MiiGoto/reaction-wheel-pendulum/mechanical/README.md

# Mechanical scope

候補寸法: 振子長約220 mm、wheel径約130 mm、wheel質量約90 g。寸法基準・材料・厚さ・支点位置・motor mounting・軸受・取付・clearanceはTBD。

次にCADと実測で重心、慣性、摩擦、wheel balanceを記録します。最大rpm、遠心力、保存energy、固定治具、guard、stopperを決めてから回転試験へ進みます。現段階では加工用図面やSTLを作成していません。
