MiiGoto/reaction-wheel-pendulum/docs/design_notes.md

# Design notes and decisions

## 2026-10-02: initial scope

**確定**: 一つのrepositoryでhardware/firmware/simulation/mechanical/docs/testを管理。今回の停止地点は初期構築。

**候補**: STM32G431、外部ESC/B-G431B-ESC1、3.3 V logic、補助5 V、AS5600。exact part/package、motor、sensor、bus方式は未選定。

**判断理由**: モータ・機構・正負トルク・センサ遅延が未確定のため、power stageや最終MCU pin配置の作り込みを先行しない。

## KiCad initialization

新規の `.kicad_pro` と `.kicad_sch` を作成。回路図の矩形・文字・破線は概念ブロックで、接続netや部品ではない。既存のKiCadファイルは編集していない。新規ファイルもnative CLIで読み込み、SVG出力とERCを検証する。

ブロック: Power input、input protection、5 V/3.3 V regulation、STM32G431、SWD、UART debug、CAN/FDCAN、IMU、encoder interface、motor/ESC interface、LEDs、buttons、test points。

PCBファイルは未作成。board outline・stackup・placement・routing・製造物は未実施。

## ERC warnings

意図的なwarning除外は設定しない。実行結果は `validation.md` に記録する。部品/netがない段階の0件は概念ファイルの初期チェックに過ぎず、電源/通信/実装の安全性検証ではない。次にsymbolsを追加した時点で改めて全severityのERCを実行する。

## Open design issues

通常のhobby ESCの速度commandだけで倒立制御の必要な正負トルク・低速応答を満たせるかは未確認。ホイールの速度飽和、回生、command timeout、sensorlessの低速挙動を評価する。AS5600をホイール高速測定に使えるとも仮定しない。

## 2026-10-02: Task 2 MCU / power / SWD

### Confirmed selection and package verification

- U1: **STM32G431RBT6**、LQFP64、10x10 mm body、0.5 mm pitch、64 lead、exposed padなし。Flash 128 KB、SRAM 22 KB + CCM SRAM 10 KB。ordering codeはDS12589 Table 101で照合。
- LQFP48 STM32G431CBT6も候補だが追加GPIO・clock・将来I/Oの余裕を優先しLQFP64を採用。BGA/QFNよりleadを目視でき、手実装・修理が容易。LQFP80/100は今回不要。
- KiCad 10.0.6 `MCU_ST_STM32G4:STM32G431RBTx` を使用。aliasの親symbolを解決して全64 physical pinをDS12589 Figure 10/Table 12のLQFP64列と照合。**64/64一致**。PG10はpin 7のNRST機能として使用し、BOOT0はPB8 pin 61。全番号はpinout表に記録。
- `Package_QFP:LQFP-64_10x10mm_P0.5mm`: 64 pad、pitch 0.5、pin 1はtop view左辺上端（角印）、番号は反時計回り、EPなし。DS12589 §6.5の10 mm body/12 mm lead spanと照合。padはleadの外側へ伸びるsolder landでありbody寸法と同一ではない。PCB設計時に採用実部品のdrawingと再照合する。
- 予約済み機能は同時使用可能なGPIOへ配置。PA13/14とPB3をdebug用に維持。PA11/12はFDCANの予約で、USBも同じpairを使うため同時使用には再割当が必要。CubeMX/DMA/clock詳細は後続タスク。

### MCU supplies and analog strategy

VDD 16/32/48/64、VBAT 1、VDDA 29、VREF+ 28を+3V3へ直結。VSS 15/31/47/63、VSSA 27をGNDへ接続。専用VREF-は外部padなし（内部でVSSAへbond）。VCAP/VDDIO2はこのpackageにないため追加しない。

DS12589 Figure 16のdevice-specific値を採用: VDD各100 nF + bulk 4.7 uF、VDDA 10 nF + 1 uF、VREF+ 100 nF + 1 uF。AN5093の一般例（bulk 10 uF / VDDA 100 nF）との値の違いはdevice datasheetを優先する。VBATはbattery未使用として100 nFを追加（AN5093 §2.1.3）。全capacitorは無極性ceramic。

初号機はVDDA/VREF+を同じ3.3 Vに直結しferrite/RC/LCは追加しない。AN5093 Table 10はferriteをoptionalとし直結を許容する。VDD/VDDAの起動差を作らず簡単に実装できる。ADC絶対精度はLDO ripple・基準誤差・ground returnの影響を受けるため未保証。**VREFBUFは無効/high impedanceのまま**（外部railへdriveしない）。精度要求と実測noiseに応じ将来見直す。

### Clock / reset / boot

- 外部HSE/LSEなし。内部HSI16と必要に応じPLLを使用する方針。初期起動・SWDには十分でcrystal/load-cap選定を省ける。制御周期、UART baud、FDCANのbit timingと温度範囲は未検証。将来FDCAN導入前にclock toleranceを評価し必要ならPF0/PF1にHSE追加。PC14/15もLSE予備として予約。USB clock対応を保証しない。
- NRST: MCU内部pull-up + C13 100 nF（AN5093 §2.2.3）、J2 pin 5からST-LINK reset、TP5で測定。external pull-up/reset buttonは初号機に追加しない。NRST_MODE=3（reset I/O default）を維持しPG10 GPIOへの変更を禁止。
- BOOT0: R1 10k pulldown、TP6でアクセス。通常flash起動の設定はnSWBOOT0=0/nBOOT0=1をbring-upで確認する。hardware pulldownはpin-controlled boot時にもlowを保つ。未書込flashのempty-checkによるsystem bootloader移行は故障ではない。実際のoption bytesは未設定。nBOOT1/BOOT_LOCK/RDPを不用意に変更しない。

### Power selection / protection / thermal assumptions

- 外部安定化5 V入力を採用、**J1実測4.8–5.25 V**、benchで供給側current limit <=150 mA。モータpower stageは分離、battery電圧は未確定のまま。
- U2 **AP2112K-3.3TRG1** / SOT25（SOT-23-5）、device rating 600 mAだがboard初期load budgetは**100 mA**。MCP1700級低電流LDOやbuckも比較対象とし、手実装できる5-lead package、簡単なEN接続、1 uF ceramicで安定するAP2112を採用。buckの効率は高いが100 mA初期条件には部品・switching noise・配線負担が増える。調達在庫は未確認。
- 公式AP2112 pinoutとKiCadを照合: 1 VIN、2 GND、3 EN、4 NC、5 VOUT。ENはVINへ直結、NCはno-connect。標準footprint SOT-23-5、5 pad、0.95 mm pitch、EPなし。top view pin 1左上/2左中央/3左下/4右下/5右上。
- D1 **Vishay SS14-E3/61T**、SMA/DO-214AC。anode pad 2=+5V_IN、cathode pad 1=+5V_PROTECTED。datasheet VF max 0.5 V @1 Aを保守的headroom計算に使用: 4.8−0.5=4.3 V、3.3 Vに1.0 V margin。AP2112 max dropout 0.4 V @600 mA以下。保護後VINは6 V recommended maximum以下とする。
- 最悪5.25 V、diode dropをゼロとしてLDO loss=(5.25−3.3)*0.1≈0.195 W。datasheet SOT25 thetaJA 184 °C/Wからrise≈36 °C（reference PCB依存）。室温25 °Cで約61 °Cの見積り。高温・600 mA・実PCB温度を保証する値ではなく、負荷追加時に再予算化する。
- C1/C2 nominal 4.7 uF /10 V/X7R/0805を使用。AP2112指定のeffective >=1 uFをDC bias・tolerance・温度込みで満たす実MPNを調達時に確認する。4.7 uF nominalだけでは条件充足を保証しない。
- 直列Schottkyで逆接対策を行う。current-limited short bench supply前提のためpolyfuse/TVSは追加しない。長い配線、motor rail、surge/ESD/独立電源からのbackfeedは未対策。VTrefから給電しない。電源未投入時にSWD信号をdriveしてphantom powerを起こさない。

### Debug, indicator and test access

J2はcustom 1x6/2.54 mm header。ARM 10-pin/1.27 mmはcompactで標準adapter向きだが、初号機はST-LINK個別wire接続が容易な2.54 mmを採用。標準ARM cableを直接挿すものではない。pinoutはdocs/pinout.md。SWOをPB3から追加。SWDIO/SWCLKは内蔵pullを使用（AN5093 §6.4）、external pullなし。PCBシルクに1/VTref/IO/GND/CLK/RST/SWOを明記する予定。

D2はKingbright **APT2012SECK** orange 0805。pad 1 cathode=GND、pad 2 anode=LED_A。R2 2.2kで、datasheet Vf typical 2.1 V（20 mAでの値）を参考とすると(3.3−2.1)/2200≈0.55 mA。低電流のVfは未保証なのでbrightnessは実測する。保守的Vf=0、rail上限3.3495 V・抵抗1%下限2178 ohmでも約1.54 mA、抵抗loss約5.2 mW以下（0.125 W級で十分）。

TP1 GND、TP2 input、TP3 protected input、TP4 +3V3（VDDA/VREFと同rail）、TP5 NRST、TP6 BOOT0。SWDIO/SWCLKはJ2でprobe可能。TestPoint_Pad_D1.5mmはprobe padで部品不要。

### Validation and unresolved issues

既存overviewは図形UUIDを保存して階層sheetを追加。標準symbolの継承を解決し、native parser/netlist/SVG/ERCで検証してから記録する。最初のERCのpower-output競合と重複stacked-pin wire warningは修正済み。意図的warning、exclusion、ignored checkは**なし**。最終結果はvalidation.md。

未決: actual passives/headers MPN、調達在庫、全load budget、PCB熱/ADC品質、ST-LINK adapter実配線、clock精度、CubeMX/DMA、silicon revisionに対応するerrata、option bytes実設定。Task 3前に人間が電源条件、SWD pinout、MCU/package、予約pinとCAN/USB競合をreviewする。PCB/routing/DRC/firmwareは今回実施しない。

### Errata review supplement

ES0431 Rev9 System limitations were checked for this circuit. SWD is used instead of full JTAG, and HSE-bypass/LSE are absent. For §2.2.6 backup-domain power-reset limitation, the initial bench power-cycle procedure requires both VDD and VBAT to fall below100 mV for >200 ms before reapplying power; otherwise a documented software backup-domain reset is required. The circuit alone cannot guarantee this discharge condition. Future firmware must handle reset/startup and revision-specific errata; these are not covered by ERC.

## Task 3 interfaces — 2026-10-02

Task2 branch was not merged into main. `feature/interfaces-sensors` is based on `a77dee8`; all implemented MCU/power/SWD connections retained. No power stage, PCB or firmware added. User confirmed RPM/encoder/ESC remain unknown and approved the external 3.3V ABI / PWM+active-high ENABLE+active-low open-drain FAULT connector contracts. These are controller specifications, not verified properties of an unidentified external device.

### AF correction and pin conflict review

DS12589 Table13 shows **PB6 has no I2C1_SCL**; Task2's reserved PB6/SCL entry was wrong. Impact: reservation/documentation only, pin was NC. Minimal fix: move reserved SCL to PA15 AF4, keep PB7 SDA AF4; PB6 free. Alternatives PB8/SCL would conflict with BOOT; PA13/SCL would conflict with SWD. No connected pin moved. SPI1 PA5/6/7 AF5 plus PA4 GPIO CS; FDCAN1 PA11/12 AF9; wheel TIM3 PB4/5 AF2; ESC TIM1 PA8 AF6; USART1 PA9/10 AF7; optional USART2 PA2/3 AF7 are separate. PC2 standby/PC3 index newly used. PB4's UCPD1_CC2 dead-battery behavior must be disabled per RM0440 before encoder input use; full JTAG is not enabled. Pin count:35used/12reserved/17free. CubeMX/DMA/interrupt co-allocation remains a firmware gate.

### CAN selection / termination / protection

| Candidate | Logic / supply / package | Decision |
| --- | --- | --- |
| TI TCAN334G | single3.3V, FD5Mbps, SOIC8, ±14V bus fault | simpler but insufficient margin with selected 24V TVS clamp |
| **TI TCAN3413DR** | VCC3.0–3.6V, VIO1.7–3.6V, SOIC8 D, ±58V fault, ±30V receiver common-mode | selected: VCC and VIO both3.3V, robust robot CAN |

Classical CAN and FD supported; TI describes certified EMC up to5Mbps and possible8Mbps in simpler networks. This board's bitrate remains TBD pending topology, cable, HSI16 tolerance and measurement; no8Mbps guarantee. TI ordering table lists TCAN3413DR active; distributor stock/pricing not verified. U3:1TXD,2GND,3VCC,4RXD,5VIO,6CANL,7CANH,8STB. STB high standby, R4=10k up; firmware pulls low only after initialization. R5=10k TXD up keeps recessive at reset. C14/C15=100nF each near corresponding supply pin (§8.4).

R3=120ohm1%, >=0.25W1206 with J4 shunt in series between CANH/CANL. 120ohm matches nominal twisted-pair characteristic impedance; fit only at the two physical bus ends to reduce reflections. Two ends measure about60ohm bus-wide. Intermediate nodes leave shunt absent (default OFF); permanently enabled termination would overload multi-node buses. At3.6V differential, dissipation=3.6²/120=0.108W, below0.25W; transient/thermal qualification remains physical testing.

D3=Nexperia PESD2CANFD24V-T, dual **bidirectional** CAN FD TVS, SOT23. Pins1 K1 CANH,2 K2 CANL,3 CC GND. 24V stand-off, typical6pF; specified maximum42V clamp at1A8/20us gives16V static margin to U3 ±58V absolute limit at that test condition. This does not guarantee higher-energy pulses or PCB overshoot. Place by J3 with short low-inductance GND path. No common-mode choke initially: short internal harness, no measured EMC need; avoid unqualified resonance/extra assembly. Revisit after noise/ESD tests. Neither isolation nor 24V CAN bus power interface provided.

### IMU selection / SPI / axes

| Candidate | Interface / ODR / ranges | Noise / buffering / package / availability |
| --- | --- | --- |
| **LSM6DSLTR** | SPI up to10MHz, I2C400kHz; accel/gyro up to6.664kHz; gyro±125..2000dps; accel±2/4/8/16g | gyro4mdps/sqrtHz, accel80ug/sqrtHz at2g typical;4KB FIFO,2INT; LGA14 3x2.5mm; ST active; selected |
| LSM6DSO | SPI/I2C/I3C, high-rate6-axis and same useful full-scale class | gyro3.8mdps/sqrtHz typical, larger FIFO; LGA14 same assembly class; current official datasheet/product, stock TBD; not needed for first prototype |

DSL selected for documented mature interface and sufficient rate; FIFO/noise/interrupt capability is not a measured control-loop result. IC is reflow LGA, **not** easy through-hole hand soldering; contract assembly or qualified reflow required. ST active-product status is not a purchasing guarantee. Choose four-wire SPI1 for deterministic burst access and bandwidth; a13-byte burst at8MHz takes13us wire time versus roughly0.3ms at400k I2C. Transaction setup, sensor filtering/group delay and ISR age are additional. Start1MHz mode3; final ODR/control rate TBD (1.666kHz is a planning point, not a requirement). IRQ INT1 active-high push-pull; disable unused INT2/DEN and sensor-hub functions. WHO_AM_I0x0F expected0x6A; use software reset, no external reset pin exists.

U4 pin1=SDO/MISO (not a strapped I2C address in SPI),2SDX and3SCX tied GND per ST §7.1 unused auxiliary-bus requirement;4INT1;5VDDIO;6/7GND;8VDD;9INT2/DEN NC;10/11NC unconnected but pads soldered;12CS;13SPC/SCK;14SDI/MOSI. VDD/VDDIO=3.3V within1.71–3.6V /1.62–3.6V ranges. C16/C17=100nF at each supply. R6=10k CS up; R7=100k SCK up (mode3 idle); R8/R9=100k MOSI/MISO down; R10=100k IRQ down at power-on. Input voltages must not exceed VDDIO+0.3V; no5V signals.

Placement constraints only: rigid mounting, low board strain, consider center near mounting datum; away from motor vibration, high-current returns and switching regulators. No placement performed. Define board frame +X toward right of board drawing, +Y upward, +Z out of component face (right handed); retain sensor-native X/Y/Z per DS Fig1. The final rotation matrix to pendulum/mechanical frame is **TBD** until board/mechanical orientation is chosen. PCB silk must show native sensor axes and pin1; physical axis/sign calibration and rotation review mandatory before manufacture/control. Do not silently equate the drawing frame with die axes.

### Encoder selection / speed requirements

| Candidate | Resolution / acquisition | Suitability / limits |
| --- | --- | --- |
| AS5600 |12bit, I2C/PWM/analog; sampling150us; slow-filter settling about2.2..0.286ms | no ABI; latency/wrap tracking need RPM budget; not automatically selected |
| AS5047P-class external ABI module |14bit SPI /12bit ABI, official selector max28000RPM, typical15mA | ABI timer avoids repeated serial polling; suitable candidate, **IC/module not fixed** |

Official AS5047P selector and indexed DS checked; full current DS URL failed to open. Air-gap, magnet/alignment tolerances, module supply strapping and actual logic outputs have not been verified, so no AS5047P IC circuit is placed. Candidate magnetic encoders require diametrically magnetized on-axis magnet and qualified field/alignment; AS5047P indexed field range35–70mT, mechanical gap depends on magnet and cannot be invented. Hall/ESC speed feedback has lower/unknown resolution and protocol/latency, so not the default measurement path. RPM/PPR and mechanical wheel safety remain TBD, confirmed by user.

Selected implemented **interface** is external board-powered3.3V push-pull A/B/Z, J5 with <=20mA port budget. R11–R13=100ohm series, R14–R16=100k down for defined disconnected levels; C18=100nF+C19=1uF local port supply. No5V, RS422 differential or open-drain module accepted without redesign. TIM3 encoder mode TI1/TI2 and PC3 index; signed count/overflow handling are future firmware. No RC on edges; timer digital-filter settings must preserve rate. `edge_rate=4*PPR*RPM/60` where PPR means cycles/channel/rev:4096counts/rev at28000RPM would be1.91MHz edges, not a tested capability. Actual module/cable/rate/filter must be verified before operation. Pendulum angle sensor remains unimplemented on reserved TIM2.

### ESC / UART / startup contract

Generic external ESC only:3.3V PWM, active-high enable, active-low open-drain fault, common logic ground, optional USART2. Motor power is separate. PWM rate/pulse encoding/direction/torque command/timeout are TBD. U5=SN74LVC1G126DBVR non-inverting **logic buffer**, not a gate driver:1OE,2A,3GND,4Y,5VCC3.3V; C20=100nF. R19=10k OE down; R20=100k PWM input down; OE0 gives high impedance, R18=10k on J6.1 holds PWM low. R17=100ohm series. Enable output R21=100ohm+R22=10k down. Reset drives neither command nor enable high; partial-power-down Ioff supported by U5. This defaults the controller outputs low, **does not prove the unknown ESC stops** or supply independent power isolation.

Fault R23=10k up3.3V at port, R24=100ohm intoPB0. External open-drain low means fault; disconnected wire reads inactive high, so this is not a broken-wire-safe safety channel. Require device communication/health checks before arming; no combinational FAULT-to-OE kill path and no firmware implemented. Reverse-torque/coast/brake, power-off behavior, regeneration and an independent manual motor isolation must be reviewed with actual ESC. OptionalUART2 idle TX R31=10k up, RX R30=100k up, R28/29=100ohm; do not enable until protocol/arming behavior known. Headers are exposed logic interfaces, not qualified ESD-isolated field ports.

B-G431B-ESC1 UM2516: board J3.4 accepts PWM3.3/5V, J3.5 GND. Its own CAN J1 and UART are alternative firmware-controlled paths; termination is board/firmware-dependent. No generic enable/fault interface on J3 is assumed. Example490Hz, Ton1060..1860us speed command requires appropriate MCSDK firmware; board not supplied with turnkey application. It does not establish bidirectional torque or low-speed control suitability. Connect PWM/GND only via reviewed adapter initially; never wire BEC +5V to this3.3V port. Actual board revision/adapter UART pinout remain TBD.

USART1 debug J7=TX,RX,GND,3.3V TTL USB-UART adapter only; R25/R26=100ohm, R27=100k RX up. No adapter power pin, no USB circuitry, no RS232 and no implicit5V-tolerance assumption. Different3-pin header from6-pin SWD; future silk must mark connector name, pin1, direction and voltage.

### Symbol / footprint / logical cross-check

Project-original `RWP:TCAN3413` and `RWP:PESD2CANFD24V-T` symbols have explicit official pin maps above and passive TVS terminals; no guessed alias or modified third-party standalone library. Project-local sym-lib-table uses `${KIPRJMOD}` only. Cached standard LSM6DSL (resolved alias),74LVC1G126 match physical14/5-pin tables. Native XML cross-check covers every new connected component pin, all64 MCU pins and preserved Task2 power/debug/capacitor nets; checks TVS mapping,120ohm shunt series path, SPI, ABI and PWM gate independently of ERC.

Footprints: SOIC8 3.9x4.9mm1.27mm pitch: pin1 upper-left,4 lower-left,5 lower-right,8 upper-right top view; no exposed pad. TVS SOT23 pins1/2 on one side,3 opposite (manufacturer top view). Buffer SOT23-5 pins1/2/3 down left,4/5 opposite. IMU LGA14 3x2.5mm border layout: pin1 left upper;1–4 left,5–7 bottom,8–11 right,12–14 top,0.5mm pitch, no extra central pad. Native installed footprint pads counted8/3/5/14, numbers complete. NC10/11 still soldered. Non-polarized ceramics; header pin1 square. Actual solder-land tolerances/paste/assembly axes are manufacturing-review items, not validated by ERC.

### ERC warnings and remaining gates

Intentional **one** pin_to_pin WARNING: U4.2 SDX (standard symbol bidirectional) tied to GND flagged as connected to power-output #FLG02. ST §7.1 explicitly requires unused SDX/SCX to GND or VDDIO; GND is selected. Do not leave SDX floating merely to clear ERC. No NoERC marker, excluded check or changed rule severity used; power PWR_FLAG is retained for the real supply. U4.9/10/11 NCs reflect disabled output/physicallyNC functions; unused MCU pins alone have NC. Final count in validation.md.

Firmware gates: ES0431 Rev9 SPI §2.14 BSY behavior on disable/slave (use master and bounded completion); FDCAN §2.15 edge filtering desynchronization (disable EFBI) and mixed dedicated/FIFO ordering (choose documented workaround), timer/UART restrictions against purchased REV_ID. No workaround implemented. HSI16 tolerance/FD bitrate, sampling latency, input edge-rate, power temperature and motor disable remain unmeasured. No PCB/DRC/manufacturing approval claimed.

## Task 4 review and placement — 2026-10-03

Task2/3 are not merged to main. `feature/pcb-placement` starts at Task3 cc09087 and retains Task2 a77dee8. Electrical pin assignments and component selections are preserved. Placement only; no routing, pours, manufacturing release or powered tests.

### Schematic / pin / safety review

| Block | Cross-check and result |
| --- | --- |
| POWER | J1 regulated5V4.8–5.25V, SS14 reverse-polarity diode, AP2112 EN/VIN/GND/NC/VOUT matched. C1/C2 ceramic effective capacitance must meet datasheet after DC bias. No motor power/BEC connection. 180mA load/25C bench thermal budget remains unmeasured. |
| MCU | STM32G431RBT6 LQFP64: all64 symbol pins compared to DS12589 package table and native netlist. VDD16/32/48/64, VSS15/31/47/63, VBAT1, VDDA29/VSSA27/VREF28, NRST7 and PB8 BOOT0 preserved. HSI16 selected; VREFBUF disabled, VREF+ tied analog supply, analog decoupling retained. |
| AF / unused | FDCAN PA11/12 AF9; SPI1 PA4–7 AF5; TIM3 PB4/5 AF2 encoder; TIM1 PA8 AF6 PWM; USART1 PA9/10 AF7; USART2 PA2/3 AF7; PA13/14 SWD, PB3 SWO. No conflicts or connected-pin moves. PA15/PB7 AF4 future I2C remains reserved. PB4 dead-battery behavior requires PWR_CR3.UCPD1_DBDIS before encoder use. 35used/12reserved/17free, NC on deliberately unconnected schematic pins, firmware must configure unused pins appropriately. |
| DEBUG / UART | J2 custom6pin SWD including target reference/NRST; J7 TX/RX/GND, 3.3V adapter only. Not ARM10pin/RS232; reference must not power target. Pin1/silk legends checked. |
| CAN | TCAN3413 VCC/VIO3.3V, separate100nF caps, STB10k high default standby, TX pull-up. TVS1CANH/2CANL/3GND, bidirectional, >=24V stand-off vs58V bus fault rating; clamp performance/ESD remains real-test item. 120ohm1% >=0.25W via removable shunt, OFF unless at bus end. No common-mode choke pending EMC evidence. |
| IMU | LSM6DSL full14pin map,3.3V VDD/VDDIO,100nF per supply, SPI4wire CS high/SCK high/pulls, INT1 active-high planned. SDX/SCX grounded per ST7.1; INT2/DEN disabled, physical NC pads retained. Native package pin1 verified; die-axis mapping to mechanics remains TBD. |
| ENCODER | J5 external3.3V push-pull ABI module, timer A/B and index, series resistors/pull-downs and local supply decoupling. Actual module/RPM/PPR/magnet/latency unknown; no encoder IC or inferred5V compatibility. |
| ESC | J6 user-approved3.3V PWM/active-highEN/active-low open-drainFAULT contract, optional USART2. U5 pin1OE/pin2A/pin3GND/pin4Y/pin5VCC checked. EN/PWM pull-downs and OE gate suppress output during reset/unpowered MCU. FAULT pull-up means unplug reads inactive; cannot detect broken wire independently. Actual ESC is not yet qualified. |

Finding: previous bring-up text incorrectly required ESC EN/PWM low during **SWD halt**. A halted core can retain asserted GPIO/timer outputs; reset defaults do not guarantee halt/frozen-firmware safety. Corrected the test plan. Independent motor power isolation and qualified ESC timeout/watchdog/arming are mandatory before powered motor tests; no new safety circuit or firmware claimed here.

Schematic changes: added four mechanical hole symbols so PCB/schematic remain equivalent; excluded16 bare test pads from BOM and position files consistently. No new electrical circuit or pin reassignment. ERC:0errors/1warning. Category C (standard bidirectional SDX vs power-output GND flag), intentionally retained per ST; no NoERC/excluded checks. No outstanding category A or D ERC message. External-device and safety judgments remain separate review gates.

### Footprint / BOM review

Installed KiCad10 standard pad numbering, pitch/body and pin1 were compared to manufacturer drawings; embedded board footprints match their libraries. Full actual pad sizes, positions, rotations and counts: [footprint_review.csv](footprint_review.csv).

| Ref | Native footprint / manufacturer package | Verification |
| --- | --- | --- |
| U1 | LQFP-64_10x10mm_P0.5mm |64pads,0.5pitch,10x10body, noEP, counterclockwise numbering/top-view pin1. Pads1.55x0.30mm. |
| U2 / U5 | SOT-23-5 / AP2112 SOT25 and TI DBV |5pads,0.95pitch,~2.9x1.6body, noEP. Pin numbers matched individually; pads1.325x0.60mm. Prototype toe extension differs from the manufacturer's example land geometry; assembly process must qualify lands/paste. |
| U3 | SOIC-8_3.9x4.9mm_P1.27mm / TI D |8pads,1.27pitch,3.9x4.9body, noEP. Pads1.95x0.60mm. |
| U4 | LGA-14_3x2.5mm_P0.5mm_LayoutBorder3x4y |14pads,0.5pitch,3x2.5body, no centralEP. Border pads0.625x0.35mm. Native0.15mm adjacent-pad gap requires explicit local clearance rule, not global relaxed clearance. Reflow/stencil inspection needed. |
| D1 | D_SMA / Vishay DO-214AC |2pads, cathode1/anode2; stripe/polarity checked; pads2.5x1.8mm. |
| D2 | LED_0805_2012Metric / Kingbright APT2012SECK |2x1.25body, cathode1/anode2, polarity marker; pads0.975x1.4mm. Existing low-current R2 calculation retained. |
| D3 | SOT-23 / Nexperia SOT23 |3pads,1/2same side,3opposite,1.9mm outer-lead pitch; noEP, pads1.475x0.60mm. Bidirectional TVS has no series-diode polarity. |
| J1–J7 | 2.54mm vertical single-row THT headers | Samtec TSW family geometry:0.64square posts,2.54pitch. KiCad1.0drill/1.7pad. Specific plating/length/mating housing not selected; no keying. |
| R / C |0805metric2012, R3termination1206 | Hand solder/rework priority; no0402. Exact passive MPNs, DC-bias capacitance and power/voltage ratings before procurement. |
| TP1–16 / H1–4 |1.5mm bare-pad probes /3.2mm M3 NPTH | No bought testpin assumed. Holes have no electrical net;4mm radius head/spacer reserve. Excluded from electrical BOM. |

86 footprints:5IC+20capacitors+31resistors+3diodes+7headers+16probe pads+4holes.66 purchasable electrical component positions, no accidental DNI; screws/spacers separate TBD. No redundant protection or obviously inconsistent values/package found. Official documents remain available; actual stock/lifecycle/orderable passive/header MPNs are not established by this review. LQFP/SOIC/0805 support rework; LGA IMU requires competent reflow, not a promised hand-iron assembly.

### PCB decisions / remaining gates

See [pcb_placement.md](pcb_placement.md): preliminary90x70mm,4layers,4M3holes, all top, no copper tracks/vias/zones. Native DRC after placement repairs:0physical violations,0schematic parity issues,173unrouted items. Initial overlaps/pad/silk collisions were corrected by placement/legend changes. Fine-pitch U4 internal0.15mm clearance is geometry-driven and still requires manufacturer acceptance.

Routing must establish short local capacitor-return loops, uninterrupted GND, CAN return/TVS discharge path, and actual power thermal margin. IMU native axes/rigid mount relative to pendulum, connector housings/cable strain/clearance, actual ESC/encoder behavior, HSI CAN-FD timing, supplier stackup/clearance and sensor assembly/paste are human gates before Task5. Missing3D models do not validate mating height;2D pads/courtyards were reviewed. No Task5 begun.

## Task 5 routing strategy — user-approved continuation

User approved90x70mm outline, fourholes and connector placement; authorized restoring Task4 net classes/checks and delegated IMU orientation. Keep U4 rotation0 initially, verify actual sensor-axis mapping before final silk. Official ST PDF image acquisition timed out via two direct methods; do not guess native axes or repeat downloads indefinitely.

Order: local MCU decoupling, power/regulator, analog and GND returns, IMU SPI, ABI, CAN, SWD, UART, ESC, remaining GPIO. Manual explicit polylines through native KiCad API, no pathfinder/autorouter. L1 local signals, L2 continuous GND, L3 common3V3 distribution and limited auxiliary signals, L4 remaining signals. Ground stays common, no analog split.0.50mm power branches; fine-pitch power pad escape requires short0.20mm necks due0.5mm pitch, then widen. Retain0.20mm general clearance and U4 native0.15mm internal pad exception. Local plane access0.60/0.30mm through vias, adjacent return vias at connectors;4mmradius screw/spacer copper/track/via keepouts. No fabrication outputs.

### Task 5 power/ground stage result — incomplete task

User approved mechanical outline/holes/connectors, delegated IMU orientation and allowed restoration of Task4 classes/checks. Preserve unrelated existing GUI/BOM/display settings; local pre-edit copy retained outside repository. POWER/CAN patterns, minimums and all ERC/DRC severities restored; no ignore or exclusion used.

C1 rotated180degrees **at the same position** to face VIN pad toward U2 and avoid routing across its ground pad; same numbered footprint pads/nets. All other physical placements/rotation remain Task4. Manual explicit segments via native pcbnew, no automatic pathfinding/router. Power input→SS14→C1/AP2112→C2→common3V3; LED and power probes routed. All MCU VDD/VBAT/VDDA/VREF and IC decoupling feeds connected, local cap/MCU GND vias to In1.Cu. No invented analog split. LDO is linear, no switch-node/inductor. Thermal rise remains preliminary and unmeasured.

Native initial DRC exposed local ground-via/adjacent-pad and LED crossings. One placement/route repair pass moved MCU ground access inside the package body (outside solder pads), rerouted LED, changed several local via exits and rotated C1. Final physical violations0. Fine-pitch0.20mm3V3 pad necks are required by0.5mm pitch and0.3mm MCU pad width; branches widen to0.50mm. Official supported `intersectsCourtyard` rule narrowly applies the neck minimum at U1/U4; general clearances remain0.20mm. Short-neck expression was corrected before final validation; no suppressed violations. Native API save may rewrite class settings, so restore/verify approved project configuration after native saves and use absolute CLI paths.

147track segments/78through-vias. Vias0.60mm diameter/0.30mm drill; local supply returns/rail access and connector return access, not a perimeter carpet. L2 GND and L3+3V3 zone each refilled to **one connected copper polygon**; isolated islands removed by fill setting. Four all-copper keepouts radius4mm protect screw/spacer envelopes. Plane images reviewed: continuous common GND except necessary anti-pads/mounting keepouts; no signal trace slots. THT plane contacts currently solid, rework/thermal relief and exact supplier stackup still need review before manufacture. No device has an exposed thermal pad.

**Routing is incomplete:**37distinct signal nets,73unconnected DRC items. IMU SPI/INT, ABI, CAN, SWD/reset/BOOT, UART and ESC signals remain unconnected. Thus no claim of signal return-path/signal-integrity validation, completed CAN protection discharge layout, final silkscreen or final DRC closure. Existing reset default pulls/gating are preserved electrically but cannot be tested on this incomplete PCB. No firmware/hardware power-up/fabrication output.

Blocking issue after bounded attempts: ST LSM6DSL official Fig1 graphical axes could not be inspected. Web text is available; raw PDF download timed out via urllib and PowerShell, browser PDF opening returned blocked-by-client, and web screenshot did not provide inspectable pixels through this tool. Do not invent die axes from text X/Y/Z alone. Choose to keep verified Task4 U4 rotation0/pin1 upper-left, but final native X/Y/Z mapping and axis silk remain unverified. Under user Task5§46 repeated-issue stop rule, record this checkpoint rather than endlessly retry source retrieval. Need an accessible official Fig1/page18 image/PDF or an accessible manufacturer diagram before final axes/review. Other signal routing is also outstanding, not declared complete due this checkpoint.

## Task 5 resumed review — 2026-10-03

The supplied official LSM6DSL DocID028475 Rev7 PDF resolves the previous document-access blocker. Figure1/page18 and package Figure17/page110 were visually reviewed. Retain U4 rotation0/pin1 upper-left. Board top-view reference frame is +X to the right,+Y toward the upper edge,+Z out of the component side. Mapping inferred by combining the official top-view axes, top pin1 indicator,3.00x2.50mm body and numbered footprint: native sensor +X right,+Y upper edge,+Z out; identity board transform for accelerometer and gyroscope axes. Do not mirror the bottom-view pin drawing into the sensor top view. Mechanical pendulum/pivot transform and physical sign/known-rotation checks remain TBD. Final axis silkscreen is still outstanding.

CAN初期draftで交差・短絡を検出し修正。追加試行は自動承認レビューで上限超過と判定され停止したが、ユーザーが明示的にあと1回を許可し、CANバスの物理違反は解消した。Native pcbnew Remove処理のSWIGエラーで保存前に失敗した操作もあり、保存済み電源checkpointを基準に新規CAN配線を再構築して検証した。これらは途中経過であり、現在の未解決問題は以下のIMU段階。

### Superseding resumed checkpoint

User explicitly approved one extra CAN repair; CAN bus/protection/termination/probes then had0physical violations, and TX/RX/STB were connected in a separate bounded stage. IMU draft used short L3 trunks adjacent continuous L2GND and local top escapes, with low-rate IRQ/bottom bridges. After3IMU checks,2MOSI/GND errors remain; stop. Final current count47Errors/0Warnings (2physical+45unconnected),0parity.318tracks/108vias, L2GND/L3+3V3 each one polygon. Earlier67Error draft and pending CAN gate above are historical, not current. Full details/remaining nets/human decision in [task5_routing_checkpoint.md](task5_routing_checkpoint.md). No further retry, no complete routing claim.

## Task 5 completed routing — supersedes stopped drafts

2026-10-03: resumed at user request. KnownMOSI/GND errors resolved; all SWD/BOOT/reset, ABI, UART, ESC default pulls/gating/fault and optionalUART nets routed. NativeDRC0Error/0Warning/0unrouted/0parity; ERC0Error/1intentionalWarning. No components moved, no net/pin changes, no design-rule relaxation/exclusion. Native SaveBoard can normalize project settings; exact approved settings were preserved, only DESIGN_STATUS updated.

Full routing strategy/layer/power/GND/IMU/CAN/via/connector/safety/visual review and outstanding release gates: [task5_routing_review.md](task5_routing_review.md).548segments/155through-vias; L2GND/L3+3V3 each one polygon. R0.5 silk axes added. No DRC warning remains. Task6/manufacturing/powered tests not started; DRC pass is not system qualification.
