MiiGoto/reaction-wheel-pendulum/docs/architecture.md

# Initial system architecture

概念設計。矢印は機能上の関係であり、電気的な配線・ピン番号・コネクタ指定ではない。

```mermaid
flowchart TB
  subgraph Power
    Supply[Battery / Power supply: TBD] --> Protection[Input protection: TBD]
    Protection --> Regulation[Power regulation: 5 V / 3.3 V candidates]
    Protection --> MotorRail[ESC power branch: TBD]
    Isolate[Manual motor power isolation] --> MotorRail
  end
  subgraph MCU
    G431[STM32G431 candidate: exact part/package TBD]
    Control[Sampling / estimation / control / safety]
    G431 --- Control
    Debug[SWD / NRST / UART debug]
    G431 --- Debug
    UI[LEDs / buttons / test points]
    G431 --- UI
  end
  Regulation --> G431
  subgraph Sensors
    IMU[IMU: TBD]
    Pendulum[Pendulum angle encoder: TBD]
    WheelSense[Wheel angle / speed encoder: TBD]
  end
  Regulation --> IMU
  Regulation --> Pendulum
  Regulation --> WheelSense
  IMU --> G431
  Pendulum --> G431
  WheelSense --> G431
  subgraph Communication
    Bus[FDCAN controller in MCU]
    Transceiver[External CAN transceiver: TBD]
    UART[UART: TTL level TBD]
    USB[USB: optional, pin conflict review]
  end
  G431 <--> Bus
  Bus <--> Transceiver
  G431 <--> UART
  G431 -.-> USB
  subgraph PC
    Adapter[CAN adapter / USB-UART / ST-LINK]
    Log[Logging / configuration / simulation comparison]
    Adapter <--> Log
  end
  Transceiver <--> Adapter
  UART <--> Adapter
  Debug <--> Adapter
  subgraph Motor
    Interface[BLDC interface: PWM / UART / CAN TBD]
    ESC[External ESC / B-G431B-ESC1]
    BLDC[BLDC motor: TBD]
    Wheel[Reaction wheel]
    Control --> Interface
    Interface <--> ESC
    MotorRail --> ESC
    ESC --> BLDC
    BLDC --> Wheel
  end
  Wheel -. mechanical reaction .-> Pendulum
  Wheel -. feedback .-> WheelSense
```

## Boundaries

- 自作controller案: Power input、input protection、5 V/3.3 V regulation、MCU、SWD、UART、CAN transceiver、IMU/encoder interface、ESC interface、LED/button/test points。
- 初期power stage: 外部ESC。controllerのロジック電源をmotor power配線に直結できるとは仮定しない。
- B-G431B-ESC1: 独自のMCUを持つ評価ボードであり、自作controller上のMCUと同一個体ではない。上位姿勢制御とESCのmotor controlの役割を分離するか、評価ボード単体で検証するかはTBD。
- PC: 設定とログ、model比較。PC切断時も安全状態へ移行できる構成を要求する。
- センサ: 異なる時刻の値を混ぜない。共通time baseと角度/回転方向の符号定義を作成する。

電源・GND・回生の検討は [power_tree.md](power_tree.md)、GPIO需要は [pinout.md](pinout.md) を参照。

## Task 2 implementation boundary

Concept above remains the whole-system target. Only the control-board branch is implemented: external regulated5 V → SS14 → AP2112K-3.3 → STM32G431RBT6, decoupling, NRST/BOOT, SWD/SWO, power LED and probe points. Sensors/CAN/UART/encoder/ESC/USB have no interface circuits yet. Their MCU pins are provisional reservations in pinout.md; motor supply/battery/regen remains TBD.

## Task 3 implemented interface architecture

```mermaid
flowchart LR
 P[Regulated bench 5V] --> L[AP2112K 3.3V / 180mA budget]
 L --> M[STM32G431RBT6 / power and SWD retained]
 L --> C[TCAN3413DR / VCC and VIO 3.3V]
 L --> I[LSM6DSLTR / VDD and VDDIO 3.3V]
 M <-->|FDCAN1| C
 C <--> T[TVS + selectable120ohm / J3 CAN bus]
 M <-->|SPI1 + INT1| I
 E[External 3.3V push-pull ABI module / J5] -->|TIM3 A/B + PC3 index| M
 M -->|TIM1 PWM + GPIO EN| G[Logic buffer / default low]
 G --> X[External ESC / J6 / type TBD]
 X -->|Open-drain FAULT_N| M
 M <-->|Optional USART2| X
 M <-->|USART1 / J7 3.3V TTL| A[USB-UART adapter]
 A <--> PC[PC logging]
 MP[Separate motor power / voltage TBD] --> X
 X --> B[BLDC] --> W[Reaction wheel]
```

Controller includes no BLDC power bridge. PC adapter and external motor/encoder hardware are not implemented in this repository. Pendulum angle sensing remains reserved TIM2; IMU frame/control model TBD. CAN GND, ESC GND and encoder GND are logic references, not high-current motor paths. B-G431B-ESC1 is an evaluation option with adapter/firmware constraints, not a guaranteed genericJ6-compatible ESC.
