MiiGoto/reaction-wheel-pendulum/docs/routing_progress.md

# Current routing progress

Task5 routing complete,2026-10-03:548segments/155through-vias; DRC0Errors/0Warnings/0unrouted/0parity; ERC0Errors/1intentionalWarning. Four layers,90x70mm. Not a manufacturing release or powered verification.

Current source is reaction_wheel_controller.kicad_pcb. See [routing review](task5_routing_review.md) and [current checkpoint](task5_routing_checkpoint.md).

routing_power_stage.csv and routing_interfaces_draft.csv are historical partial manual-route manifests; they do not list every final route and are not current connectivity evidence. Earlier73/47-error checkpoints are superseded. Source-native DRC and schematic parity are authoritative for current connectivity.
