MiiGoto/reaction-wheel-pendulum/docs/task5_routing_checkpoint.md

# Task 5 current state — routing complete, not released

2026-10-03. feature/pcb-routing, based on Task4 and b1e6c23; user authorized continuation. Previous stopped draft was47DRC errors/26unrouted nets. That result is historical and superseded.

Current native KiCad10.0.6: **DRC Error0 / Warning0 / unrouted0 / schematic parity0**. ERC0Errors/1intentional SDX/GNDWarning.548track segments/155through-vias,86footprints,90x70mm/4layers; two refilled zones each one connected polygon. No rule relaxation or excluded violations.

MOSI short resolved, SWD/reset/BOOT, ABI, UART and all external ESC control/optionalUART nets connected. All86 component positions/rotations preserved; schematic/pin/connector order unchanged. Added IMU axes and ROUTED / NOT RELEASED silk.

See [full routing review](task5_routing_review.md) for layer/return-path/logic/visual verification and limits, and [bring-up](bringup.md) for future tests. Exact BOM, stackup/assembly, actual ESC/encoder, mechanical transform and physical safety/thermal/EMI verification remain release gates.

Task5 routing/review complete at the documented prototype scope; manufacturing release, physical tests and Task6 are not performed. Prior incomplete source/results remain recoverable through Git history and local ignored checkpoints. No Gerber/drill/PnP output, orders or firmware implementation.
