MiiGoto/reaction-wheel-pendulum/docs/sources.md

# Official source verification record

確認日: 2026-10-02。資料は公式URLを記録し、vendor PDF/SDKそのものは公開repositoryへ含めない。候補部品の存在確認と、採用回路を設計可能な詳細reviewを区別する。

| Source | Revision / sections checked | Finding / scope | Remaining work |
| --- | --- | --- | --- |
| [STM32G431 datasheet DS12589](https://www.st.com/resource/en/datasheet/stm32g431rb.pdf) | Rev 6、198 pages。Device summary、Table 12 pin definition、Table 13 alternate functionsをWeb閲覧 | G431候補、SWD PA13/PA14、PB8-BOOT0とAF競合に注意。package未選定のため物理番号は割当しない | 選定ordering codeの対象package列、全電源pin、電気特性、footprintを詳細確認 |
| [STM32G4 reference manual RM0440](https://www.st.com/resource/en/reference_manual/dm00355726-stm32g4-series-reference-manual-stmicroelectronics.pdf) | Rev 9。公式URLのindexed textからdevice feature table、30.4.18 Encoder interface mode (pp.1334-1335)を確認 | G431向けperipheral範囲とencoderのTI1/TI2・count方向・filter/ARR確認の必要性を確認 | PDF全体はWeb容量制限、ローカルST downloadはtimeout。全register/clock/boot/DMAの詳細reviewは未完了 |
| [RM0440 encoder section alternate official URL](https://www.st.com.cn/resource/en/reference_manual/dm00355726-stm32g4-series-advanced-armbased-32bit-mcus-stmicroelectronics.pdf) | Rev 9、30.4.18のindexed textを照合 | 二入力quadrature encoderを需要表に反映。family全timerがG431にあると仮定しない | selected MCUでのtimer存在・AF pairをDSとCubeMXで照合 |
| [B-G431B-ESC1 UM2516](https://www.st.com/resource/en/user_manual/dm00564746-electronic-speed-controller-discovery-kit-for-drones-with-stm32g431cb-stmicroelectronics.pdf) | Rev 4の導入・board identificationを確認 | 外部motor-control評価候補。controllerとESC側MCUの役割分担はTBD | 実board revision、power/command/connector/safety詳細review |
| [G431/G441 errata ES0431 entry](https://www.st.com/en/microcontrollers-microprocessors/stm32g4x1/documentation.html) | 文書一覧で存在確認のみ | errataをdesign gateに含める | selected silicon revisionと使用peripheralの全関連errata確認 |

## Design gate

回路部品を追加する前に、採用部品の公式資料を読める状態にして、資料revision・section・pin/voltage/clock・未使用pin処理を記録する。上記の部分確認だけで最終MCU回路や電源回路を設計しない。

AS5600、IMU、transceiver、regulator、motor/ESC、connector、protection部品はまだ選定していないため、採用資料reviewも未実施。値や回路を推測で固定しない。

## Task 2 reviewed sources (2026-10-02)

Earlier rows record Task 1's historical limits; below supersedes them for the MCU/power/SWD scope.

| Primary source | Revision / reviewed sections | Applied result / limits |
| --- | --- | --- |
| [ST DS12589](https://www.st.com/resource/en/datasheet/stm32g431rb.pdf) | Rev 6, §3.7/3.11/3.13, Fig10, Table12/13, Fig16, §6.5, Table101 | All64 physical pins, power ranges/decoupling, debug/clock/boot, reservation AF and LQFP64 checked. Full analog performance/clock budget remains future work |
| [ST AN5093](https://www.st.com/resource/en/application_note/an5093-getting-started-with-stm32g4-series--hardware-development-boards-stmicroelectronics.pdf) | Rev 2, §2.1/2.2, §4/5/6.4/7.4, Table10 | VBAT connection, internal reset pull-up +100nF, boot, SWD internal pulls, optional analog ferrite/direct connection |
| [ST RM0440](https://www.st.com/resource/en/reference_manual/rm0440-stm32g4-series-advanced-armbased-32bit-mcus-stmicroelectronics.pdf) | Rev 9 official indexed text: boot Table5, Category2 FLASH_OPTR, §9.3.15/16 PG10/PB8 reset/boot selection, RCC clock selection | nSWBOOT0/nBOOT0 and NRST_MODE verified. Full PDF exceeded web size limit; all register programming/clock/DMA review is not claimed |
| [Diodes AP2112](https://www.diodes.com/datasheet/download/AP2112.pdf) | DS39724 Rev 2-2, pp1–3, 3.3V electrical table, ordering/package pages | SOT25 1VIN/2GND/3EN/4NC/5OUT, EN tied input, 1uF ceramic stability, headroom/thermal, exact ordering code |
| [Vishay SS12–SS16 family](https://www.vishay.com/docs/88746/ss12.pdf) | Document88746, ratings/package/ordering | SS14 40V/1A, VF max0.5V at1A, SMA cathode marking and pin orientation |
| [Kingbright APT2012SECK](https://www.kingbrightusa.com/images/catalog/SPEC/APT2012SECK.pdf) | V17A, 2025-03-17, dimensions/electrical characteristics | orange0805 polarity and Vf2.1typ/2.5max at20mA. Brightness at selected sub-mA remains untested |
| [KiCad libraries license](https://www.kicad.org/libraries/license/) | CC-BY-SA4.0 with design-file exception | cached standard symbols permitted in design artifacts. No vendor PDFs/library collections copied into repository |

Silicon-specific ES0431 errata review against the purchased revision remains a powered bring-up / future peripheral gate; current circuit makes no peripheral performance claims. Standard KiCad library files are installed locally and were checked against package drawings, not merely matched by symbol names.

### ES0431 circuit-scope cross-check

[ST ES0431 Rev9 (June2024)](https://www.st.com/resource/en/errata_sheet/es0431-stm32g431xx441xx-device-errata-stmicroelectronics.pdf): summary and System §2.2.1–2.2.10 reviewed. SWD avoids the full-JTAG/PB4 limitation. HSI-only design has no HSE-bypass/LSE circuit. Backup-domain reset after partial supply decay is a real concern even with VBAT tied VDD; bring-up must confirm VDD/VBAT <100 mV for >200 ms before repowering, or implement the documented firmware backup-domain reset on power-on. No firmware workaround is implemented in Task2. Low-power debug, SRAM initialization, flash programming interruption and silicon-revision-specific peripheral limitations remain firmware/bring-up checks. Identify REV_ID before peripheral enable.

## Task 3 primary-source verification (2026-10-02)

Historical Task1/2 selections above are superseded for this interface scope. No vendor PDF/tool/SDK is committed.

| Primary source | Revision / reviewed sections | Applied result / limits |
| --- | --- | --- |
| [DS12589 G431 family](https://www.st.com/resource/en/datasheet/stm32g431r8.pdf) | Rev6 Tables12/13, samex6/x8/xB family pinouts | physical64pin andSPI1/FDCAN1/TIM1/TIM3/USART1/2/I2C1 AF rechecked; corrected PB6 reservation; no connected reassignment |
| [RM0440](https://www.st.com/resource/en/reference_manual/rm0440-stm32g4-series-advanced-armbased-32bit-mcus-stmicroelectronics.pdf) | Rev9 indexed encoder30.4.18, GPIO/UCPD requirements | TI1/TI2 quadrature, PB4 special startup noted; full peripheral/register/DMA review not claimed |
| [TI TCAN3413](https://www.ti.com/lit/ds/symlink/tcan3413.pdf) | SLLSFS8A Nov2023, §4pinout, §5limits/current, §7modes, §8termination/caps, Dpackage | exact8pin, VCC/VIO3.3V, standby high, ±58V, ±30V, FD claims and100nF each reviewed |
| [TI TCAN33x](https://www.ti.com/lit/ds/symlink/tcan332.pdf) | RevF May2025 device comparisons/limits | TCAN334G candidate, not selected; limited ±14V fault margin |
| [Nexperia PESD2CANFD24V-T](https://assets.nexperia.com/documents/data-sheet/PESD2CANFD24V-T.pdf) | 2020-08-11, pin/characteristics/SOT23 sections | bidirectional1K1/2K2/3CC,24V,42V@1A,6pF; clamp condition not arbitrary transient guarantee |
| [ST LSM6DSL](https://www.st.com/resource/en/datasheet/lsm6dsl.pdf) | DocID028475 Rev7, Tables2–7, §7.1mode1, §9.12ID, §10package | all14pins, SPI10MHz, voltages/caps/unused auxiliary bus/NC, ID0x6A, LGA14 reviewed |
| [ST LSM6DSL product](https://www.st.com/en/mems-and-sensors/lsm6dsl.html) | active-product/order status | LSM6DSLTR exists; supplierstock/pricing not asserted |
| [ST LSM6DSO](https://www.st.com/resource/en/datasheet/lsm6dso.pdf) | DS12140 Rev3, overview/mechanical characteristics | alternate IMU, not designed in; lower gyro noise/larger FIFO, same reflow class |
| [ams AS5600](https://look.ams-osram.com/m/7059eac7531a86fd/original/AS5600-DS000365.pdf) | v1-06, sampling/slow-filter indexed table |12bit serial/PWM candidate, latency comparison, no IC circuit placed |
| [ams position-sensor selector](https://look.ams-osram.com/m/8afbfbd9bb094a0f/original/Position_Sensors_FS001005_2-00.pdf) | FS001005_2-00 official family table | AS5047P14bitSPI/12bitABI/28000RPM/typ15mA candidate, external module TBD |
| [AS5047P full datasheet entry](https://look.ams-osram.com/m/d05ee39221f9857/original/AS5047P-DS000324.pdf) | indexed magnet field text only; full URL returned404 | incomplete: do not fix IC/module, magnet gap, supply strapping or logic until actual module official資料確認 |
| [TI SN74LVC1G126](https://www.ti.com/lit/ds/symlink/sn74lvc1g126.pdf) | SCES224S Aug2026, pin/truth/limits/Ioff/DBV sections | active-high OE,5pinSOT23,3.3V,Ioff,decoupling; logic buffer not motor gate driver |
| [ST UM2516](https://www.st.com/resource/en/user_manual/dm00564746-electronic-speed-controller-discovery-kit-for-drones-with-stm32g431cb-stmicroelectronics.pdf) | Rev4, hardware UART/CAN and §5PWM pp20–21 | J3.4PWM/J3.5GND3.3/5V,490Hzexample,MCSDK prerequisite; no assumed genericEN/FAULT or bidirectional torque |
| [ST ES0431](https://www.st.com/resource/en/errata_sheet/es0431-stm32g431xx441xx-device-errata-stmicroelectronics.pdf) | Rev9 June2024 summary, §2.14SPI / §2.15FDCAN | BSY / edge-filter / FIFO-order limitations recorded as firmware gates; siliconREV_ID/peripheral workarounds TBD |

Custom RWP symbols are original simple shapes/pin tables; standard KiCad symbols are only cached inside design files under the design exception. Native library matching/ERC checks retained. Manufacturer package drawings versus installed footprint pin count/order/pitch reviewed; assembly process and physical sensor-axis mapping await PCB/mechanical review.

## Task 4 official cross-check — 2026-10-03

Reviewed package/pin/supply/decoupling/logic drawings against installed KiCad symbol and native PCB pads:

- ST [STM32G431RB DS12589 Rev6](https://www.st.com/resource/en/datasheet/stm32g431rb.pdf), LQFP64 figure/table12 and AFtable13; [AN5093 Rev2](https://www.st.com/resource/en/application_note/an5093-getting-started-with-stm32g4-series--hardware-development-boards-stmicroelectronics.pdf) for G4 supply/reset/SWD/PCB recommendations. Official RM0440 download was unavailable in this review; retained prior documented timer/encoder reference checks, not a claim of full manual rereading.
- Diodes [AP2112 DS39724 Rev2-2](https://www.diodes.com/datasheet/download/AP2112.pdf):SOT25 pinout, ceramic input/output >=1uF, dropout/thermal and lands.
- TI [TCAN3413 SLLSFS8A](https://www.ti.com/lit/ds/symlink/tcan3413.pdf):SOIC8/3.3V VCC/VIO/STB/decoupling/bus limits; [SN74LVC1G126 SCES224S](https://www.ti.com/lit/ds/symlink/sn74lvc1g126.pdf):DBV5pin/OE/logic/Ioff.
- ST [LSM6DSL DocID028475 Rev7](https://www.st.com/resource/en/datasheet/lsm6dsl.pdf):table2,7.1 unused auxiliary SPI and capacitors, section10 LGA14; Figure1 die axes need final graphical/mechanical mapping review.
- Nexperia [PESD2CANFD24V-T](https://assets.nexperia.com/documents/data-sheet/PESD2CANFD24V-T.pdf):SOT23 pins/common ground/bidirectional clamp; Vishay [SS12–SS16](https://www.vishay.com/docs/88746/ss12.pdf):SS14 SMA/polarity/current limits.
- Kingbright [APT2012SECK](https://www.kingbrightusa.com/images/catalog/SPEC/APT2012SECK.pdf):0805 geometry/polarity/LED ratings; Samtec [TSW family drawing](https://suddendocs.samtec.com/catalog_english/tsw_th.pdf):2.54pitch/0.64post family compatibility only; ordering/mating options TBD.

No external encoder/ESC was selected, so no inferred module pinout/absolute ratings or guaranteed maximum RPM. Generic passive MPNs/DC bias and final connector ordering remain procurement review items. No manufacturer PDF, model library or tool executable is published.

## Task 5 local source verification — 2026-10-03

User-provided ST LSM6DSL datasheet, DocID028475 Rev7,114pages: rendered and visually inspected Figure1/page18 and Figure17/page110. This resolves the earlier graphical-source access blocker. Figure1 distinguishes top-view sensor axes from bottom-view pin numbering; Figure17 gives top pin1 indicator and3.00x2.50mm package orientation. File SHA256:`3449f752fff3bc69023ef9da18698e8e14379e3a920093d003c867bea195bcf2`. Vendor PDF and its rendered copies stay outside published source files.
