MiiGoto/reaction-wheel-pendulum/docs/images/task5-routed-top.png

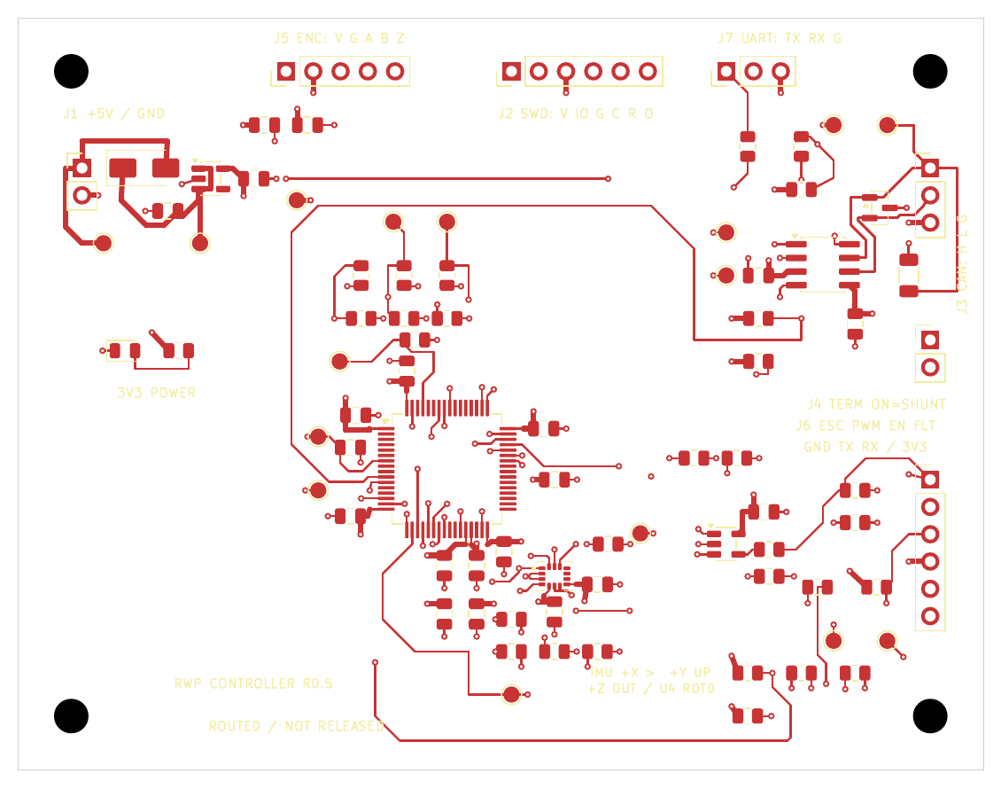
docs/images/task5-routed-top.png
