MiiGoto/reaction-wheel-pendulum/mechanical/cubli_revb/views/brake_state_0.png

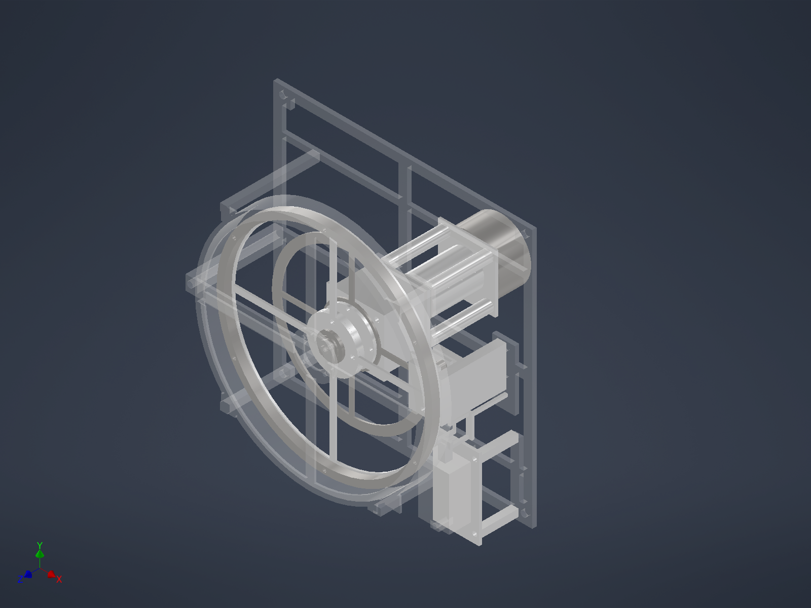
mechanical/cubli_revb/views/brake_state_0.png
