MiiGoto/reaction-wheel-pendulum/mechanical/cubli_revb/views/Cubli_ThreeAxis_Integration_Study.png

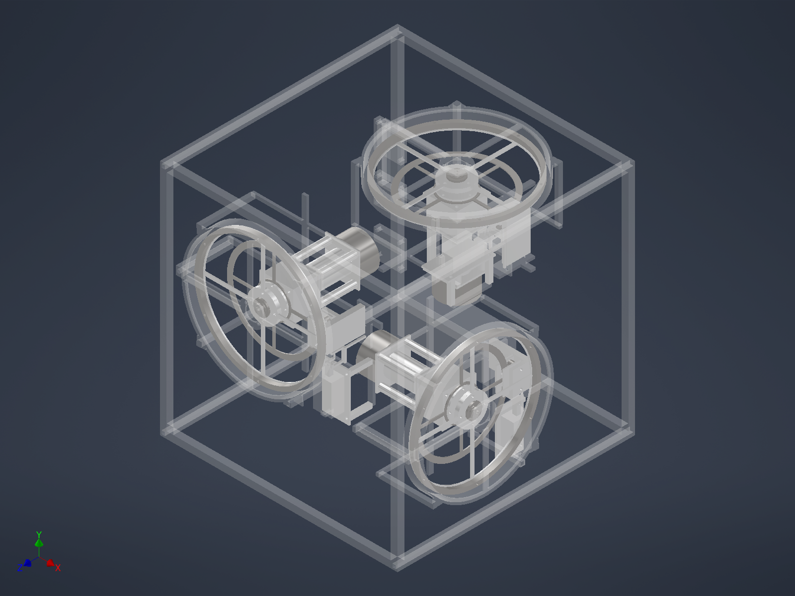
mechanical/cubli_revb/views/Cubli_ThreeAxis_Integration_Study.png
