MiiGoto/reaction-wheel-pendulum/mechanical/review/m2/M2_candidate_front.png

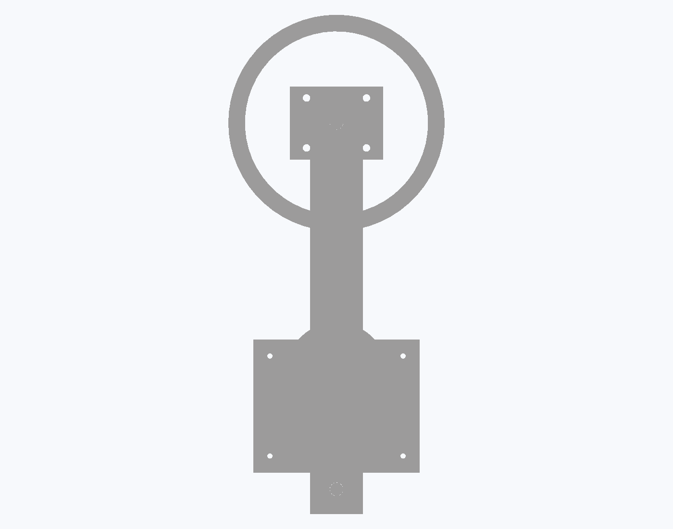
mechanical/review/m2/M2_candidate_front.png
