MiiGoto/reaction-wheel-pendulum/mechanical/cubli_concept/Cubli_clearance_concept.step

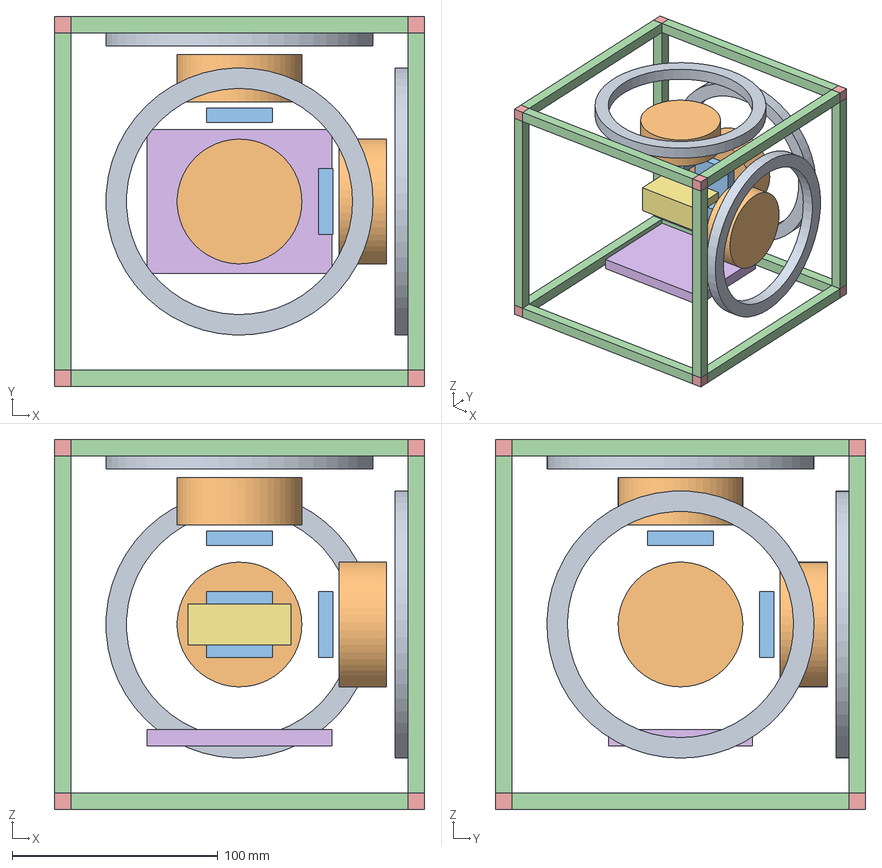
[picture p7: CAD file, 2026-10-08]
mechanical/cubli_concept/Cubli_clearance_concept.step
180.0 x 180.0 x 180.0 mm
wheel_0
GB54_envelope_0
Micro_envelope_0
wheel_1
GB54_envelope_1
Micro_envelope_1
wheel_2
GB54_envelope_2
Micro_envelope_2
frame_9
frame_10
frame_11
frame_12
frame_13
frame_14
frame_15
frame_16
frame_17
frame_18
frame_19
frame_20
corner_21
corner_22
corner_23
corner_24
corner_25
corner_26
corner_27
corner_28
controller_clearance
battery_clearance
