MiiGoto/reaction-wheel-pendulum/mechanical/cubli_revb/step/19_Encoder_PCB_Interface.step

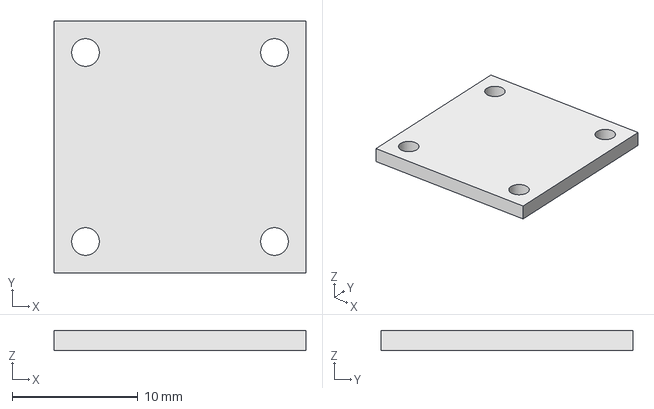
[picture p8: CAD file, 2026-10-08]
mechanical/cubli_revb/step/19_Encoder_PCB_Interface.step
20.0 x 20.0 x 1.60 mm
