MiiGoto/reaction-wheel-pendulum/mechanical/cubli_revb/step/26_Inner_Race_Spacer.step

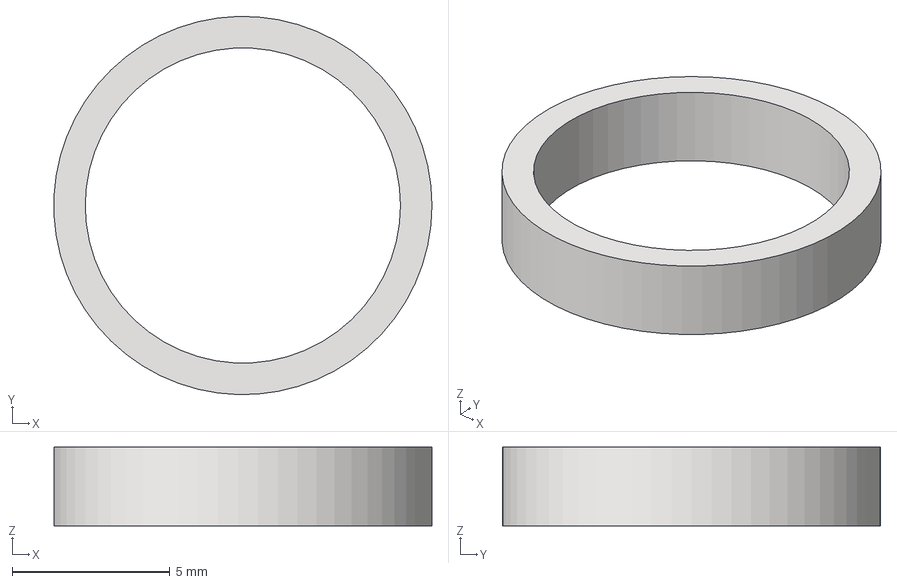
[picture p9: CAD file, 2026-10-08]
mechanical/cubli_revb/step/26_Inner_Race_Spacer.step
12.0 x 12.0 x 2.50 mm
