MiiGoto/reaction-wheel-pendulum/mechanical/cubli_revb/step/38_Return_Upper_-10.step

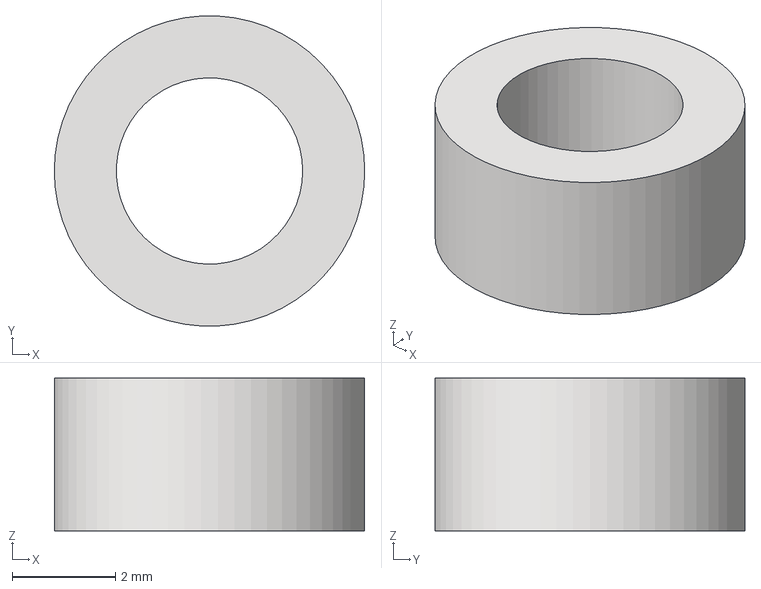
[picture p10: CAD file, 2026-10-08]
mechanical/cubli_revb/step/38_Return_Upper_-10.step
6.00 x 5.99 x 2.95 mm
