MiiGoto/reaction-wheel-pendulum/mechanical/cubli_revb/step/13B_Coupling_Sleeve_5_6.step

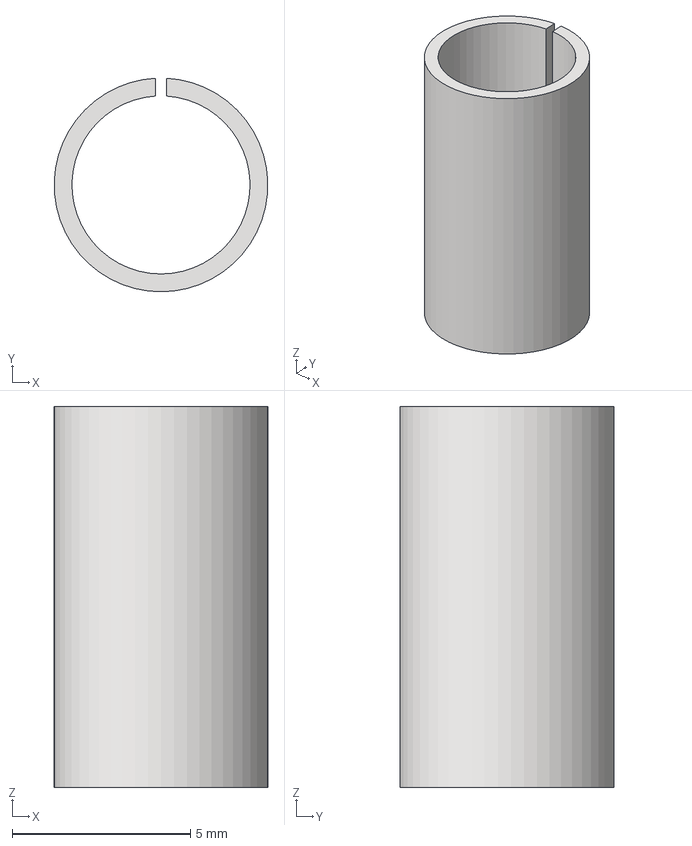
[picture p11: CAD file, 2026-10-08]
mechanical/cubli_revb/step/13B_Coupling_Sleeve_5_6.step
6.00 x 6.00 x 10.7 mm
