MiiGoto/reaction-wheel-pendulum/mechanical/cubli_revb/step/23_Brake_Guide_-10.step

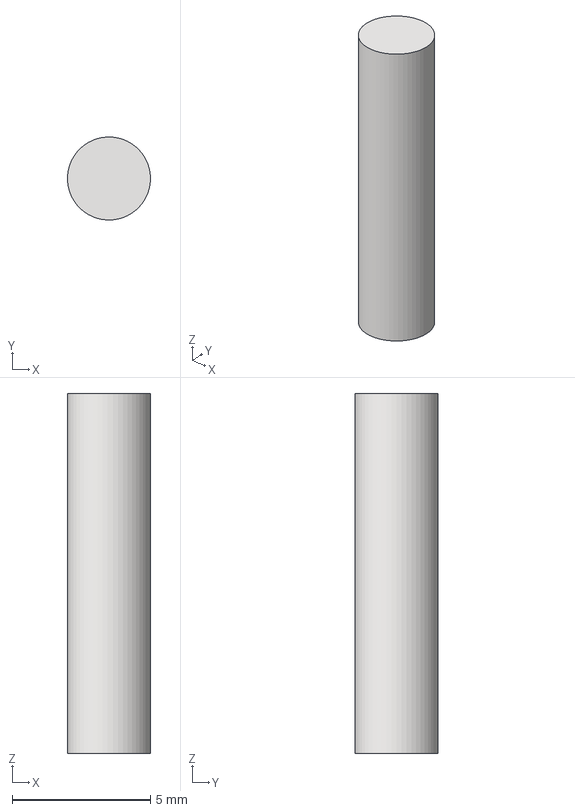
[picture p12: CAD file, 2026-10-08]
mechanical/cubli_revb/step/23_Brake_Guide_-10.step
3.00 x 3.00 x 13.0 mm
