MiiGoto/reaction-wheel-pendulum/mechanical/cubli_revb/step/27_Front_Hub_Shim.step

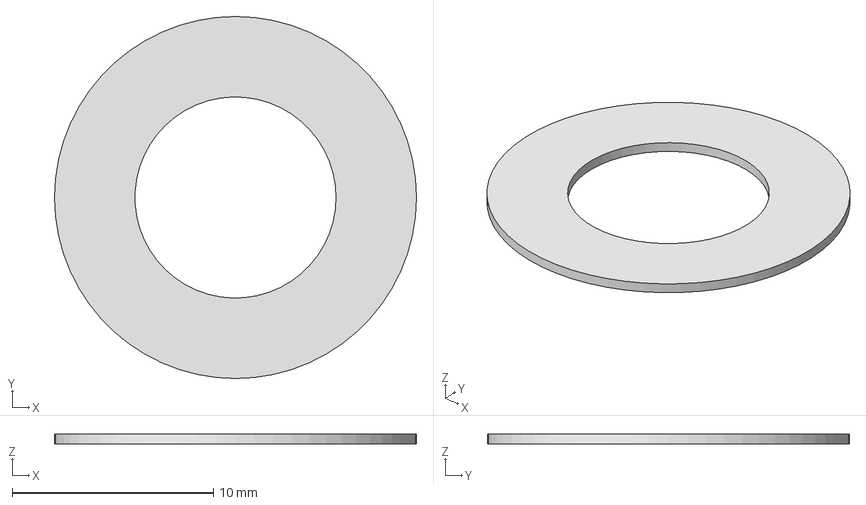
[picture p13: CAD file, 2026-10-08]
mechanical/cubli_revb/step/27_Front_Hub_Shim.step
18.0 x 18.0 x 0.5 mm
