MiiGoto/reaction-wheel-pendulum/mechanical/cubli_revb/step/08B_Brake_Pad.step

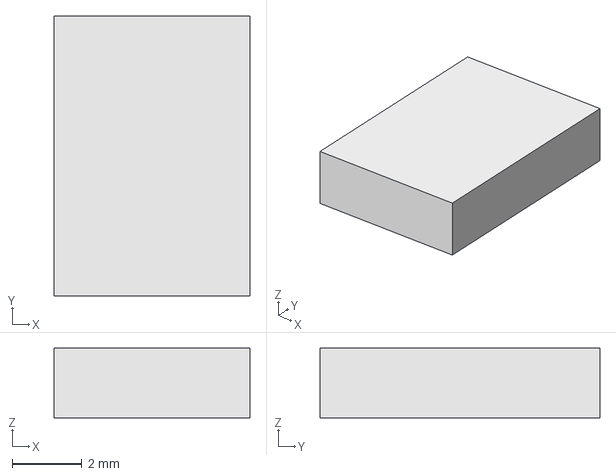
[picture p14: CAD file, 2026-10-08]
mechanical/cubli_revb/step/08B_Brake_Pad.step
5.60 x 8.00 x 2.00 mm
