MiiGoto/reaction-wheel-pendulum/mechanical/cubli_revb/step/Cubli_Shared_Module_RevB.step

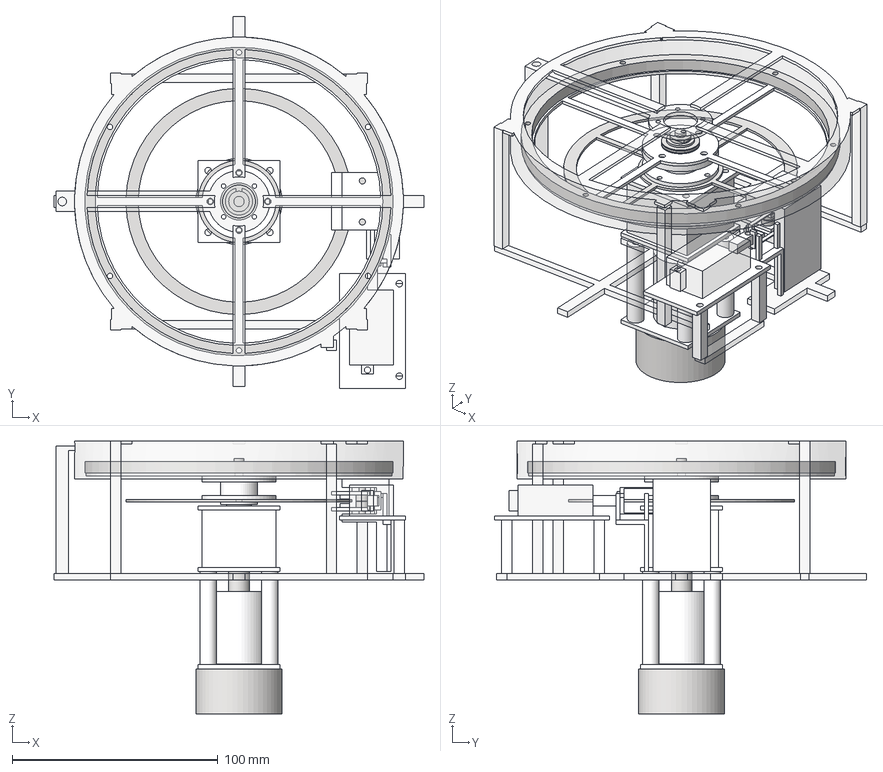
[picture p15: CAD file, 2026-10-08]
mechanical/cubli_revb/step/Cubli_Shared_Module_RevB.step
180.0 x 181.0 x 132.8 mm
01_Wheel_Rim
02_Wheel_Hub
03_Wheel_Spokes
04_Wheel_Shaft
05_Bearing_Housing
06_Motor_Mount
07_Brake_Drum
08_Brake_Mechanism
08B_Brake_Pad
09_Brake_Actuator_Bracket
10_Encoder_Mount
40_Shared_Module_Dock
12_Wheel_Guard
13_Torsional_Coupling
13B_Coupling_Sleeve_5_6
14_Bearing_6000_2Z
14B_Bearing_6000_2Z
15_Motor_4221G024BXTH
16_Motor_Rotor_Shaft
17_Bearing_Retainer_Rear
17B_Bearing_Retainer_Front
18_Encoder_Magnet
19_Encoder_PCB_Interface
20_Retaining_Washer
21_Retaining_Clip
22_Spacer_-15_-15
22_Spacer_-15_15
22_Spacer_15_-15
22_Spacer_15_15
23_Brake_Guide_-10
23_Brake_Guide_10
24_Lower_Pad_Carrier
24B_Upper_Pad_Carrier
25_Shaft_Key
26_Inner_Race_Spacer
27_Front_Hub_Shim
28_Clip_Stack_Shim
29_Frame_Shim_-15_-15
29_Frame_Shim_-15_15
29_Frame_Shim_15_-15
29_Frame_Shim_15_15
30_Dual_Wedge_Slider
31_Actuator_PQ12_Body_Envelope
32_Actuator_PQ12_Rod_Envelope
33_Actuator_Clevis
34_Actuator_Mount
35_Slider_Stops
36_Spring_Seat_-10
36_Spring_Seat_10
37_Return_Lower_-10
37_Return_Lower_10
38_Return_Upper_-10
38_Return_Upper_10
