MiiGoto/reaction-wheel-pendulum/mechanical/cubli_revb/step/15_Motor_4221G024BXTH.step

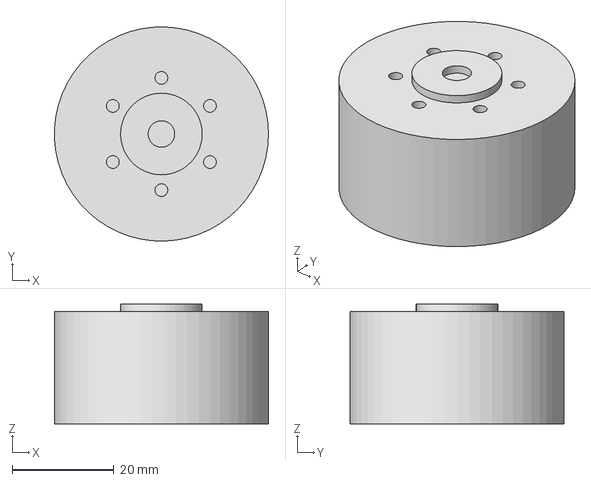
[picture p16: CAD file, 2026-10-08]
mechanical/cubli_revb/step/15_Motor_4221G024BXTH.step
42.0 x 42.0 x 23.5 mm
