MiiGoto/reaction-wheel-pendulum/mechanical/cubli_revb/step/46_Spider_D_Polymer.step

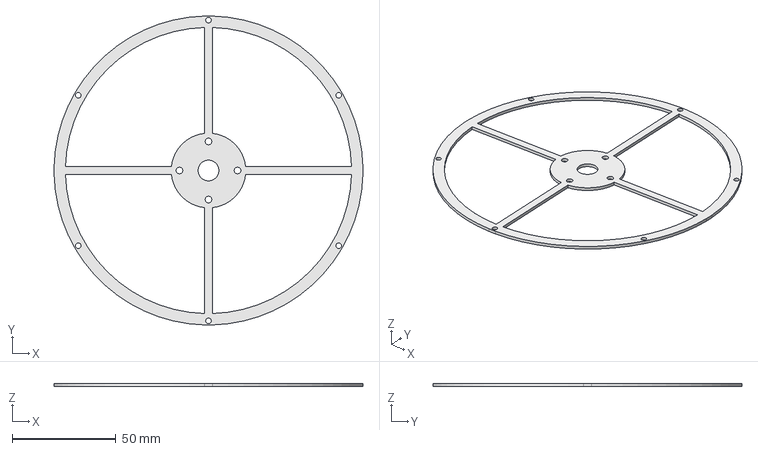
[picture p17: CAD file, 2026-10-08]
mechanical/cubli_revb/step/46_Spider_D_Polymer.step
149.0 x 149.0 x 1.50 mm
