MiiGoto/reaction-wheel-pendulum/mechanical/cubli_revb/step/05_Bearing_Housing.step

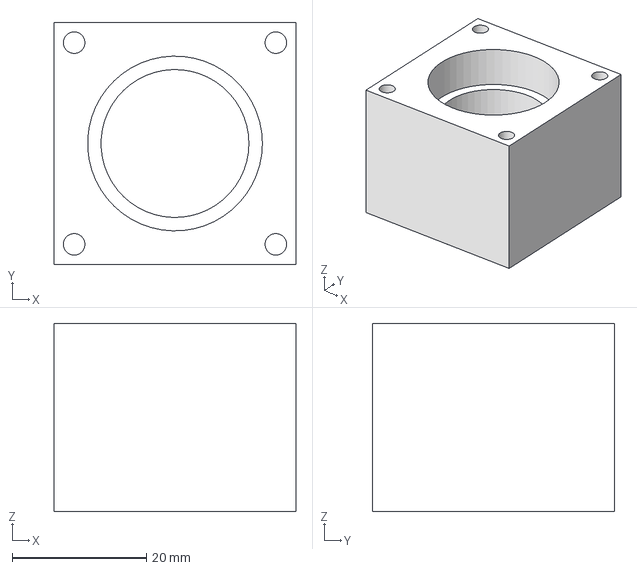
[picture p18: CAD file, 2026-10-08]
mechanical/cubli_revb/step/05_Bearing_Housing.step
36.0 x 36.0 x 28.0 mm
