MiiGoto/reaction-wheel-pendulum/mechanical/cubli_revb/step/06_Motor_Mount.step

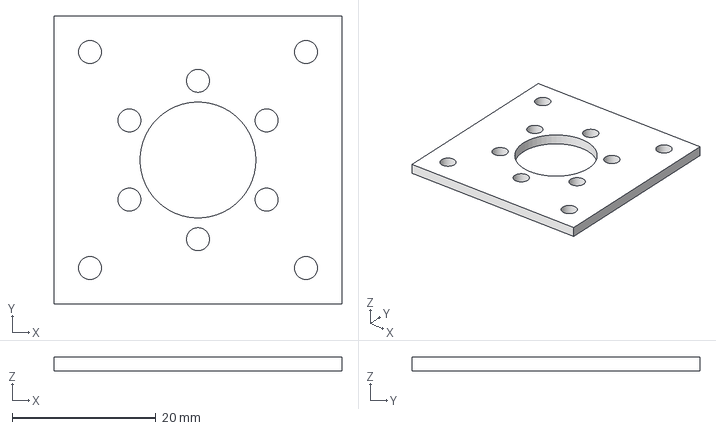
[picture p19: CAD file, 2026-10-08]
mechanical/cubli_revb/step/06_Motor_Mount.step
40.0 x 40.0 x 2.00 mm
