MiiGoto/reaction-wheel-pendulum/mechanical/cubli_revb/step/12_Wheel_Guard.step

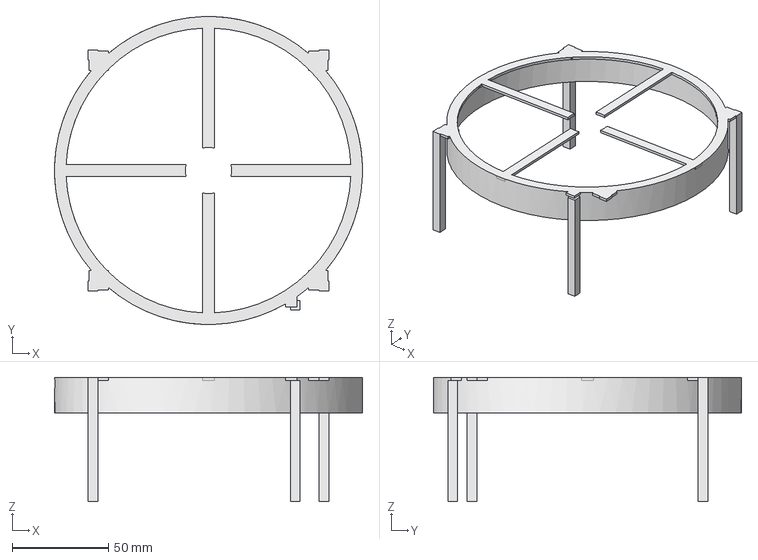
[picture p20: CAD file, 2026-10-08]
mechanical/cubli_revb/step/12_Wheel_Guard.step
160.0 x 160.0 x 64.5 mm
