MiiGoto/reaction-wheel-pendulum/mechanical/cubli_revb/step/31_Actuator_PQ12_Body_Envelope.step

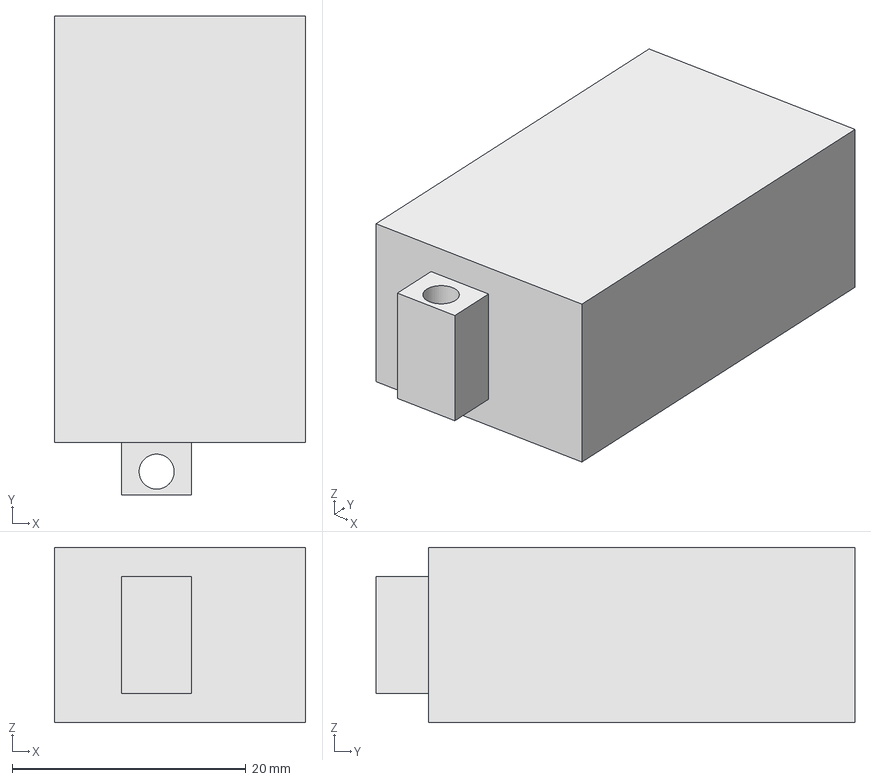
[picture p21: CAD file, 2026-10-08]
mechanical/cubli_revb/step/31_Actuator_PQ12_Body_Envelope.step
21.5 x 41.0 x 15.0 mm
