MiiGoto/reaction-wheel-pendulum/mechanical/cubli_revb/step/34_Actuator_Mount.step

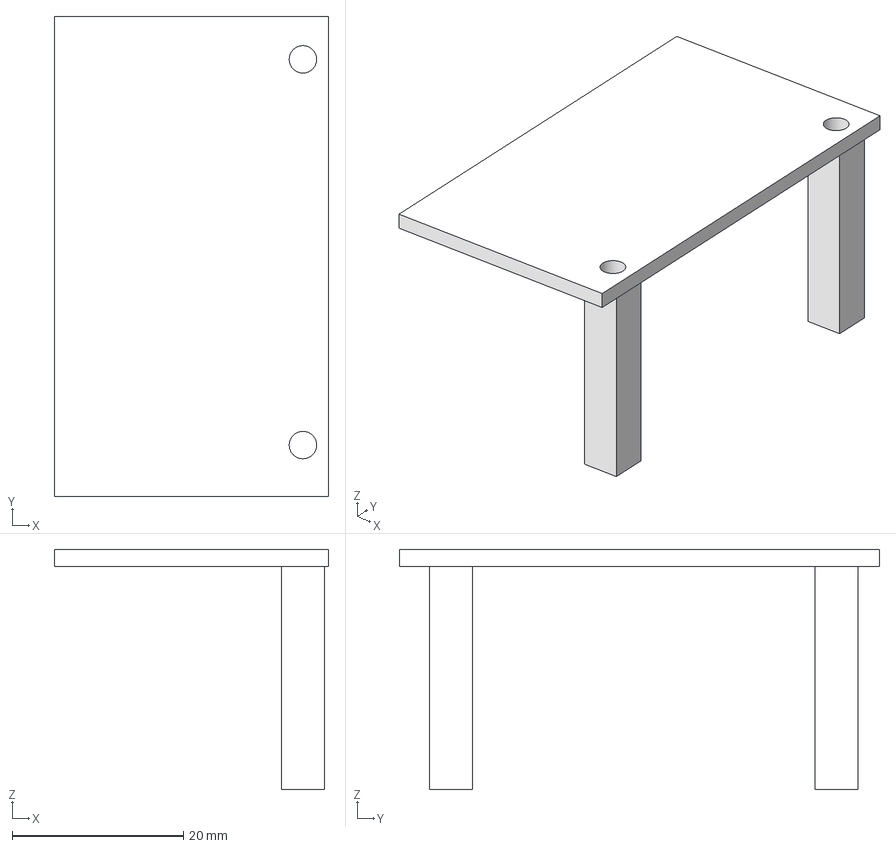
[picture p22: CAD file, 2026-10-08]
mechanical/cubli_revb/step/34_Actuator_Mount.step
32.0 x 56.0 x 28.0 mm
