MiiGoto/reaction-wheel-pendulum/mechanical/cubli_revb/step/45_Rim_B_Aluminium.step

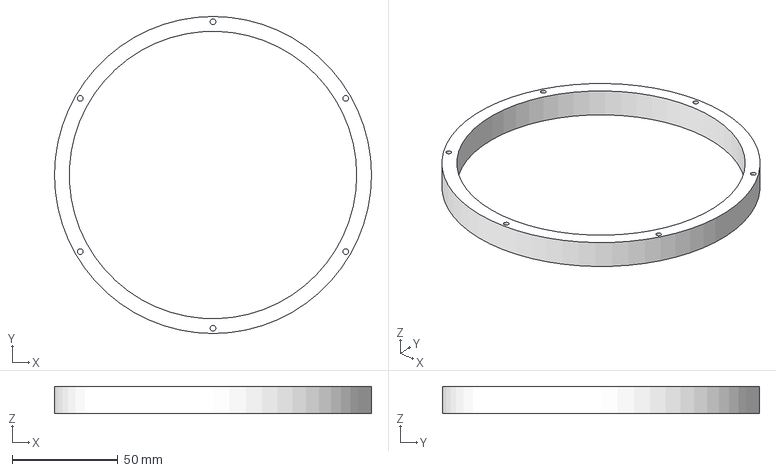
[picture p23: CAD file, 2026-10-08]
mechanical/cubli_revb/step/45_Rim_B_Aluminium.step
150.0 x 150.0 x 13.0 mm
