MiiGoto/reaction-wheel-pendulum/mechanical/cubli_revb/step/41_Common_Cube_Frame.step

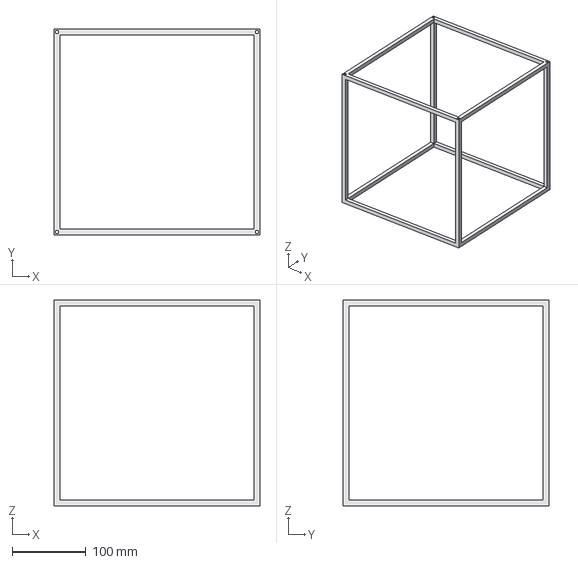
[picture p24: CAD file, 2026-10-08]
mechanical/cubli_revb/step/41_Common_Cube_Frame.step
280.0 x 280.0 x 280.0 mm
