MiiGoto/reaction-wheel-pendulum/mechanical/cubli_revb/step/04_Wheel_Shaft.step

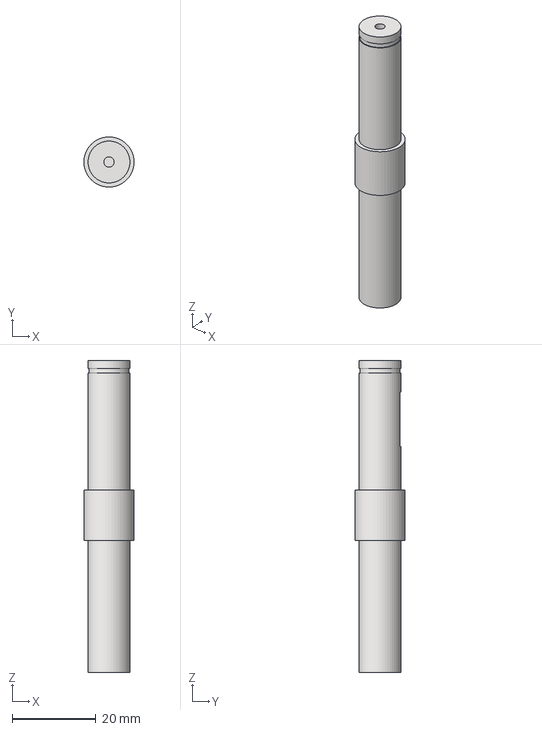
[picture p25: CAD file, 2026-10-08]
mechanical/cubli_revb/step/04_Wheel_Shaft.step
12.0 x 12.0 x 74.5 mm
