MiiGoto/reaction-wheel-pendulum/mechanical/cubli_revb/step/37_Return_Lower_-10.step

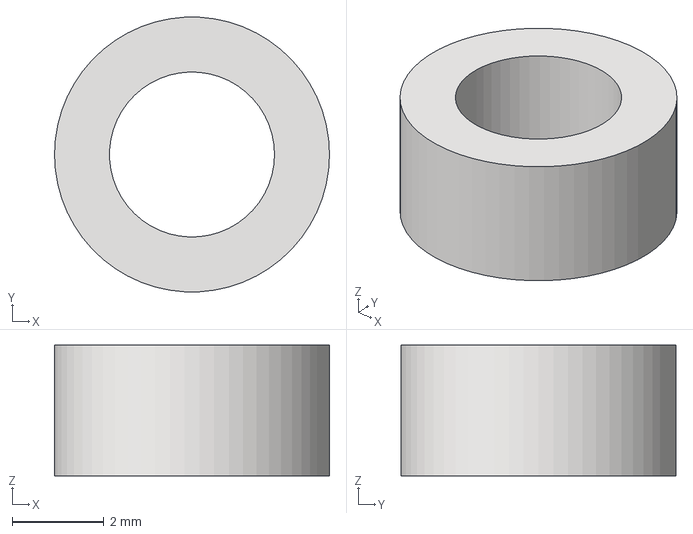
[picture p26: CAD file, 2026-10-08]
mechanical/cubli_revb/step/37_Return_Lower_-10.step
6.00 x 5.99 x 2.85 mm
