MiiGoto/reaction-wheel-pendulum/mechanical/cubli_revb/step/14B_Bearing_6000_2Z.step

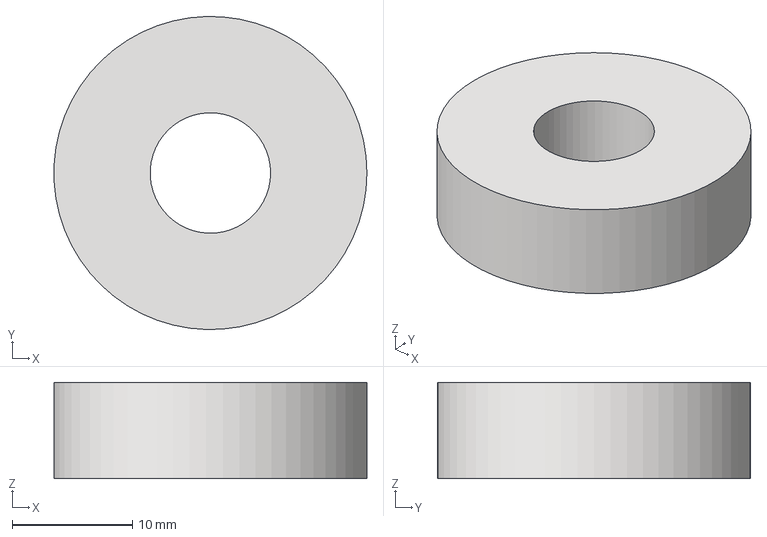
[picture p27: CAD file, 2026-10-08]
mechanical/cubli_revb/step/14B_Bearing_6000_2Z.step
26.0 x 26.0 x 8.00 mm
