MiiGoto/reaction-wheel-pendulum/mechanical/cubli_revb/step/40_Shared_Module_Dock.step

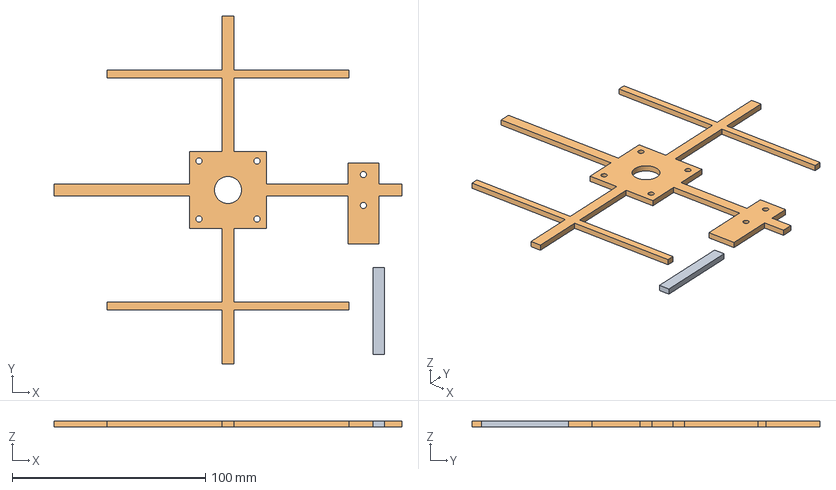
[picture p28: CAD file, 2026-10-08]
mechanical/cubli_revb/step/40_Shared_Module_Dock.step
180.0 x 180.0 x 3.00 mm
