MiiGoto/reaction-wheel-pendulum/mechanical/cubli_revb/step/11_Module_Frame.step

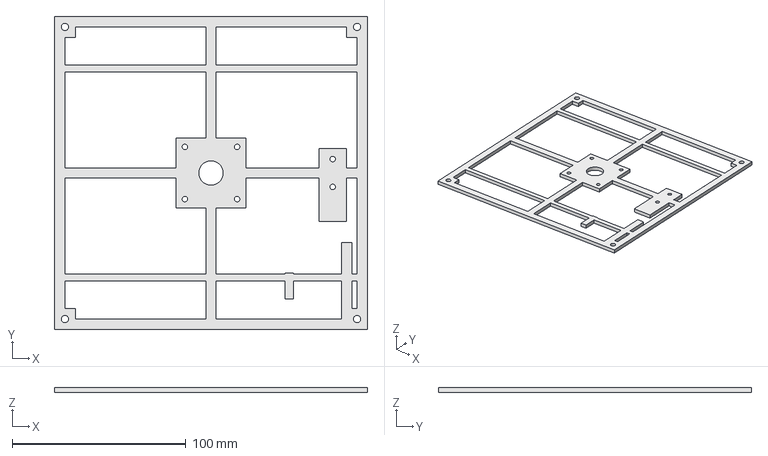
[picture p29: CAD file, 2026-10-08]
mechanical/cubli_revb/step/11_Module_Frame.step
180.0 x 180.0 x 3.00 mm
