MiiGoto/reaction-wheel-pendulum/mechanical/cubli_revb/step/21_Retaining_Clip.step

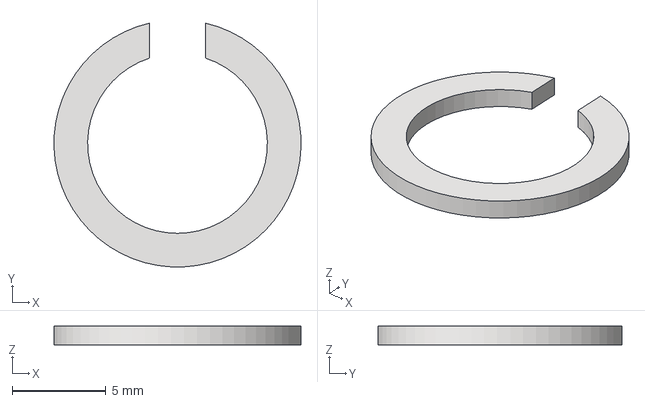
[picture p30: CAD file, 2026-10-08]
mechanical/cubli_revb/step/21_Retaining_Clip.step
13.2 x 13.0 x 1.00 mm
