MiiGoto/reaction-wheel-pendulum/mechanical/cubli_revb/step/09_Brake_Actuator_Bracket.step

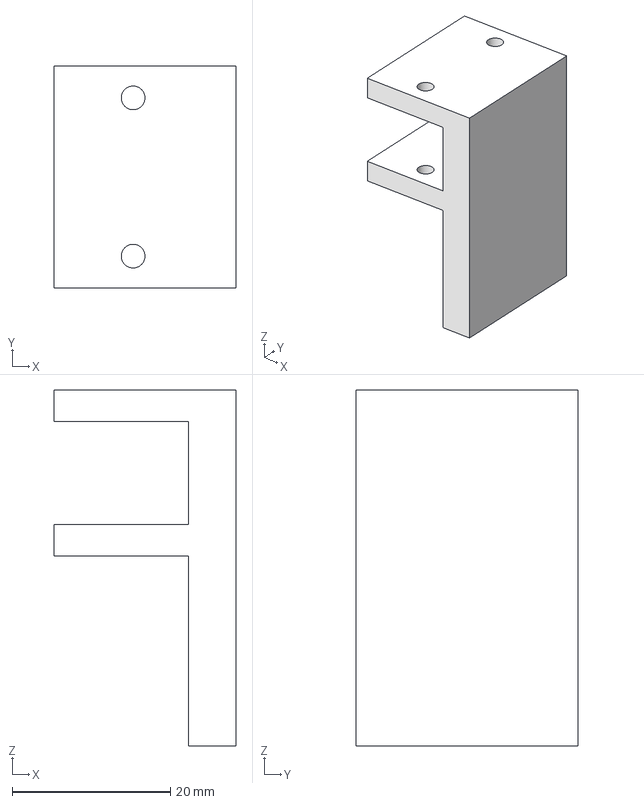
[picture p31: CAD file, 2026-10-08]
mechanical/cubli_revb/step/09_Brake_Actuator_Bracket.step
23.0 x 28.0 x 45.0 mm
