MiiGoto/reaction-wheel-pendulum/mechanical/cubli_revb/step/02_Wheel_Hub.step

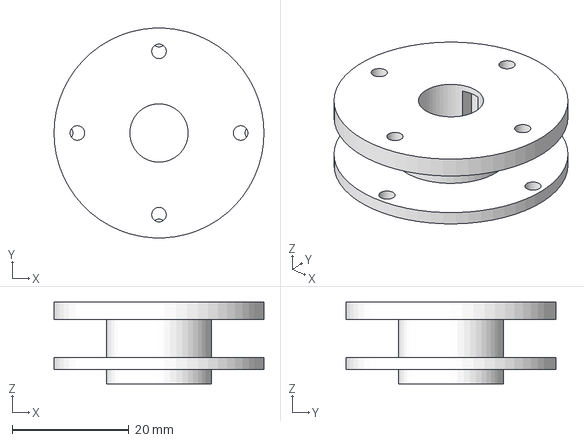
[picture p32: CAD file, 2026-10-08]
mechanical/cubli_revb/step/02_Wheel_Hub.step
36.0 x 35.9 x 14.0 mm
