MiiGoto/reaction-wheel-pendulum/mechanical/cubli_revb/step/44_Controller_PCB_Envelope.step

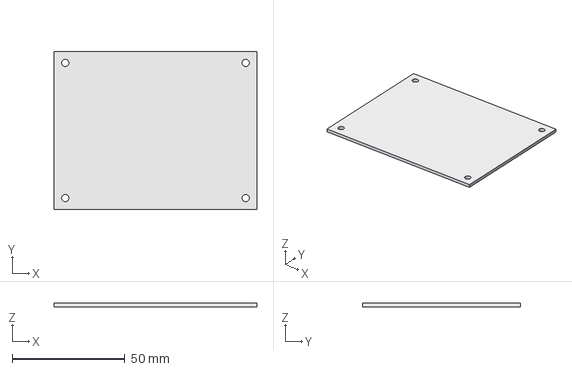
[picture p33: CAD file, 2026-10-08]
mechanical/cubli_revb/step/44_Controller_PCB_Envelope.step
90.0 x 70.0 x 1.60 mm
