MiiGoto/reaction-wheel-pendulum/mechanical/cubli_revb/step/16_Motor_Rotor_Shaft.step

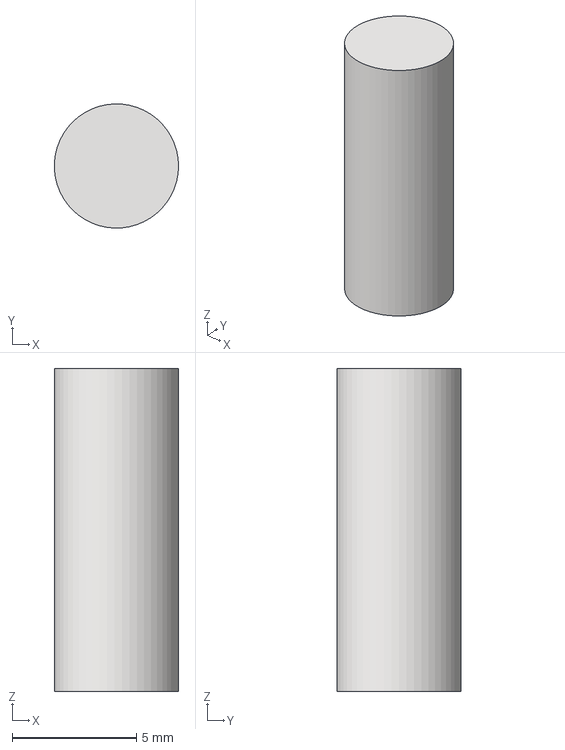
[picture p34: CAD file, 2026-10-08]
mechanical/cubli_revb/step/16_Motor_Rotor_Shaft.step
5.00 x 5.00 x 13.0 mm
