MiiGoto/reaction-wheel-pendulum/mechanical/cubli_revb/step/17_Bearing_Retainer_Rear.step

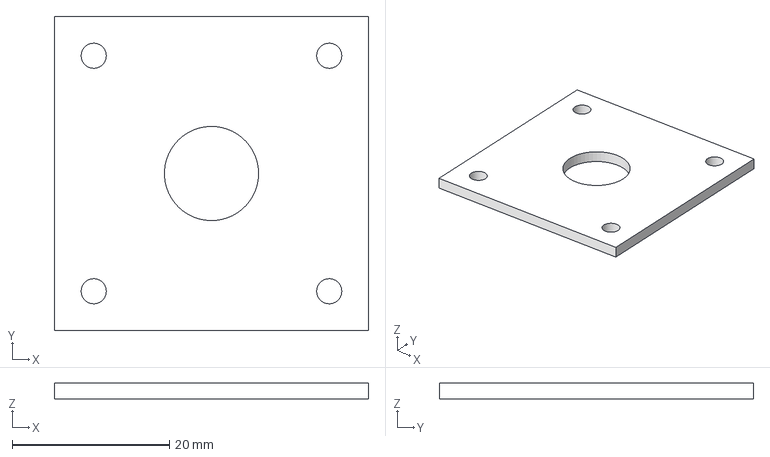
[picture p35: CAD file, 2026-10-08]
mechanical/cubli_revb/step/17_Bearing_Retainer_Rear.step
40.0 x 40.0 x 2.00 mm
