MiiGoto/reaction-wheel-pendulum/mechanical/cubli_revb/step/10_Encoder_Mount.step

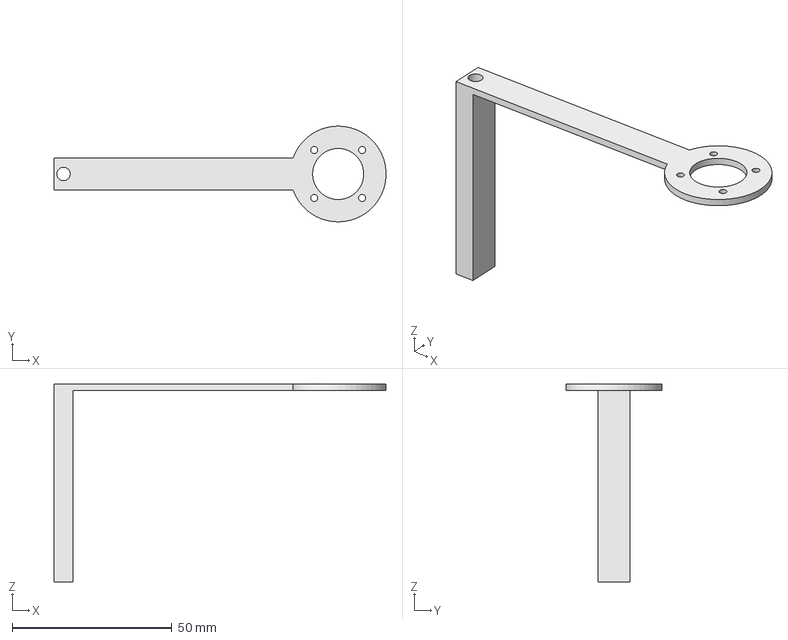
[picture p36: CAD file, 2026-10-08]
mechanical/cubli_revb/step/10_Encoder_Mount.step
104.0 x 30.0 x 62.0 mm
