MiiGoto/reaction-wheel-pendulum/mechanical/cubli_revb/step/Wheel_Comparison_A.step

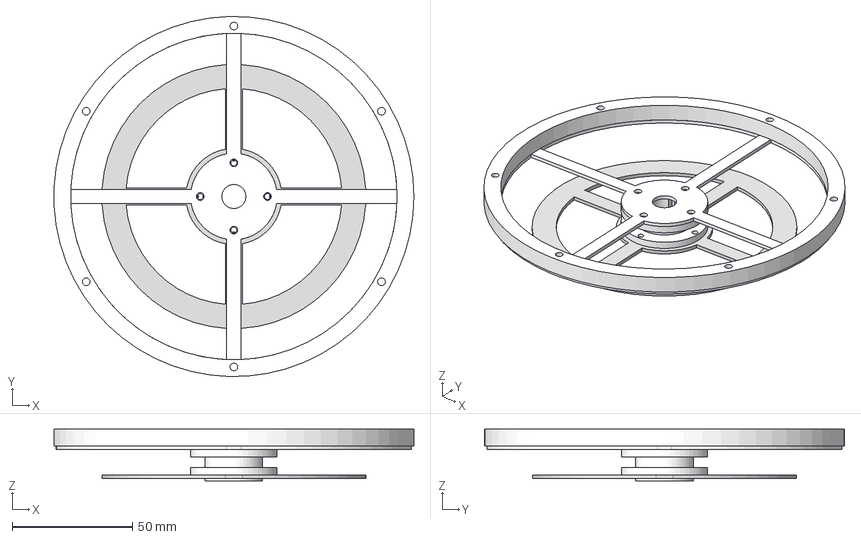
[picture p37: CAD file, 2026-10-08]
mechanical/cubli_revb/step/Wheel_Comparison_A.step
149.9 x 149.9 x 21.5 mm
01_Wheel_Rim
02_Wheel_Hub
03_Wheel_Spokes
07_Brake_Drum
