MiiGoto/reaction-wheel-pendulum/mechanical/cubli_revb/step/Wheel_Comparison_B.step

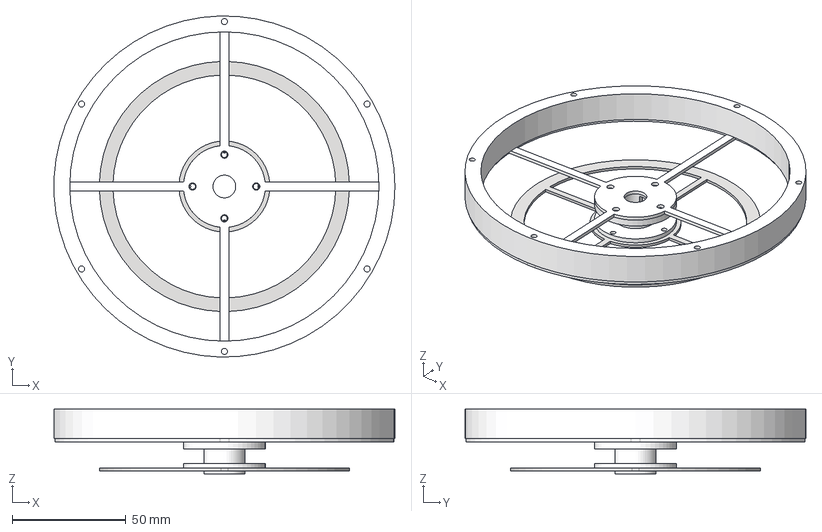
[picture p39: CAD file, 2026-10-08]
mechanical/cubli_revb/step/Wheel_Comparison_B.step
149.9 x 149.9 x 28.5 mm
45_Rim_B_Aluminium
02_Wheel_Hub
03_Wheel_Spokes
07_Brake_Drum
