MiiGoto/reaction-wheel-pendulum/mechanical/cubli_revb/step/42_ODrive_Micro_Envelope.step

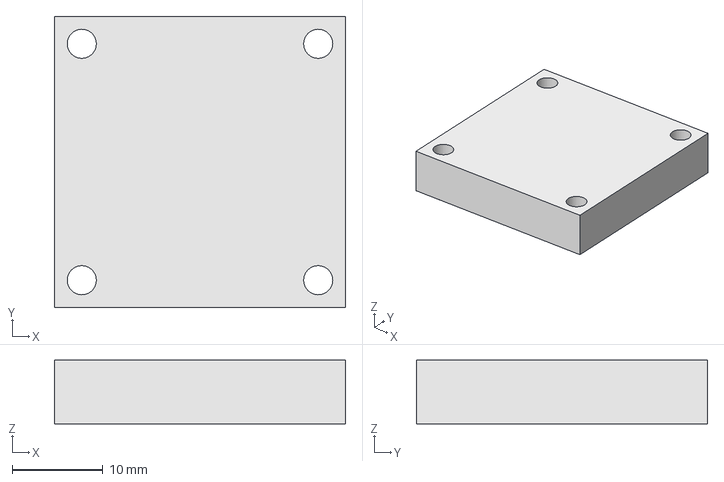
[picture p40: CAD file, 2026-10-08]
mechanical/cubli_revb/step/42_ODrive_Micro_Envelope.step
32.0 x 32.0 x 7.00 mm
