MiiGoto/reaction-wheel-pendulum/mechanical/cubli_revb/step/25_Shaft_Key.step

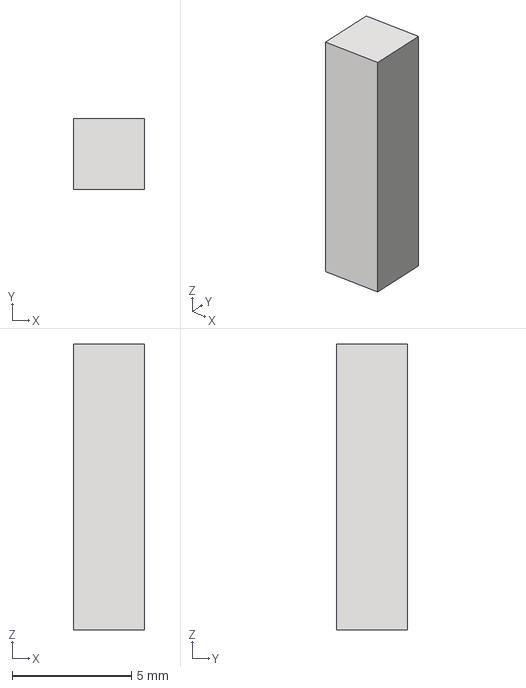
[picture p41: CAD file, 2026-10-08]
mechanical/cubli_revb/step/25_Shaft_Key.step
3.00 x 3.00 x 12.0 mm
