MiiGoto/reaction-wheel-pendulum/mechanical/cubli_revb/step/30_Dual_Wedge_Slider.step

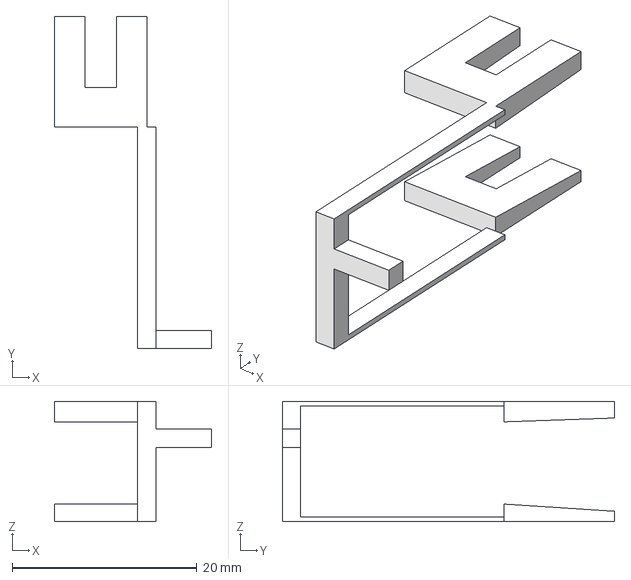
[picture p42: CAD file, 2026-10-08]
mechanical/cubli_revb/step/30_Dual_Wedge_Slider.step
17.0 x 36.0 x 13.0 mm
