MiiGoto/reaction-wheel-pendulum/mechanical/cubli_revb/step/24B_Upper_Pad_Carrier.step

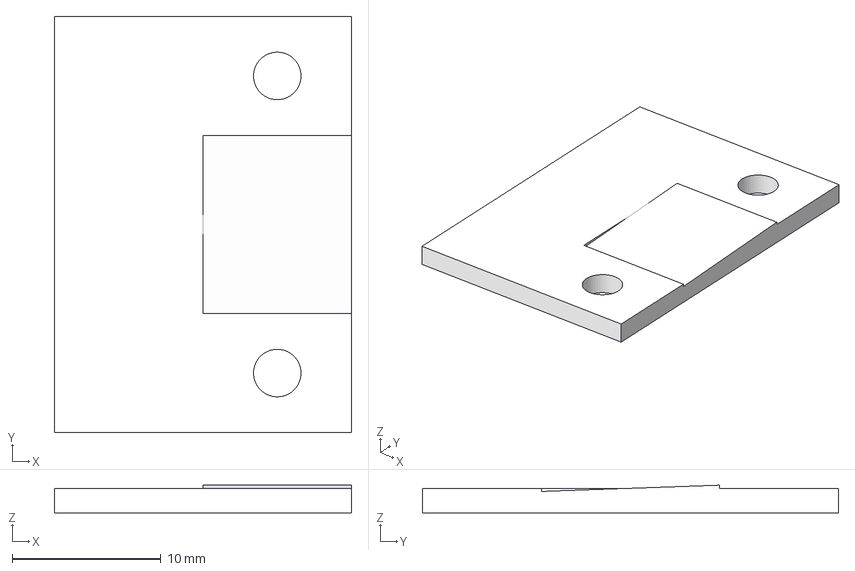
[picture p43: CAD file, 2026-10-08]
mechanical/cubli_revb/step/24B_Upper_Pad_Carrier.step
20.0 x 28.0 x 1.86 mm
