MiiGoto/reaction-wheel-pendulum/mechanical/cubli_revb/step/13_Torsional_Coupling.step

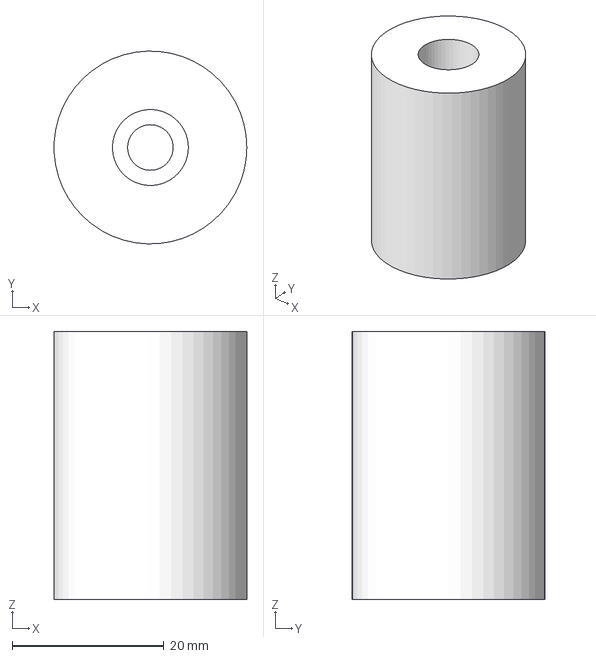
[picture p44: CAD file, 2026-10-08]
mechanical/cubli_revb/step/13_Torsional_Coupling.step
25.4 x 25.4 x 35.3 mm
