MiiGoto/reaction-wheel-pendulum/mechanical/cubli_revb/step/36_Spring_Seat_-10.step

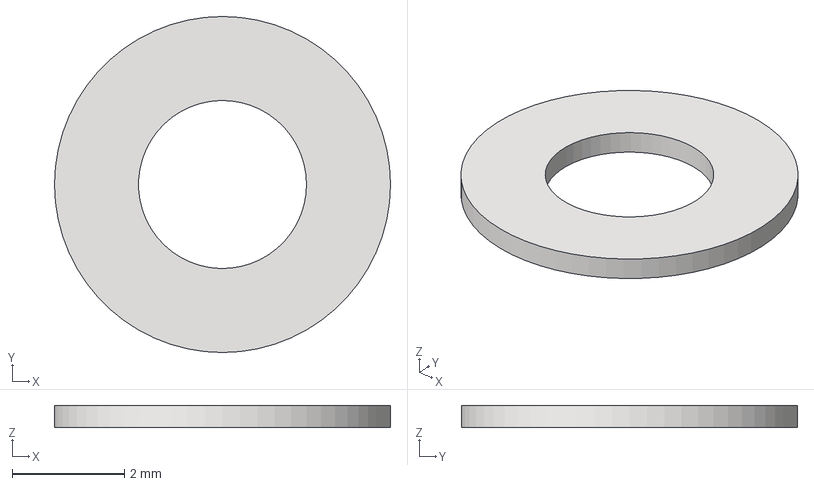
[picture p45: CAD file, 2026-10-08]
mechanical/cubli_revb/step/36_Spring_Seat_-10.step
6.00 x 6.00 x 0.4 mm
