MiiGoto/reaction-wheel-pendulum/mechanical/cubli_revb/step/01_Wheel_Rim.step

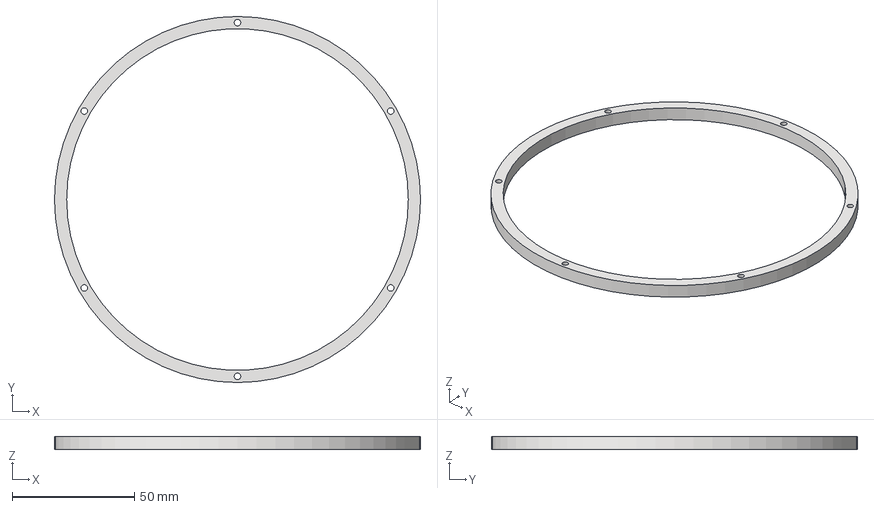
[picture p46: CAD file, 2026-10-08]
mechanical/cubli_revb/step/01_Wheel_Rim.step
150.0 x 150.0 x 5.50 mm
