MiiGoto/reaction-wheel-pendulum/mechanical/cubli_revb/step/Wheel_Comparison_D.step

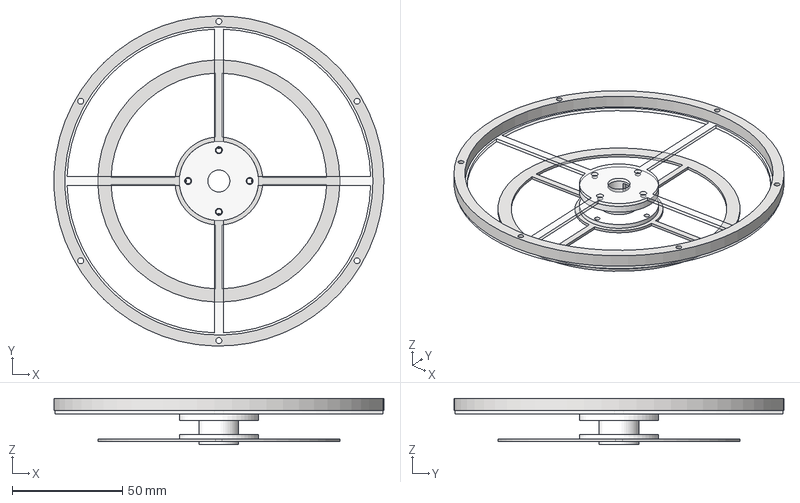
[picture p47: CAD file, 2026-10-08]
mechanical/cubli_revb/step/Wheel_Comparison_D.step
149.9 x 149.9 x 21.0 mm
01_Wheel_Rim
02_Wheel_Hub
46_Spider_D_Polymer
07_Brake_Drum
