MiiGoto/reaction-wheel-pendulum/mechanical/cubli_revb/step/33_Actuator_Clevis.step

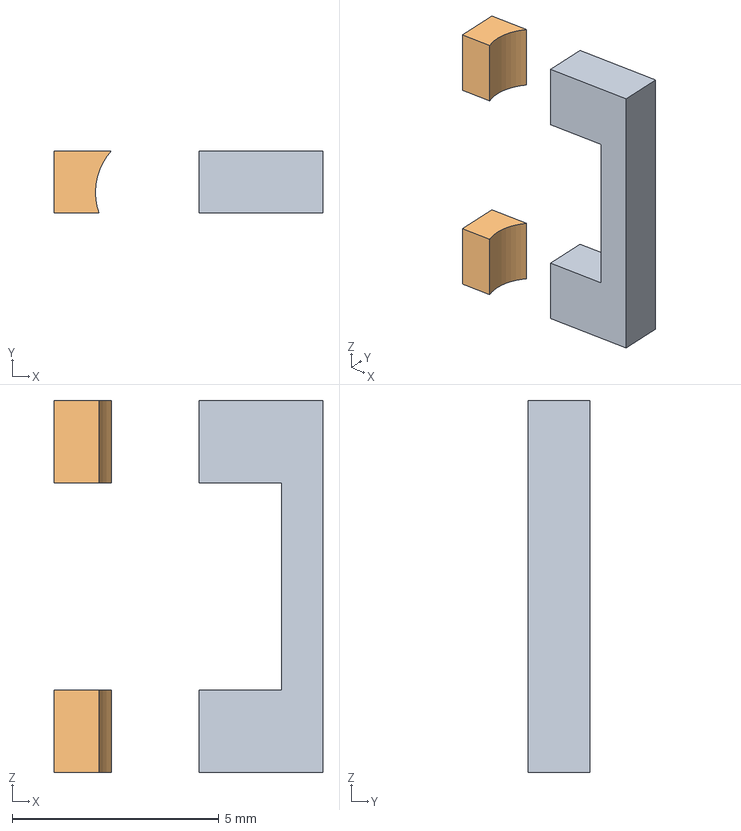
[picture p48: CAD file, 2026-10-08]
mechanical/cubli_revb/step/33_Actuator_Clevis.step
6.50 x 1.50 x 9.00 mm
