MiiGoto/reaction-wheel-pendulum/mechanical/cubli_revb/step/29_Frame_Shim_-15_-15.step

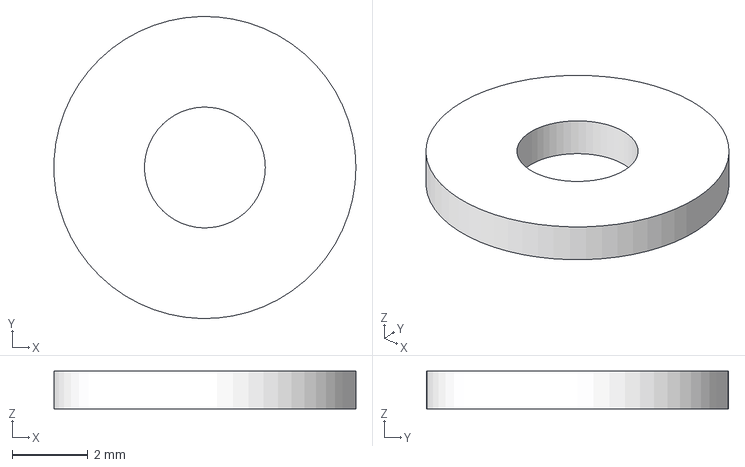
[picture p49: CAD file, 2026-10-08]
mechanical/cubli_revb/step/29_Frame_Shim_-15_-15.step
7.99 x 8.00 x 1.00 mm
