MiiGoto/reaction-wheel-pendulum/mechanical/cubli_revb/step/Cubli_ThreeAxis_Standalone.step

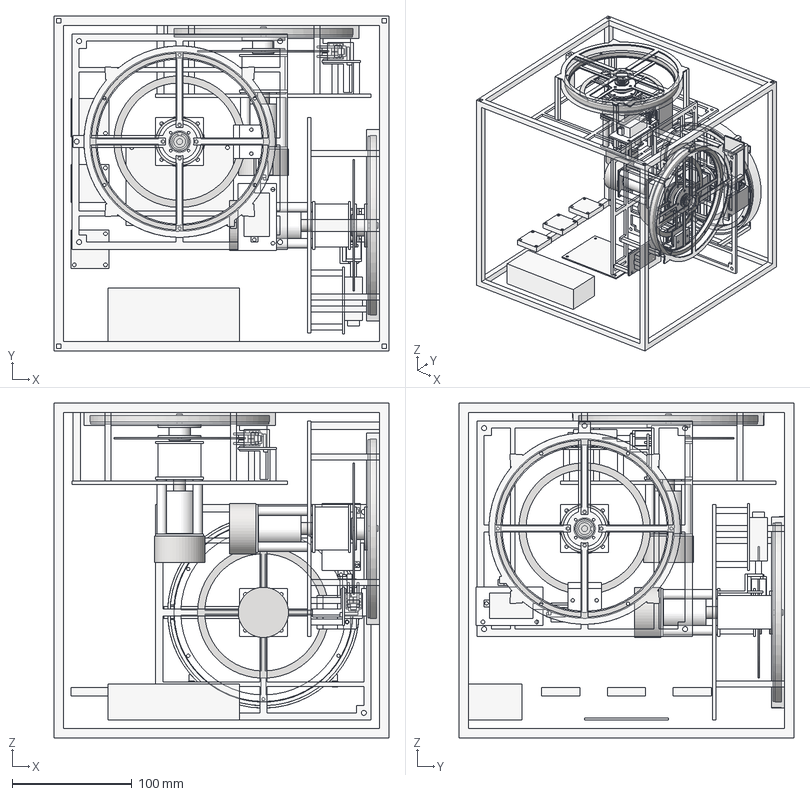
[picture p50: CAD file, 2026-10-08]
mechanical/cubli_revb/step/Cubli_ThreeAxis_Standalone.step
280.0 x 280.0 x 280.0 mm
01_Wheel_Rim x 3
02_Wheel_Hub x 3
03_Wheel_Spokes x 3
04_Wheel_Shaft x 3
05_Bearing_Housing x 3
06_Motor_Mount x 3
07_Brake_Drum x 3
08_Brake_Mechanism x 3
08B_Brake_Pad x 3
09_Brake_Actuator_Bracket x 3
10_Encoder_Mount x 3
11_Module_Frame x 3
12_Wheel_Guard x 3
13_Torsional_Coupling x 3
13B_Coupling_Sleeve_5_6 x 3
14_Bearing_6000_2Z x 3
14B_Bearing_6000_2Z x 3
15_Motor_4221G024BXTH x 3
16_Motor_Rotor_Shaft x 3
17_Bearing_Retainer_Rear x 3
17B_Bearing_Retainer_Front x 3
18_Encoder_Magnet x 3
19_Encoder_PCB_Interface x 3
20_Retaining_Washer x 3
21_Retaining_Clip x 3
22_Spacer_-15_-15 x 3
22_Spacer_-15_15 x 3
22_Spacer_15_-15 x 3
22_Spacer_15_15 x 3
23_Brake_Guide_-10 x 3
23_Brake_Guide_10 x 3
24_Lower_Pad_Carrier x 3
24B_Upper_Pad_Carrier x 3
25_Shaft_Key x 3
26_Inner_Race_Spacer x 3
27_Front_Hub_Shim x 3
28_Clip_Stack_Shim x 3
29_Frame_Shim_-15_-15 x 3
29_Frame_Shim_-15_15 x 3
29_Frame_Shim_15_-15 x 3
29_Frame_Shim_15_15 x 3
30_Dual_Wedge_Slider x 3
31_Actuator_PQ12_Body_Envelope x 3
32_Actuator_PQ12_Rod_Envelope x 3
33_Actuator_Clevis x 3
34_Actuator_Mount x 3
35_Slider_Stops x 3
36_Spring_Seat_-10 x 3
36_Spring_Seat_10 x 3
37_Return_Lower_-10 x 3
37_Return_Lower_10 x 3
38_Return_Upper_-10 x 3
38_Return_Upper_10 x 3
41_Common_Cube_Frame
42_ODrive_Micro_Envelope x 3
43_Battery_Envelope_ASSUMPTION
44_Controller_PCB_Envelope
