MiiGoto/reaction-wheel-pendulum/mechanical/cubli_revb/step/24_Lower_Pad_Carrier.step

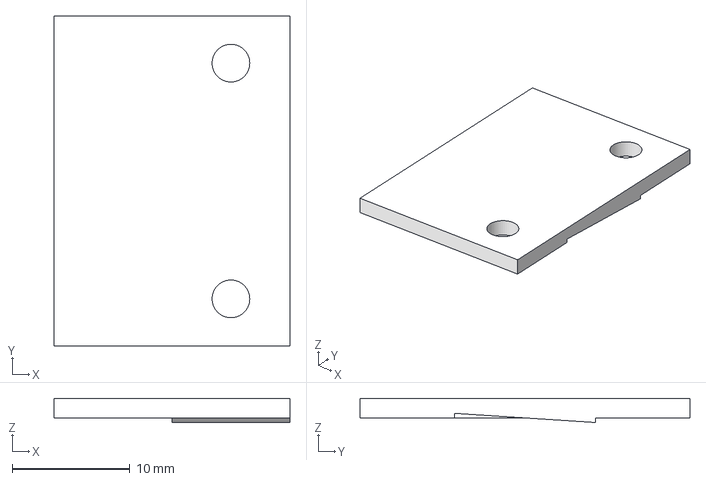
[picture p51: CAD file, 2026-10-08]
mechanical/cubli_revb/step/24_Lower_Pad_Carrier.step
20.0 x 28.0 x 2.04 mm
