MiiGoto/reaction-wheel-pendulum/mechanical/cubli_revb/step/32_Actuator_PQ12_Rod_Envelope.step

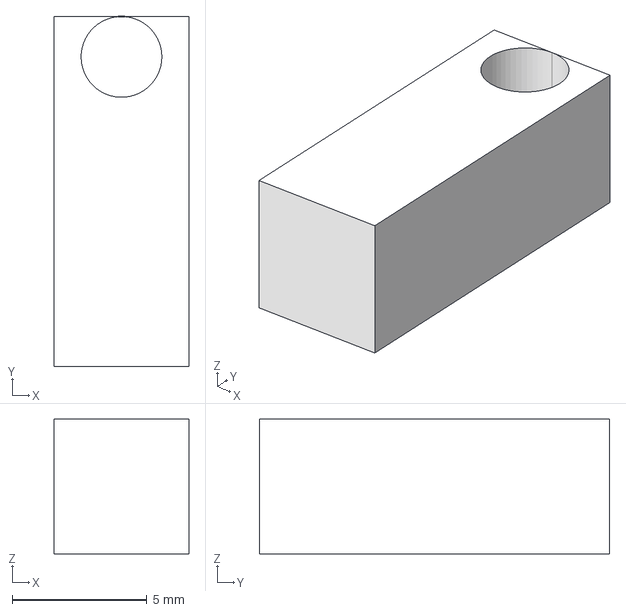
[picture p52: CAD file, 2026-10-08]
mechanical/cubli_revb/step/32_Actuator_PQ12_Rod_Envelope.step
5.00 x 13.0 x 5.00 mm
