MiiGoto/reaction-wheel-pendulum/mechanical/cubli_revb/step/18_Encoder_Magnet.step

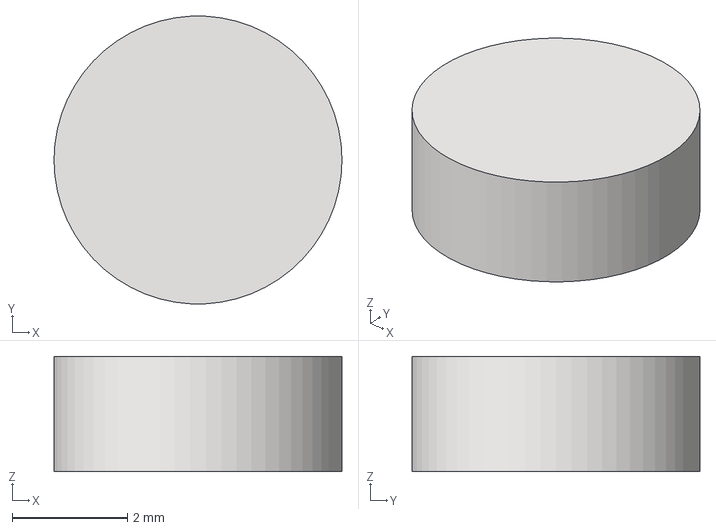
[picture p53: CAD file, 2026-10-08]
mechanical/cubli_revb/step/18_Encoder_Magnet.step
5.00 x 4.99 x 2.00 mm
