MiiGoto/reaction-wheel-pendulum/mechanical/cubli_revb/step/43_Battery_Envelope_ASSUMPTION.step

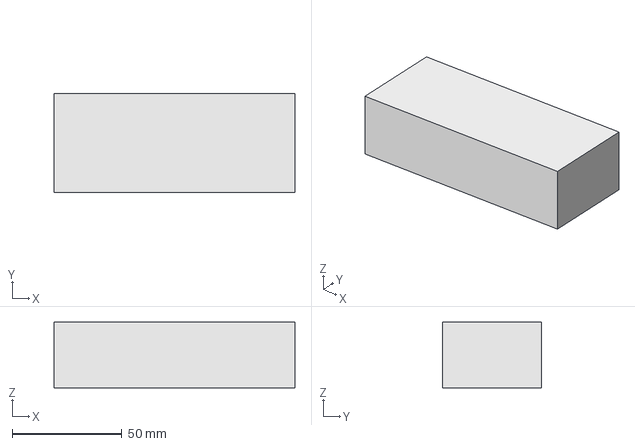
[picture p54: CAD file, 2026-10-08]
mechanical/cubli_revb/step/43_Battery_Envelope_ASSUMPTION.step
110.0 x 45.0 x 30.0 mm
