MiiGoto/reaction-wheel-pendulum/mechanical/cubli_revb/step/35_Slider_Stops.step

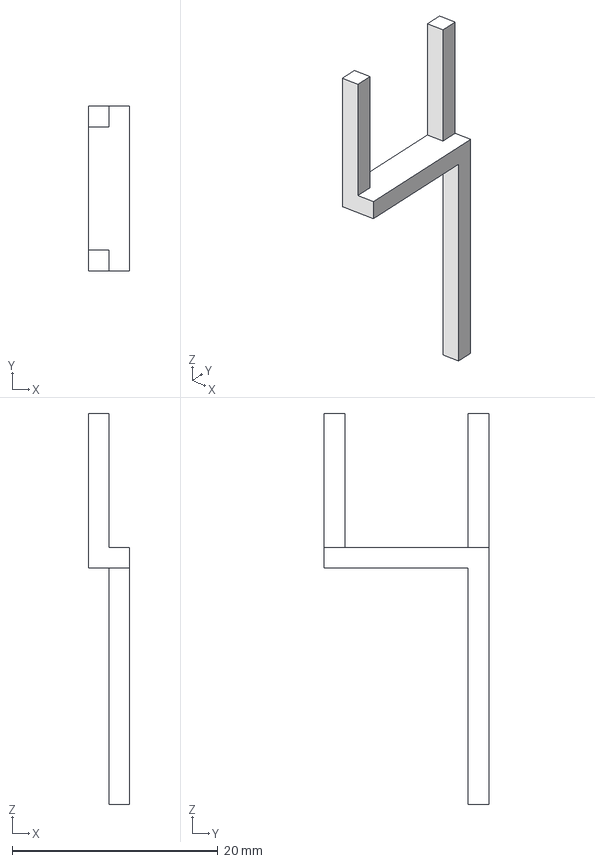
[picture p56: CAD file, 2026-10-08]
mechanical/cubli_revb/step/35_Slider_Stops.step
4.00 x 16.0 x 38.0 mm
