MiiGoto/reaction-wheel-pendulum/mechanical/cubli_revb/step/22_Spacer_-15_-15.step

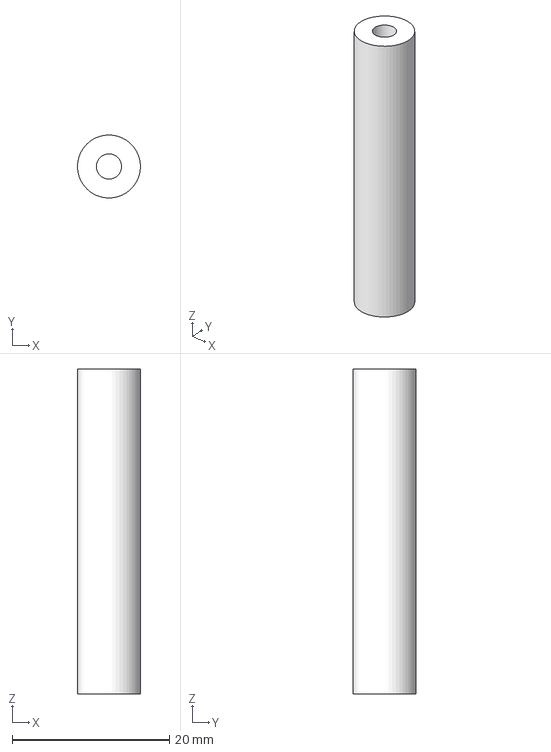
[picture p57: CAD file, 2026-10-08]
mechanical/cubli_revb/step/22_Spacer_-15_-15.step
7.99 x 8.00 x 41.3 mm
