MiiGoto/reaction-wheel-pendulum/mechanical/cubli_revb/step/07_Brake_Drum.step

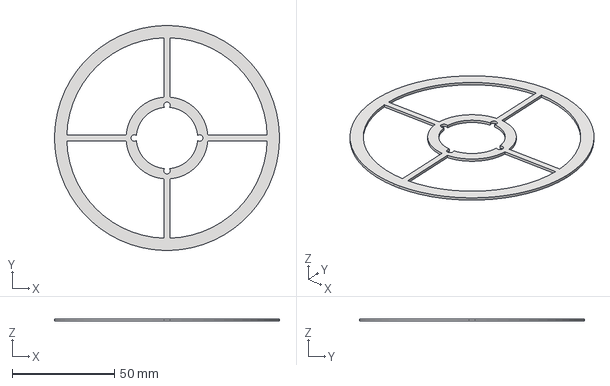
[picture p58: CAD file, 2026-10-08]
mechanical/cubli_revb/step/07_Brake_Drum.step
110.0 x 110.0 x 1.20 mm
