MiiGoto/reaction-wheel-pendulum/(list of files, cad)

Other CAD files:
mechanical/cubli_revb/step/28_Clip_Stack_Shim.step
mechanical/cubli_revb/step/14_Bearing_6000_2Z.step
mechanical/cubli_revb/step/03_Wheel_Spokes.step
mechanical/cubli_revb/step/08_Brake_Mechanism.step
mechanical/cubli_revb/step/17B_Bearing_Retainer_Front.step
mechanical/cubli_revb/step/Wheel_Comparison_C.step
mechanical/cubli_reva/one_wheel_module/step/01_Wheel_Rim.step
mechanical/cubli_reva/one_wheel_module/step/02_Wheel_Hub.step
mechanical/cubli_reva/one_wheel_module/step/03_Wheel_Spokes.step
mechanical/cubli_reva/one_wheel_module/step/04_Wheel_Shaft.step
mechanical/cubli_reva/one_wheel_module/step/05_Bearing_Housing.step
mechanical/cubli_reva/one_wheel_module/step/06_Motor_Mount.step
mechanical/cubli_reva/one_wheel_module/step/07_Brake_Drum.step
mechanical/cubli_reva/one_wheel_module/step/08B_Brake_Pad.step
mechanical/cubli_reva/one_wheel_module/step/08_Brake_Mechanism.step
mechanical/cubli_reva/one_wheel_module/step/09_Brake_Actuator_Bracket.step
mechanical/cubli_reva/one_wheel_module/step/10_Encoder_Mount.step
mechanical/cubli_reva/one_wheel_module/step/11_Module_Frame.step
mechanical/cubli_reva/one_wheel_module/step/12_Wheel_Guard.step
mechanical/cubli_reva/one_wheel_module/step/13_Torsional_Coupling.step
mechanical/cubli_reva/one_wheel_module/step/14B_Bearing_6000_2Z.step
mechanical/cubli_reva/one_wheel_module/step/14_Bearing_6000_2Z.step
mechanical/cubli_reva/one_wheel_module/step/15_Motor_4221G024BXTH.step
mechanical/cubli_reva/one_wheel_module/step/16_Motor_Rotor_Shaft.step
mechanical/cubli_reva/one_wheel_module/step/17B_Bearing_Retainer_Front.step
mechanical/cubli_reva/one_wheel_module/step/17_Bearing_Retainer_Rear.step
mechanical/cubli_reva/one_wheel_module/step/18_Encoder_Magnet.step
mechanical/cubli_reva/one_wheel_module/step/19_Encoder_PCB_Interface.step
mechanical/cubli_reva/one_wheel_module/step/20_Retaining_Washer.step
mechanical/cubli_reva/one_wheel_module/step/21_Retaining_Clip.step
mechanical/cubli_reva/one_wheel_module/step/22_Spacer_-22_-22.step
mechanical/cubli_reva/one_wheel_module/step/22_Spacer_-22_22.step
mechanical/cubli_reva/one_wheel_module/step/22_Spacer_22_-22.step
mechanical/cubli_reva/one_wheel_module/step/22_Spacer_22_22.step
mechanical/cubli_reva/one_wheel_module/step/23_Brake_Guide_-32.step
mechanical/cubli_reva/one_wheel_module/step/23_Brake_Guide_32.step
mechanical/cubli_reva/one_wheel_module/step/24B_Upper_Pad_Carrier.step
mechanical/cubli_reva/one_wheel_module/step/24_Lower_Pad_Carrier.step
mechanical/cubli_reva/one_wheel_module/step/25_Shaft_Key.step
mechanical/cubli_reva/one_wheel_module/step/26_Inner_Race_Spacer.step
mechanical/cubli_reva/one_wheel_module/step/27_Front_Hub_Shim.step
mechanical/cubli_reva/one_wheel_module/step/28_Clip_Stack_Shim.step
mechanical/cubli_reva/one_wheel_module/step/Cubli_OneWheel_Module_RevA.step
mechanical/cubli_reva/one_wheel_module/stl/10_Encoder_Mount.stl
mechanical/cubli_reva/one_wheel_module/stl/11_Module_Frame.stl
mechanical/cubli_reva/one_wheel_module/stl/12_Wheel_Guard.stl
mechanical/cubli_revb/step/20_Retaining_Washer.step
mechanical/cubli_revb/step/22_Spacer_-15_15.step
mechanical/cubli_revb/step/22_Spacer_15_-15.step
mechanical/cubli_revb/step/22_Spacer_15_15.step
mechanical/cubli_revb/step/23_Brake_Guide_10.step
mechanical/cubli_revb/step/29_Frame_Shim_-15_15.step
mechanical/cubli_revb/step/29_Frame_Shim_15_-15.step
mechanical/cubli_revb/step/29_Frame_Shim_15_15.step
mechanical/cubli_revb/step/36_Spring_Seat_10.step
mechanical/cubli_revb/step/37_Return_Lower_10.step
mechanical/cubli_revb/step/38_Return_Upper_10.step
mechanical/cubli_revb/stl/10_Encoder_Mount.stl
mechanical/cubli_revb/stl/11_Module_Frame.stl
mechanical/cubli_revb/stl/12_Wheel_Guard.stl
