MiiGoto/reaction-wheel-pendulum/docs/manufacturing_holds.md

# Rev B manufacturing holds

No fabrication release. CAD review completion does not authorize manufacture or operation.

|ID|Hold|Evidence/next closure|
|---|---|---|
|H01|Self-righting angular momentum insufficient|CAD-based9506rpm minimum face-edge screen exceeds current drive and coupling envelope; redesign mass/radius/launch allocation|
|H02|Impulse brake actuator unqualified|PQ121..1.67s clamp unsuitable for rapid launch; qualify stored-energy latch or operating-rated fast actuator|
|H03|Wheel/guard speed qualification|Steel grade, joints, imbalance, fatigue, overspeed containment and printed guard certification missing|
|H04|Motor/coupling adapter|Ruland6mm-to10mm requires own5-to6 sleeve; runout/clamp/torque and spider ratings not fully verified|
|H05|Shaft/bearing stack|10mm seats,9.6x1.1 groove, key, shoulder, axial float, clip lugs, fastener stack and alloy fatigue certification|
|H06|Brake lining/springs|mu/pressure/temperature/wear, real spring wire/rate/solid height; closed-state spring solid-envelope overlaps|
|H07|Shared-frame load path|Grounded packing study, docking-to-host brackets and impact strength not final; FEA not run|
|H08|Electronics/battery/regeneration|Battery budget only, actual brackets/cabling/protection and regenerated energy sink not qualified|
|H09|Drawings/BOM completeness|IDW/PDF are dimensioned review sheets; all critical fits, screw lengths/quantities/material certificates still require detailed production drawings|

Native CAD kept local because Inventor absolute references embed private workstation paths.
Public artifacts are own neutral geometry and own scripts only. Third-party datasheets/CAD are not redistributed.
Physical tests, purchase and manufacture were not performed.

H09 detail:20 review IDW/PDF sheets;4 lack associative dimensions and the sampled wedge dimension labels need layout cleanup. Additional COM layout retries stopped after2 failures. Native part/IAM validation and exports succeeded separately.
