MiiGoto/reaction-wheel-pendulum/mechanical/cubli_revb/assembly_instructions.md

# Rev B module assembly review instructions

HOLD: drawings and neutral CAD are for engineering review, not production or energized testing.
1. Qualify axle material,10mm seats/groove/key and SKF6000-2Z fits; locate front outer ring and float rear according to final tolerance stack.
2. Assemble separated shaft bearings, shoulder, spacers/shims and DSH-10 retaining ring. Verify positive axial retention and free rotation by a future unpowered approved inspection.
3. Mount motor plate with M3 thread penetration <=3mm using measured screw stack; exact screw lengths HOLD.
4. Ruland6mm and10mm clamp hubs use own precision5-to6 sleeve, spider and hub gap; alignment/clamp qualification HOLD. Motor shaft must not carry brake radial loading.
5. Attach steel rim to aluminium spider and keyed hub with evenly distributed screws; actual screw lengths/locking and dynamic balance HOLD.
6. Attach disc, caliper and guides; set0.65/0.35mm modeled pad clearances. Install qualified linings and actual return springs; wire/solid height not in current envelope model.
7. Install dual wedge, offset clevis, stops and PQ12 slow proof actuator. OPEN/PARTIAL/CLOSED modeled input0/5/10mm; no physical actuation authorized.
8. Fit guarded cover and encoder envelope support. Wire routes, magnet alignment and service access must be reviewed against selected encoder and actual harness.
9. Shared docking ribs replace independent frame perimeter only in three-axis packing study; host load-path brackets remain HOLD.
No torque settings or maximum physical RPM are approved by these instructions.
