MiiGoto/reaction-wheel-pendulum/docs/validation_plan.md

# Validation gates — no physical actions authorized

| Gate | Current evidence | Required next evidence |
|---|---|---|
| Reference identity | N1 documents and software inspected; exactX not fetched | accessible target video/image or user confirmation of desired N1 motion |
| 1axis assets | historical native ERC0errors/1intentionalwarning, DRC0/0/unrouted0; original artifacts preserved | fresh checks before hardware edits; release90degree audit still pending |
| 3axis geometry | major-envelope AABB check, new native study where generated | full rotating assemblies, frame/guard/shaft/brake/cable/fastener interference and contact geometry |
| Motor | GB54 catalogue and failedget-up momentum screen | official continuous/pulse torque-speed, winding/thermal/braking data and exact mounting; shortlist alternatives |
| Power | energy/voltage rise calculations only | source/absorber/battery/fuse/harness ratings, simultaneous braking duty and independent shutdown |
| Dynamics | fixed-corner small-tilt RK4cases only | actualCADtensor, numerical convergence, gravity/gyro conservation, modelled contact/impacts/friction and uncertainty sweeps |
| Firmware/CAN | protocol and frame-budget analysis | WCET, sample/command age, simultaneous3axisbus trace, measured FOC delay and fault injection |
| Manufacturing | not ready | drawing tolerances, material/print orientation/strength, bearings/fasteners/retention, wheel balance and guard safety |

Self-righting hybrid model must allow support face, edge and point switching, unilateral contact, friction and body/wheel coupling. Compare electrical torque-limited braking with a measured/qualified mechanical-band model. Do not treat required angular momentum as sufficient for get-up, or copied video behavior as proof of our mechanism.

No parts bought, orders placed, motor spin, commissioning or powered test. Existing RoboMaster supercapacitor project is unrelated/unqualified and must not be connected. Simulation speed threshold is not a safe test speed. No manufacturing drawings/export package is released until blockers are resolved.

Read-only baseline recheck2026-10-08: ERC0errors/1intentionalSDXwarning;DRC0errors/0warnings/unrouted0/parity0. Raw CLI reports stayed in temporary storage because they contain local paths; public summary:electrical_baseline_check.json. PCB/schematic unchanged; these counts do not qualify the new mechanical system. STEP native reimport31occurrences/180mmcube confirmed. Momentum and energy conserved in zero-gravity/zero-torque test (worldHerror2.2e-17Nms,Eerror0J); independent analytical/nativeassumedtensor agreement1.1e-10kgm². These do not close motor, contact or strength gates.

Recommended next single task: actuator/brake/energy-path down-selection using the actual target mass/COM and measured or manufacturer-certified limits; compare2–3candidates, recompute contact-transition impulse and decide before finishing mounts.
