MiiGoto/reaction-wheel-pendulum/mechanical/cubli_revb/drawings/01_Wheel_Rim.pdf

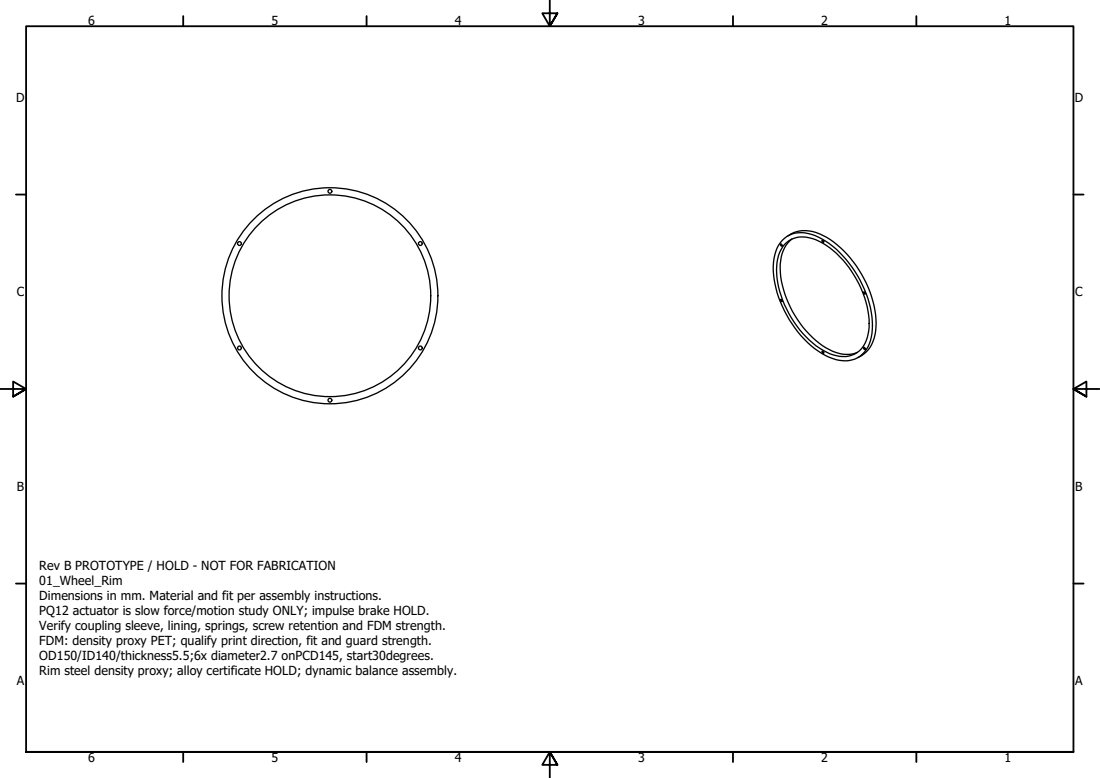
[picture p59: page 1]

Rev B PROTOTYPE / HOLD - NOT FOR FABRICATION
01_Wheel_Rim
Dimensions in mm. Material and fit per assembly instructions.
PQ12 actuator is slow force/motion study ONLY; impulse brake HOLD.
Verify coupling sleeve, lining, springs, screw retention and FDM strength.
FDM: density proxy PET; qualify print direction, fit and guard strength.
OD150/ID140/thickness5.5;6x diameter2.7 onPCD145, start30degrees.
Rim steel density proxy; alloy certificate HOLD; dynamic balance assembly.
