MiiGoto/reaction-wheel-pendulum/mechanical/cubli_revb/drawings/04_Wheel_Shaft.pdf

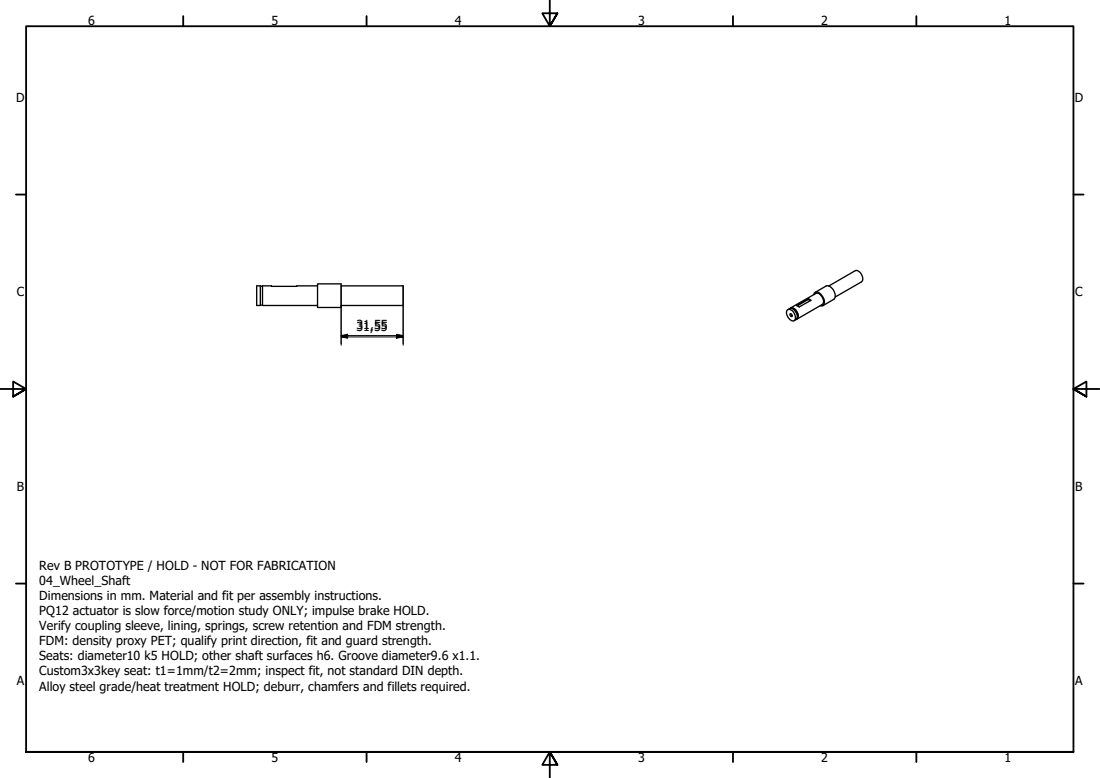
[picture p60: page 1]

Rev B PROTOTYPE / HOLD - NOT FOR FABRICATION
04_Wheel_Shaft
Dimensions in mm. Material and fit per assembly instructions.
PQ12 actuator is slow force/motion study ONLY; impulse brake HOLD.
Verify coupling sleeve, lining, springs, screw retention and FDM strength.
FDM: density proxy PET; qualify print direction, fit and guard strength.
Seats: diameter10 k5 HOLD; other shaft surfaces h6. Groove diameter9.6 x1.1.
Custom3x3key seat: t1=1mm/t2=2mm; inspect fit, not standard DIN depth.
Alloy steel grade/heat treatment HOLD; deburr, chamfers and fillets required.
