MiiGoto/reaction-wheel-pendulum/mechanical/cubli_revb/drawings/05_Bearing_Housing.pdf

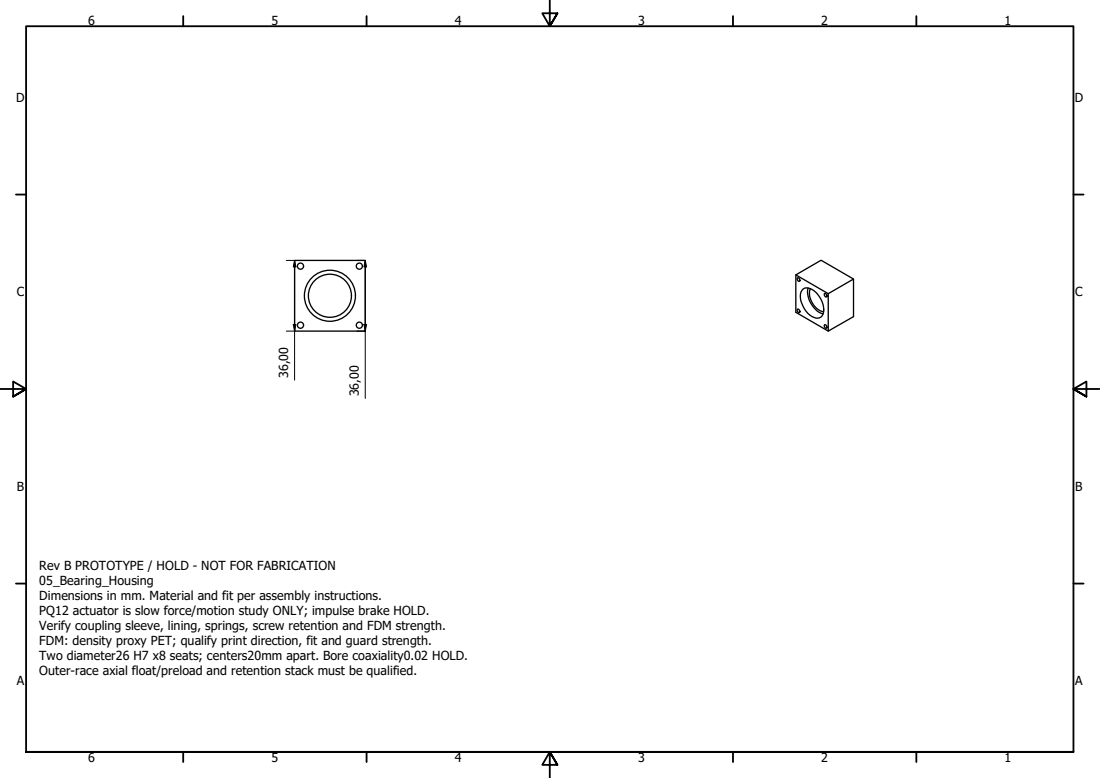
[picture p61: page 1]

Rev B PROTOTYPE / HOLD - NOT FOR FABRICATION
05_Bearing_Housing
Dimensions in mm. Material and fit per assembly instructions.
PQ12 actuator is slow force/motion study ONLY; impulse brake HOLD.
Verify coupling sleeve, lining, springs, screw retention and FDM strength.
FDM: density proxy PET; qualify print direction, fit and guard strength.
Two diameter26 H7 x8 seats; centers20mm apart. Bore coaxiality0.02 HOLD.
Outer-race axial float/preload and retention stack must be qualified.
