MiiGoto/reaction-wheel-pendulum/mechanical/cubli_revb/drawings/06_Motor_Mount.pdf

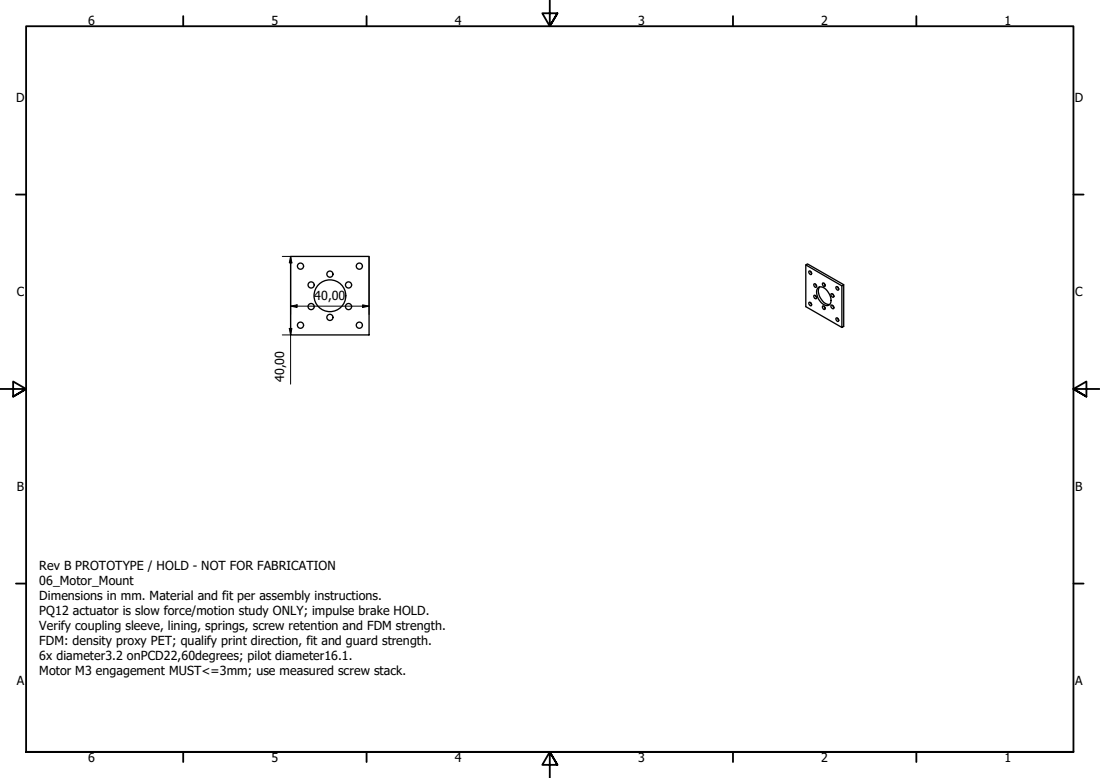
[picture p62: page 1]

Rev B PROTOTYPE / HOLD - NOT FOR FABRICATION
06_Motor_Mount
Dimensions in mm. Material and fit per assembly instructions.
PQ12 actuator is slow force/motion study ONLY; impulse brake HOLD.
Verify coupling sleeve, lining, springs, screw retention and FDM strength.
FDM: density proxy PET; qualify print direction, fit and guard strength.
6x diameter3.2 onPCD22,60degrees; pilot diameter16.1.
Motor M3 engagement MUST<=3mm; use measured screw stack.
