MiiGoto/reaction-wheel-pendulum/mechanical/cubli_reva/one_wheel_module/drawings/01_Wheel_Rim.pdf

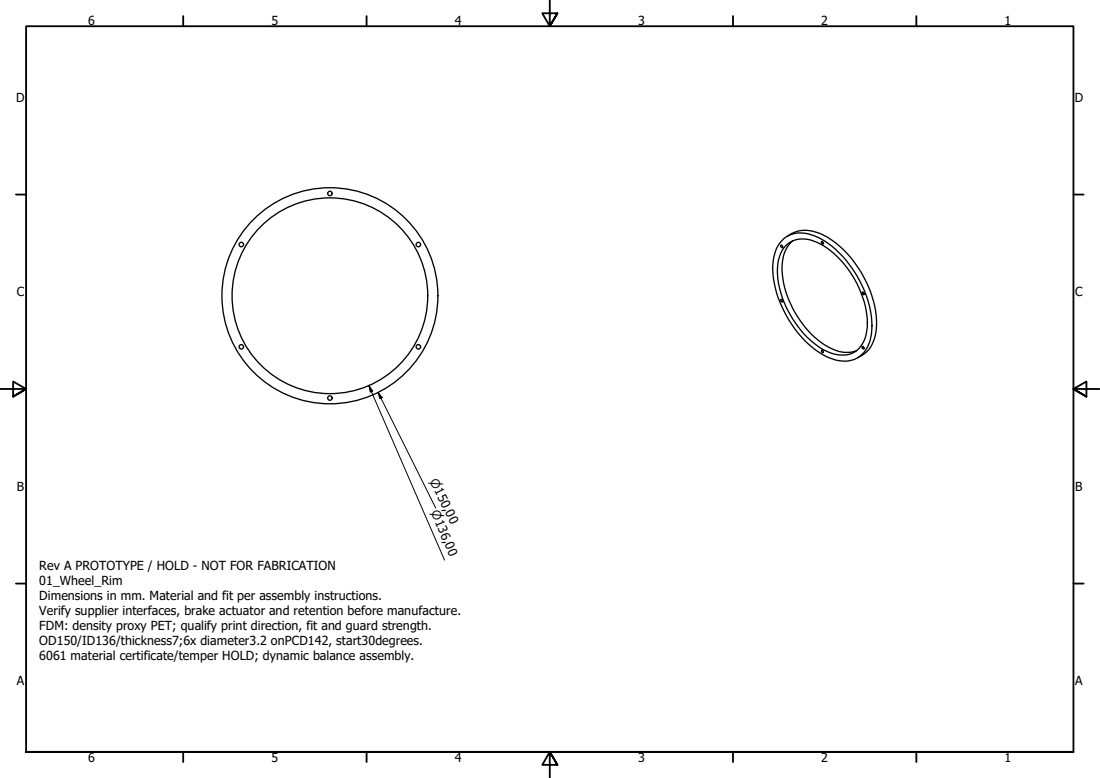
[picture p63: page 1]

Rev A PROTOTYPE / HOLD - NOT FOR FABRICATION
01_Wheel_Rim
Dimensions in mm. Material and fit per assembly instructions.
Verify supplier interfaces, brake actuator and retention before manufacture.
FDM: density proxy PET; qualify print direction, fit and guard strength.
OD150/ID136/thickness7;6x diameter3.2 onPCD142, start30degrees.
6061 material certificate/temper HOLD; dynamic balance assembly.
