MiiGoto/reaction-wheel-pendulum/hardware/kicad/reaction_wheel_controller.kicad_pcb

## KiCad design hardware/kicad/reaction_wheel_controller.kicad_pcb (2026-10-04)

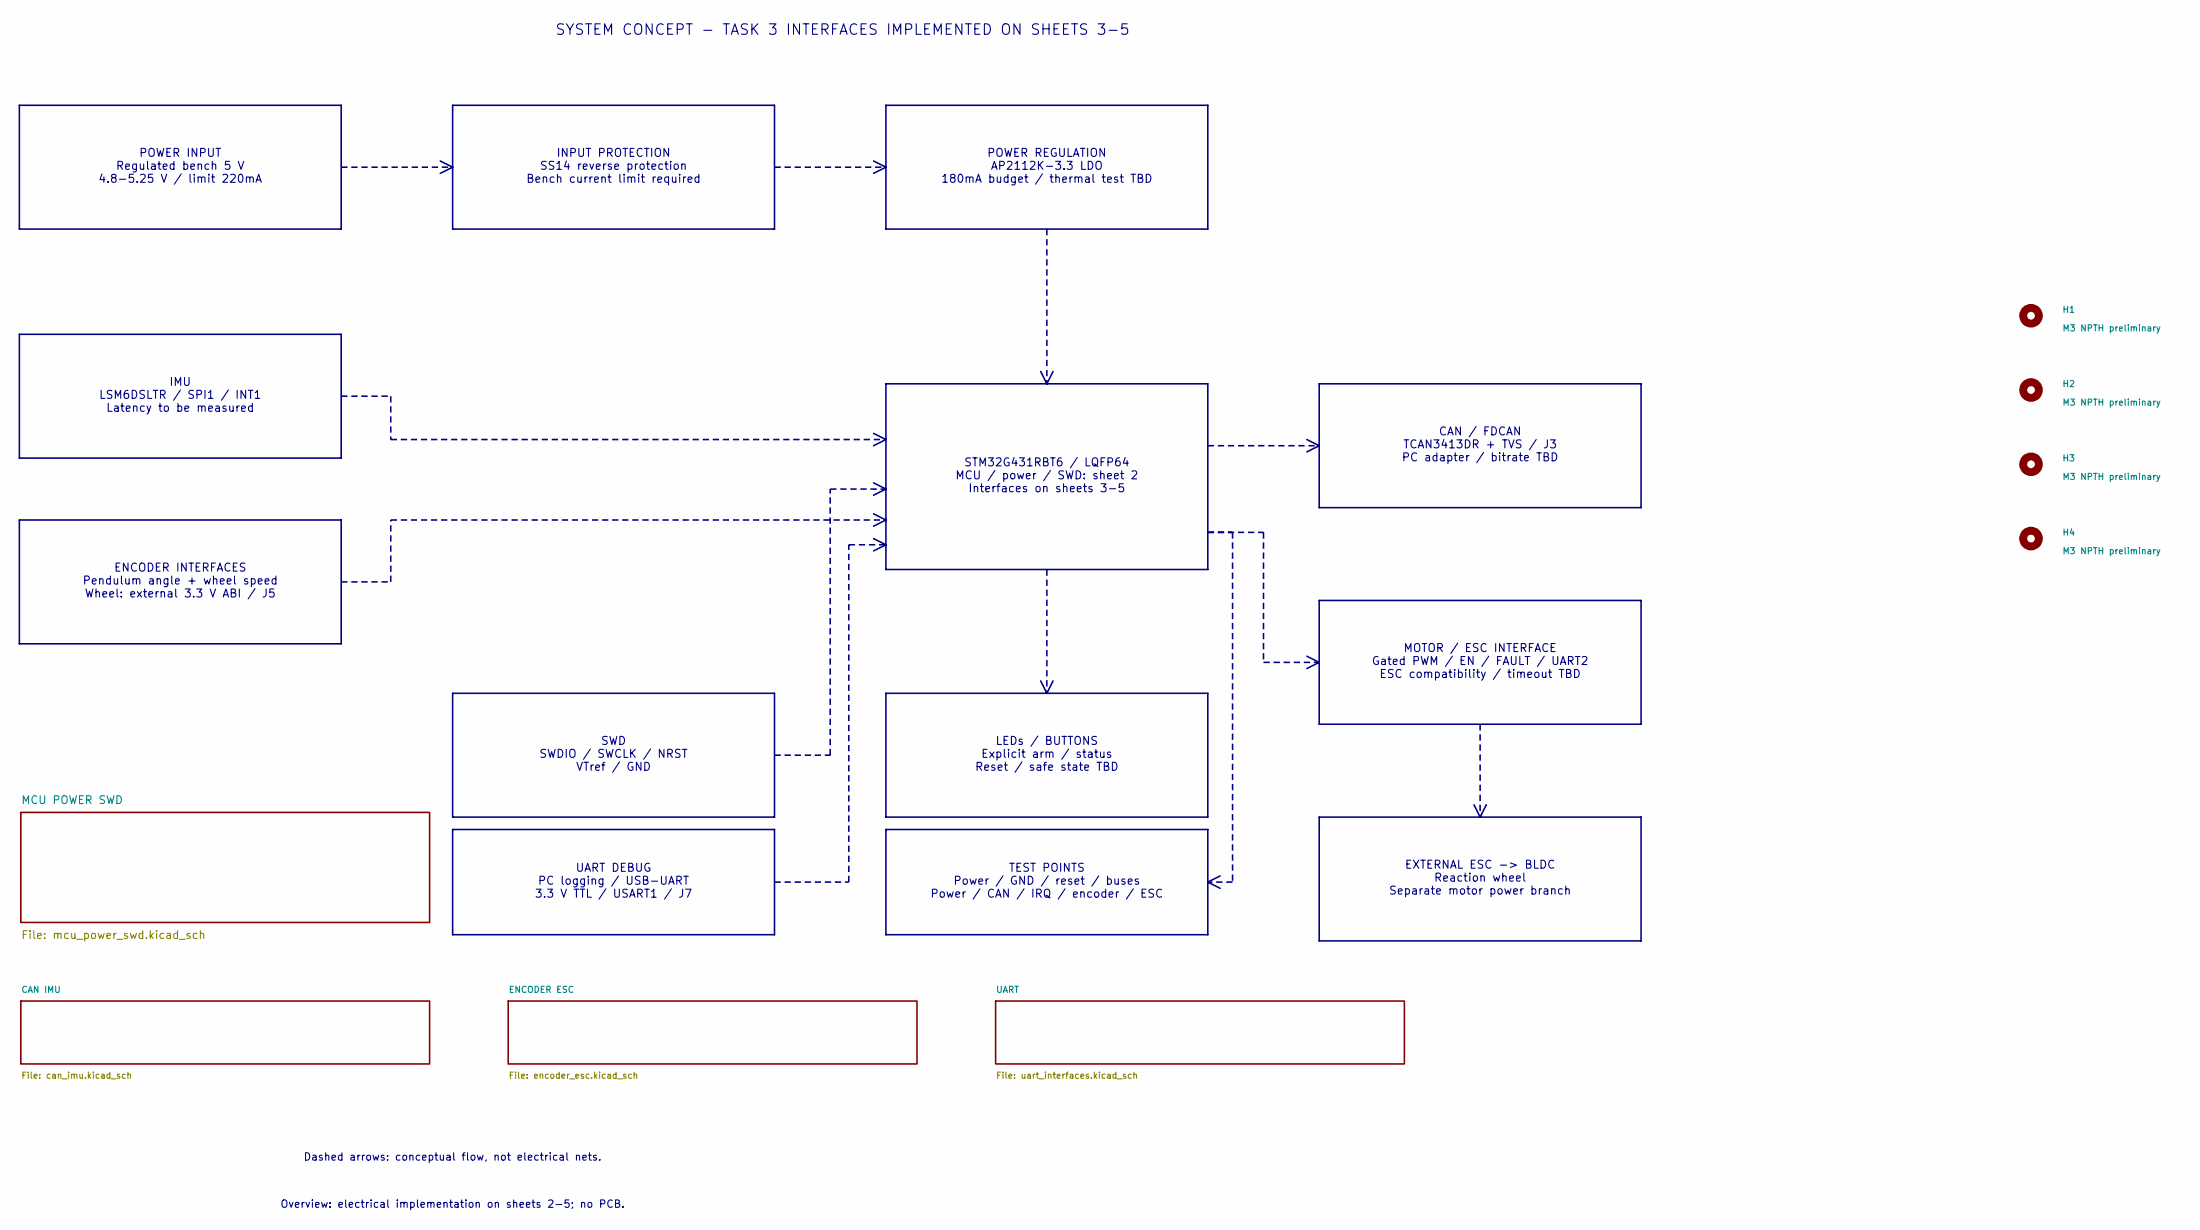
[picture p64: schematic reaction_wheel_controller.kicad_sch, Reaction Wheel Controller - Concept Blocks]

Parts:
H1, H2, H3, H4: M3 NPTH preliminary; MountingHole_3.2mm_M3

Notes on the sheet:
SYSTEM CONCEPT - TASK 3 INTERFACES IMPLEMENTED ON SHEETS 3-5
POWER INPUT Regulated bench 5 V 4.8-5.25 V / limit 220mA
INPUT PROTECTION SS14 reverse protection Bench current limit required
POWER REGULATION AP2112K-3.3 LDO 180mA budget / thermal test TBD
STM32G431RBT6 / LQFP64 MCU / power / SWD: sheet 2 Interfaces on sheets 3-5
IMU LSM6DSLTR / SPI1 / INT1 Latency to be measured
ENCODER INTERFACES Pendulum angle + wheel speed Wheel: external 3.3 V ABI / J5
CAN / FDCAN TCAN3413DR + TVS / J3 PC adapter / bitrate TBD
MOTOR / ESC INTERFACE Gated PWM / EN / FAULT / UART2 ESC compatibility / timeout TBD
EXTERNAL ESC -> BLDC Reaction wheel Separate motor power branch
SWD SWDIO / SWCLK / NRST VTref / GND
UART DEBUG PC logging / USB-UART 3.3 V TTL / USART1 / J7
LEDs / BUTTONS Explicit arm / status Reset / safe state TBD
TEST POINTS Power / GND / reset / buses Power / CAN / IRQ / encoder / ESC
Dashed arrows: conceptual flow, not electrical nets.
Overview: electrical implementation on sheets 2-5; no PCB.

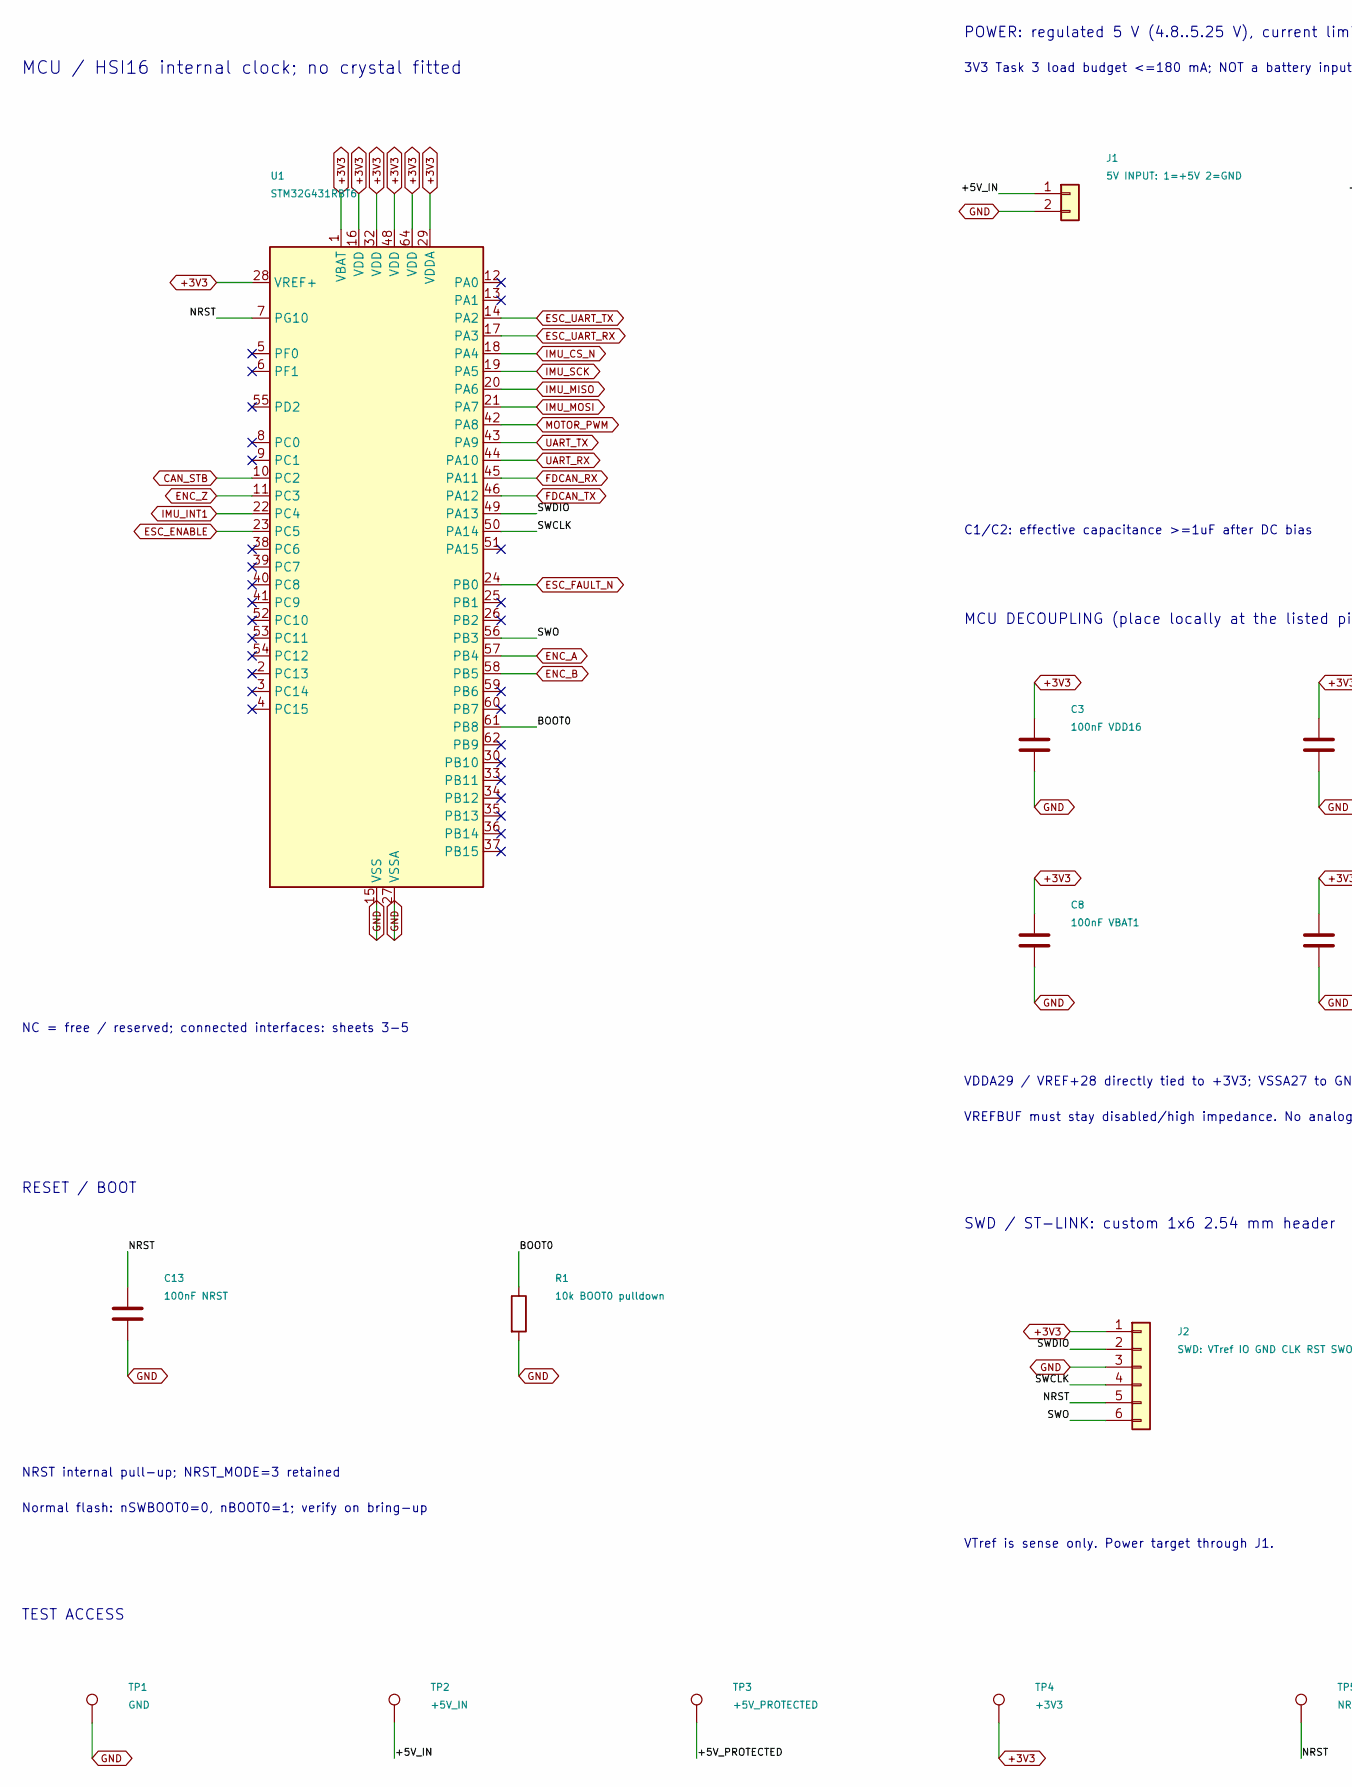
[picture p65: schematic mcu_power_swd.kicad_sch, MCU + power + SWD - Task 3 connections, part in row 1, column 1]

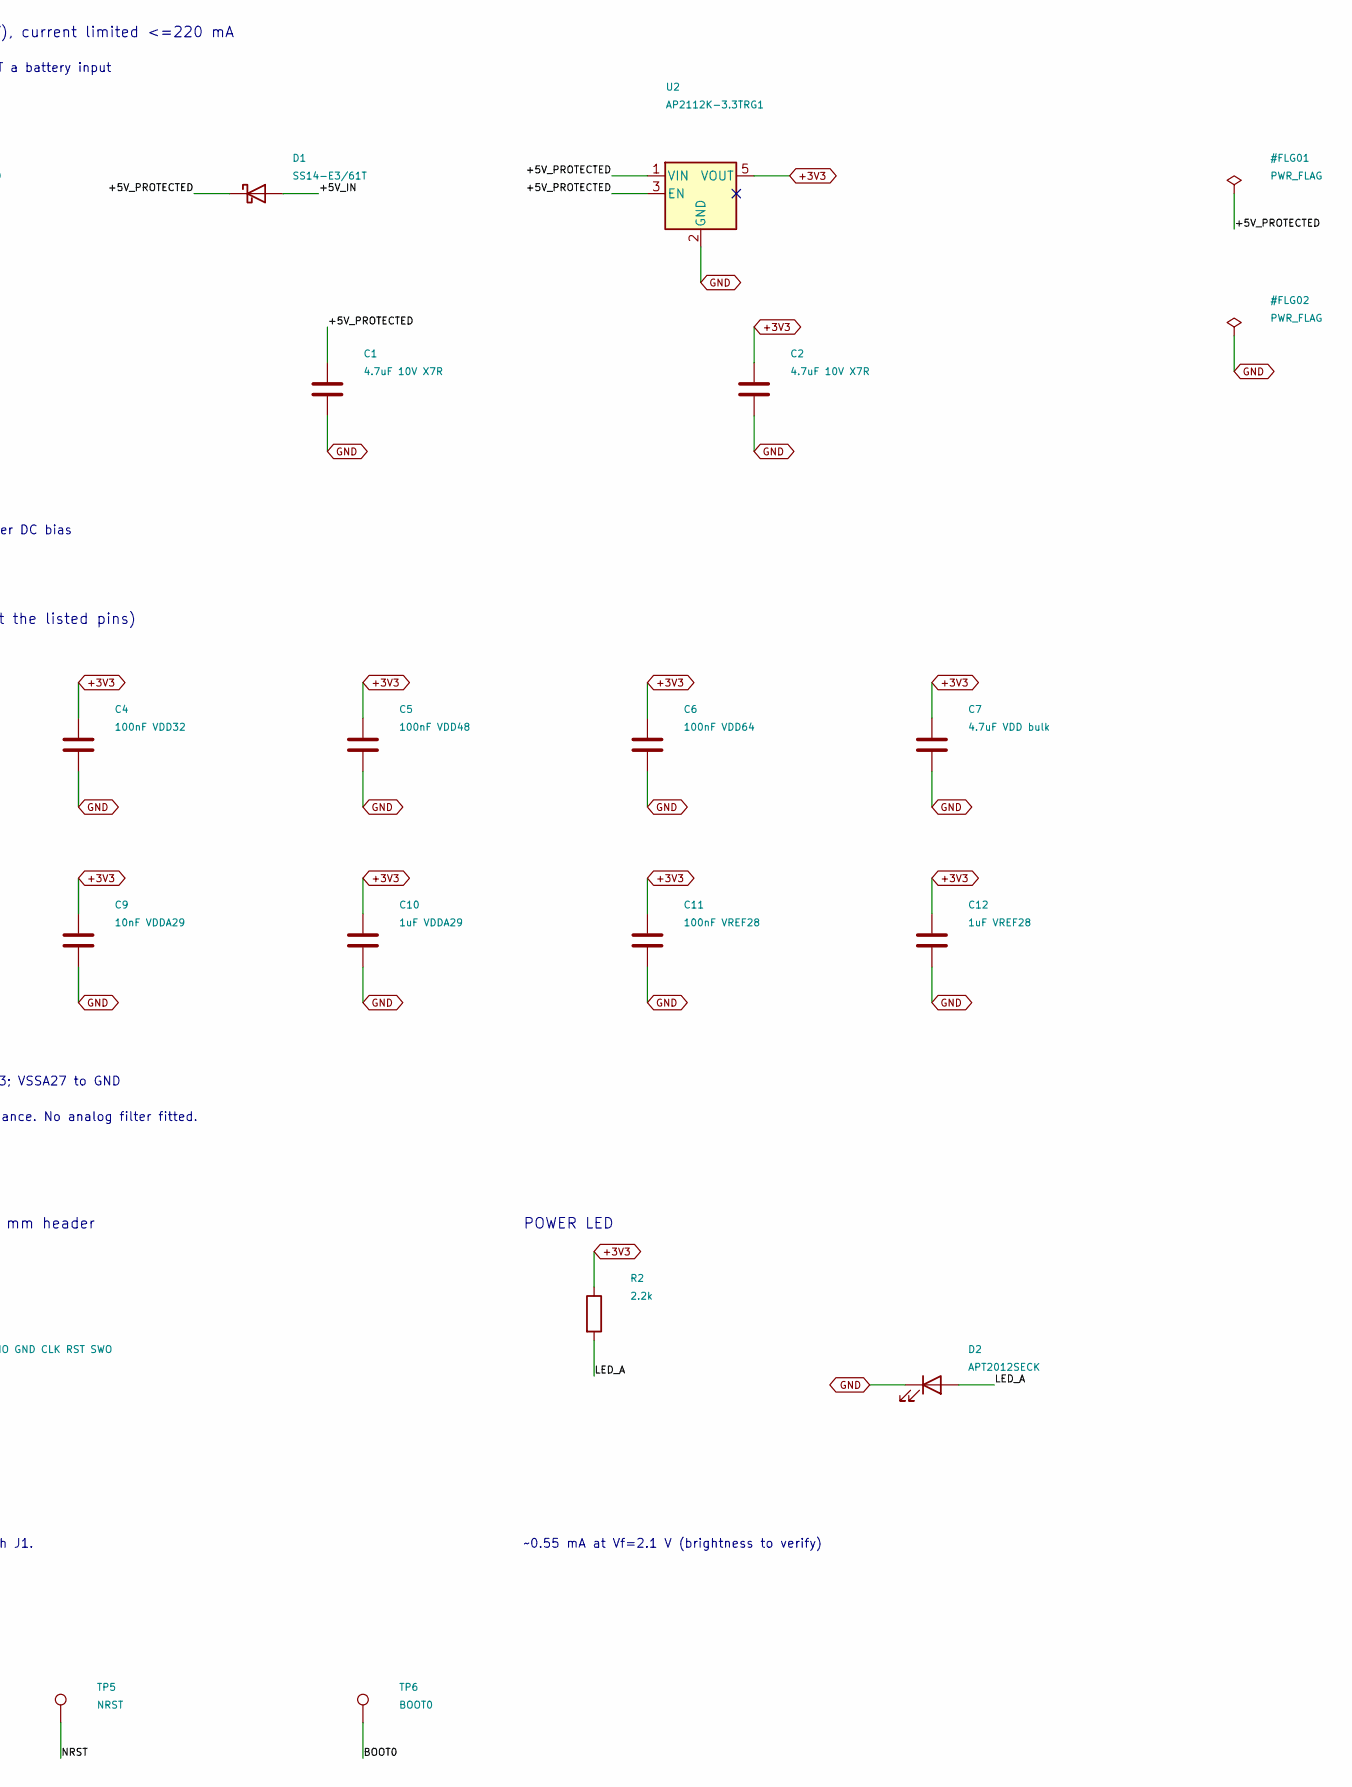
[picture p66: schematic mcu_power_swd.kicad_sch, MCU + power + SWD - Task 3 connections, part in row 1, column 2]

Parts:
C1, C2: 4.7uF 10V X7R; C_0805_2012Metric
C3: 100nF VDD16; C_0805_2012Metric
C4: 100nF VDD32; C_0805_2012Metric
C5: 100nF VDD48; C_0805_2012Metric
C6: 100nF VDD64; C_0805_2012Metric
C7: 4.7uF VDD bulk; C_0805_2012Metric
C8: 100nF VBAT1; C_0805_2012Metric
C9: 10nF VDDA29; C_0805_2012Metric
C10: 1uF VDDA29; C_0805_2012Metric
C11: 100nF VREF28; C_0805_2012Metric
C12: 1uF VREF28; C_0805_2012Metric
C13: 100nF NRST; C_0805_2012Metric
D1: SS14-E3/61T; D_SMA
D2: APT2012SECK; LED_0805_2012Metric
J1: 5V INPUT: 1=+5V 2=GND; PinHeader_1x02_P2.54mm_Vertical
J2: SWD: VTref IO GND CLK RST SWO; PinHeader_1x06_P2.54mm_Vertical
R1: 10k BOOT0 pulldown; R_0805_2012Metric
R2: 2.2k; R_0805_2012Metric
TP1: GND; TestPoint_Pad_D1.5mm
TP2: +5V_IN; TestPoint_Pad_D1.5mm
TP3: +5V_PROTECTED; TestPoint_Pad_D1.5mm
TP4: +3V3; TestPoint_Pad_D1.5mm
TP5: NRST; TestPoint_Pad_D1.5mm
TP6: BOOT0; TestPoint_Pad_D1.5mm
U1: STM32G431RBT6; LQFP-64_10x10mm_P0.5mm
U2: AP2112K-3.3TRG1; SOT-23-5

Connections:
+3V3: C2.1, C3.1, C4.1, C5.1, C6.1, C7.1, C8.1, C9.1, C10.1, C11.1, C12.1, J2.1, R2.1, TP4.1, U1.1 (VBAT), U1.16 (VDD), U1.28 (VREF+), U1.29 (VDDA), U1.32 (VDD), U1.48 (VDD), U1.64 (VDD), U2.5 (VOUT); also elsewhere on the board
/MCU POWER SWD/+5V_IN: D1.2 (A), J1.1, TP2.1
/MCU POWER SWD/+5V_PROTECTED: C1.1, D1.1 (K), TP3.1, U2.1 (VIN), U2.3 (EN)
/MCU POWER SWD/BOOT0: R1.1, TP6.1, U1.61 (PB8)
/MCU POWER SWD/LED_A: D2.2 (A), R2.2
/MCU POWER SWD/NRST: C13.1, J2.5, TP5.1, U1.7 (PG10)
/MCU POWER SWD/SWCLK: J2.4, U1.50 (PA14)
/MCU POWER SWD/SWDIO: J2.2, U1.49 (PA13)
/MCU POWER SWD/SWO: J2.6, U1.56 (PB3)
CAN_STB: U1.10 (PC2); also elsewhere on the board
ENC_A: U1.57 (PB4); also elsewhere on the board
ENC_B: U1.58 (PB5); also elsewhere on the board
ENC_Z: U1.11 (PC3); also elsewhere on the board
ESC_ENABLE: U1.23 (PC5); also elsewhere on the board
ESC_FAULT_N: U1.24 (PB0); also elsewhere on the board
ESC_UART_RX: U1.17 (PA3); also elsewhere on the board
ESC_UART_TX: U1.14 (PA2); also elsewhere on the board
FDCAN_RX: U1.45 (PA11); also elsewhere on the board
FDCAN_TX: U1.46 (PA12); also elsewhere on the board
GND: C1.2, C2.2, C3.2, C4.2, C5.2, C6.2, C7.2, C8.2, C9.2, C10.2, C11.2, C12.2, C13.2, D2.1 (K), J1.2, J2.3, R1.2, TP1.1, U1.15 (VSS), U1.27 (VSSA), U1.31 (VSS), U1.47 (VSS), U1.63 (VSS), U2.2 (GND); also elsewhere on the board
IMU_CS_N: U1.18 (PA4); also elsewhere on the board
IMU_INT1: U1.22 (PC4); also elsewhere on the board
IMU_MISO: U1.20 (PA6); also elsewhere on the board
IMU_MOSI: U1.21 (PA7); also elsewhere on the board
IMU_SCK: U1.19 (PA5); also elsewhere on the board
MOTOR_PWM: U1.42 (PA8); also elsewhere on the board
UART_RX: U1.44 (PA10); also elsewhere on the board
UART_TX: U1.43 (PA9); also elsewhere on the board

Notes on the sheet:
MCU / HSI16 internal clock; no crystal fitted
NC = free / reserved; connected interfaces: sheets 3-5
POWER: regulated 5 V (4.8..5.25 V), current limited <=220 mA
3V3 Task 3 load budget <=180 mA; NOT a battery input
C1/C2: effective capacitance >=1uF after DC bias
MCU DECOUPLING (place locally at the listed pins)
VDDA29 / VREF+28 directly tied to +3V3; VSSA27 to GND
VREFBUF must stay disabled/high impedance. No analog filter fitted.
RESET / BOOT
NRST internal pull-up; NRST_MODE=3 retained
Normal flash: nSWBOOT0=0, nBOOT0=1; verify on bring-up
SWD / ST-LINK: custom 1x6 2.54 mm header
VTref is sense only. Power target through J1.
POWER LED
~0.55 mA at Vf=2.1 V (brightness to verify)
TEST ACCESS

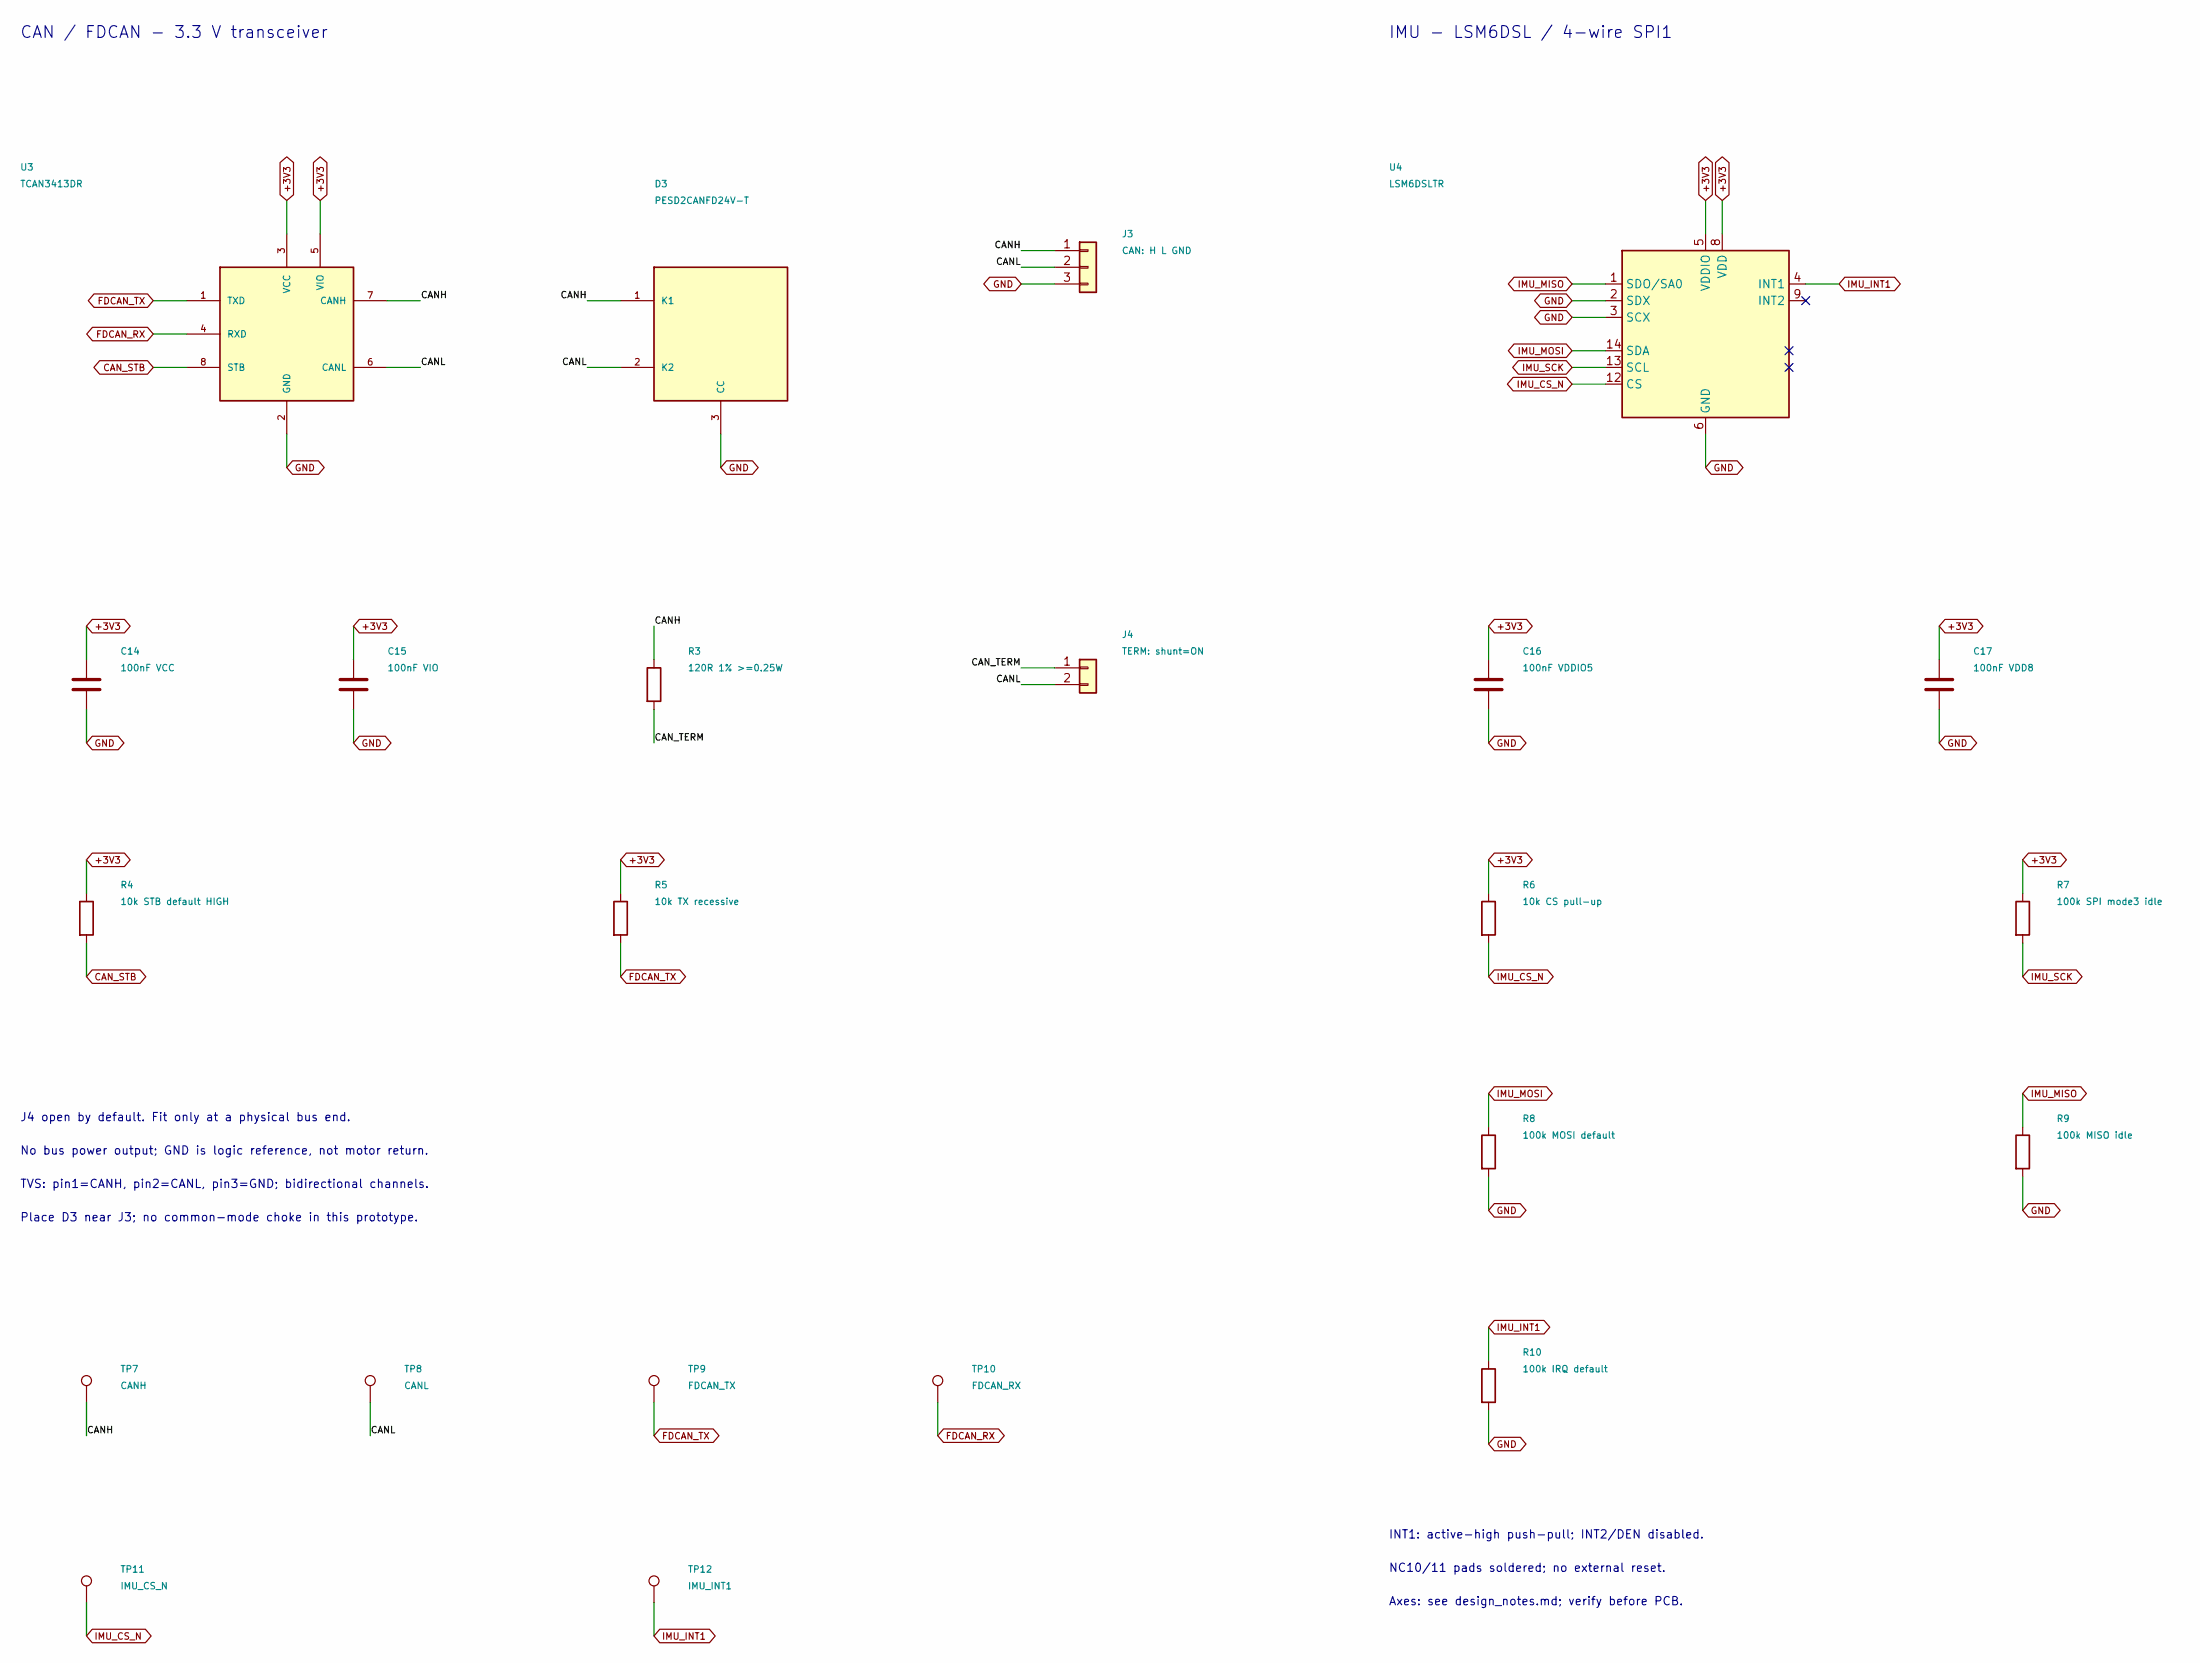
[picture p67: schematic can_imu.kicad_sch, CAN + IMU - Task 3]

Parts:
C14: 100nF VCC; C_0805_2012Metric
C15: 100nF VIO; C_0805_2012Metric
C16: 100nF VDDIO5; C_0805_2012Metric
C17: 100nF VDD8; C_0805_2012Metric
D3: PESD2CANFD24V-T; SOT-23
J3: CAN: H L GND; PinHeader_1x03_P2.54mm_Vertical
J4: TERM: shunt=ON; PinHeader_1x02_P2.54mm_Vertical
R3: 120R 1% >=0.25W; R_1206_3216Metric
R4: 10k STB default HIGH; R_0805_2012Metric
R5: 10k TX recessive; R_0805_2012Metric
R6: 10k CS pull-up; R_0805_2012Metric
R7: 100k SPI mode3 idle; R_0805_2012Metric
R8: 100k MOSI default; R_0805_2012Metric
R9: 100k MISO idle; R_0805_2012Metric
R10: 100k IRQ default; R_0805_2012Metric
TP7: CANH; TestPoint_Pad_D1.5mm
TP8: CANL; TestPoint_Pad_D1.5mm
TP9: FDCAN_TX; TestPoint_Pad_D1.5mm
TP10: FDCAN_RX; TestPoint_Pad_D1.5mm
TP11: IMU_CS_N; TestPoint_Pad_D1.5mm
TP12: IMU_INT1; TestPoint_Pad_D1.5mm
U3: TCAN3413DR; SOIC-8_3.9x4.9mm_P1.27mm
U4: LSM6DSLTR; LGA-14_3x2.5mm_P0.5mm_LayoutBorder3x4y

Connections:
+3V3: C14.1, C15.1, C16.1, C17.1, R4.1, R5.1, R6.1, R7.1, U3.3 (VCC), U3.5 (VIO), U4.5 (VDDIO), U4.8 (VDD); also elsewhere on the board
/CAN IMU/CANH: D3.1 (K1), J3.1, R3.1, TP7.1, U3.7 (CANH)
/CAN IMU/CANL: D3.2 (K2), J3.2, J4.2, TP8.1, U3.6 (CANL)
/CAN IMU/CAN_TERM: J4.1, R3.2
CAN_STB: R4.2, U3.8 (STB); also elsewhere on the board
FDCAN_RX: TP10.1, U3.4 (RXD); also elsewhere on the board
FDCAN_TX: R5.2, TP9.1, U3.1 (TXD); also elsewhere on the board
GND: C14.2, C15.2, C16.2, C17.2, D3.3 (CC), J3.3, R8.2, R9.2, R10.2, U3.2 (GND), U4.2 (SDX), U4.3 (SCX), U4.6 (GND), U4.7 (GND); also elsewhere on the board
IMU_CS_N: R6.2, TP11.1, U4.12 (CS); also elsewhere on the board
IMU_INT1: R10.1, TP12.1, U4.4 (INT1); also elsewhere on the board
IMU_MISO: R9.1, U4.1 (SDO/SA0); also elsewhere on the board
IMU_MOSI: R8.1, U4.14 (SDA); also elsewhere on the board
IMU_SCK: R7.2, U4.13 (SCL); also elsewhere on the board

Notes on the sheet:
CAN / FDCAN - 3.3 V transceiver
J4 open by default. Fit only at a physical bus end.
No bus power output; GND is logic reference, not motor return.
TVS: pin1=CANH, pin2=CANL, pin3=GND; bidirectional channels.
Place D3 near J3; no common-mode choke in this prototype.
IMU - LSM6DSL / 4-wire SPI1
INT1: active-high push-pull; INT2/DEN disabled.
NC10/11 pads soldered; no external reset.
Axes: see design_notes.md; verify before PCB.

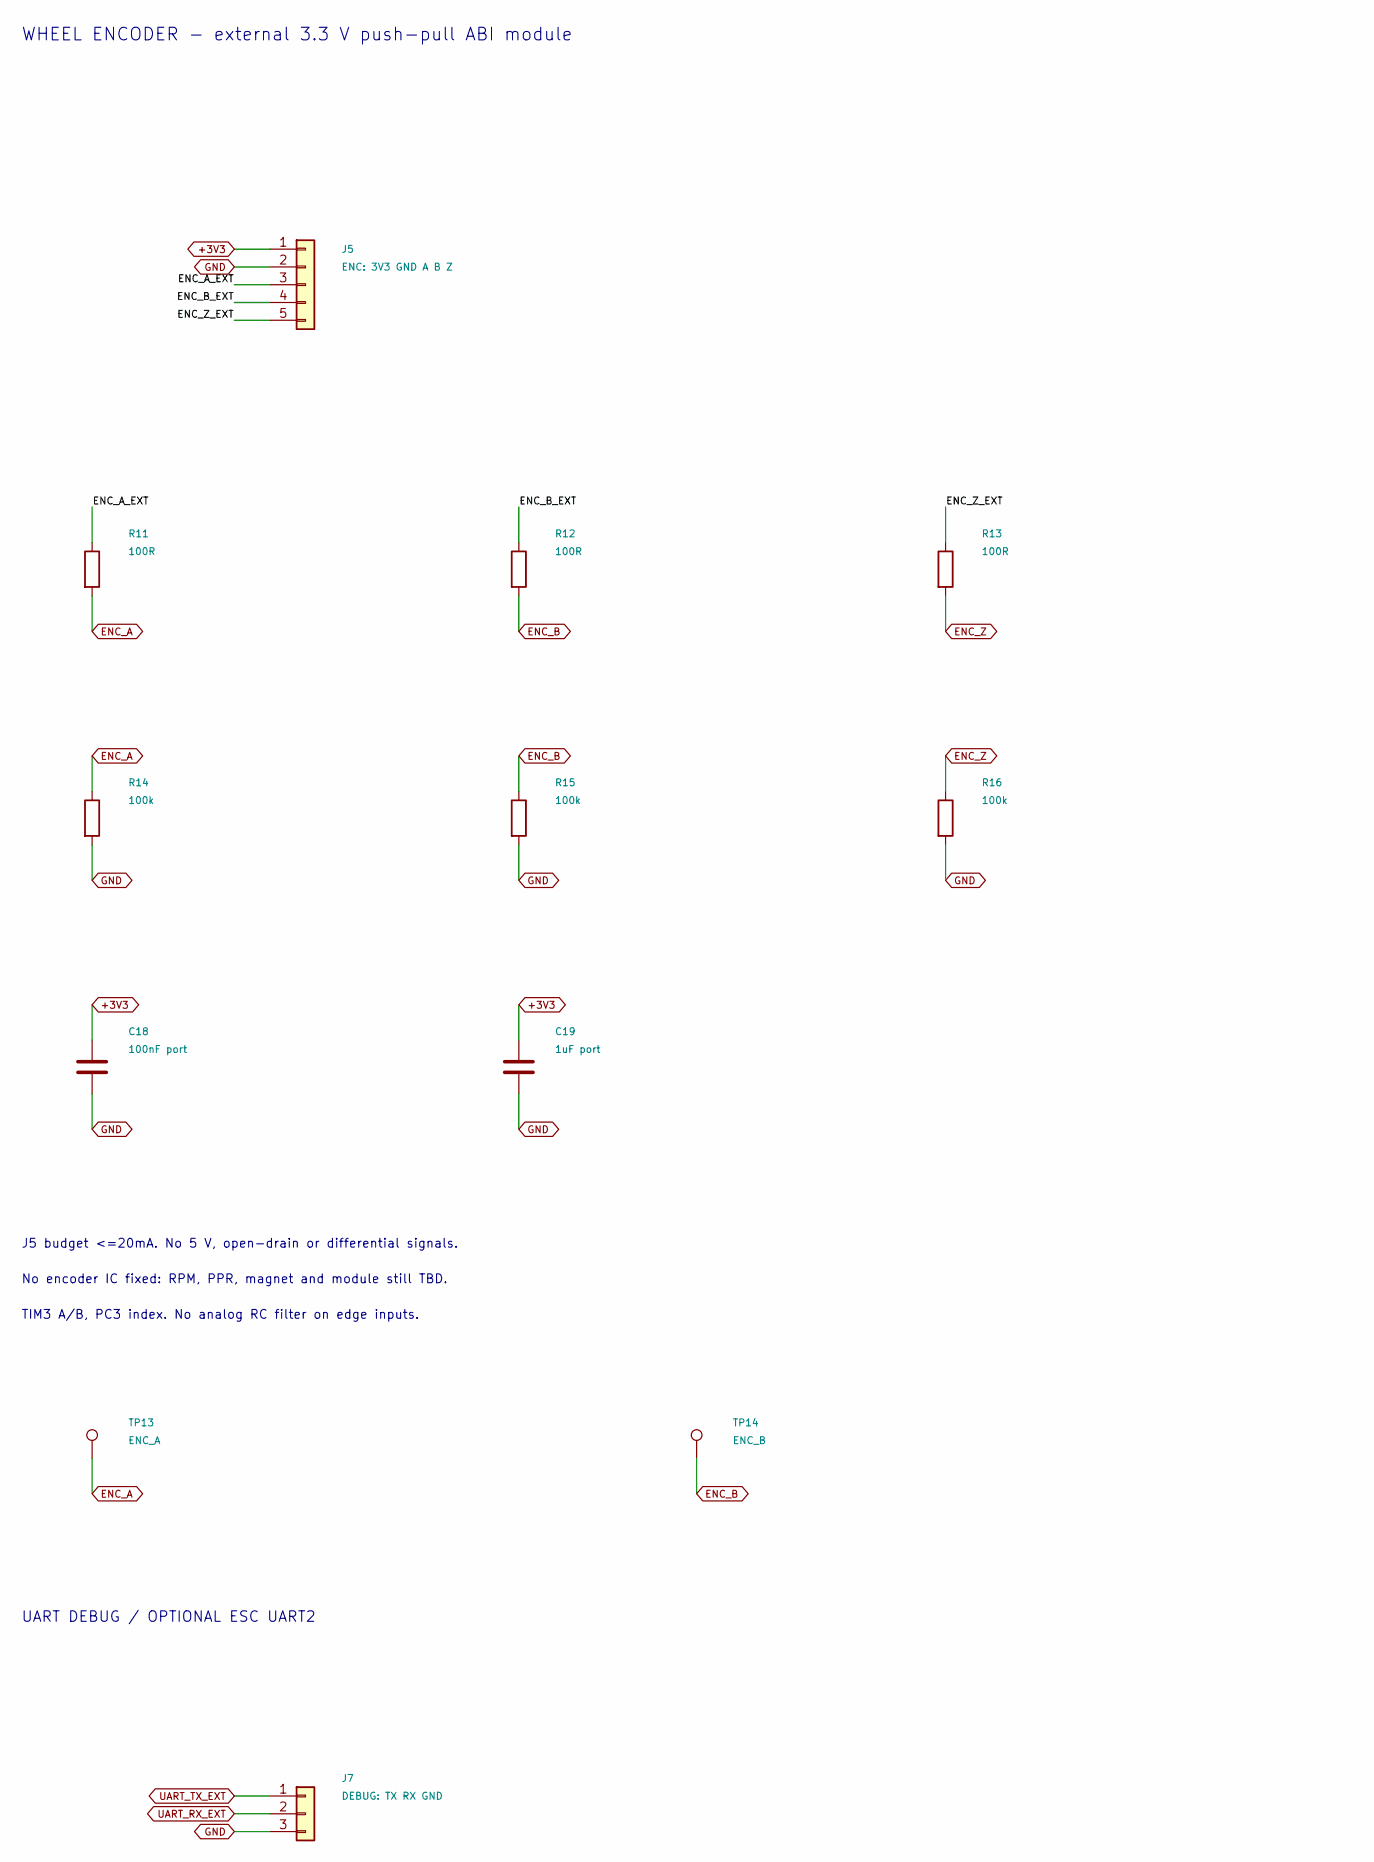
[picture p68: schematic encoder_esc.kicad_sch, Encoder + external ESC + debug - Task 3, part in row 1, column 1]

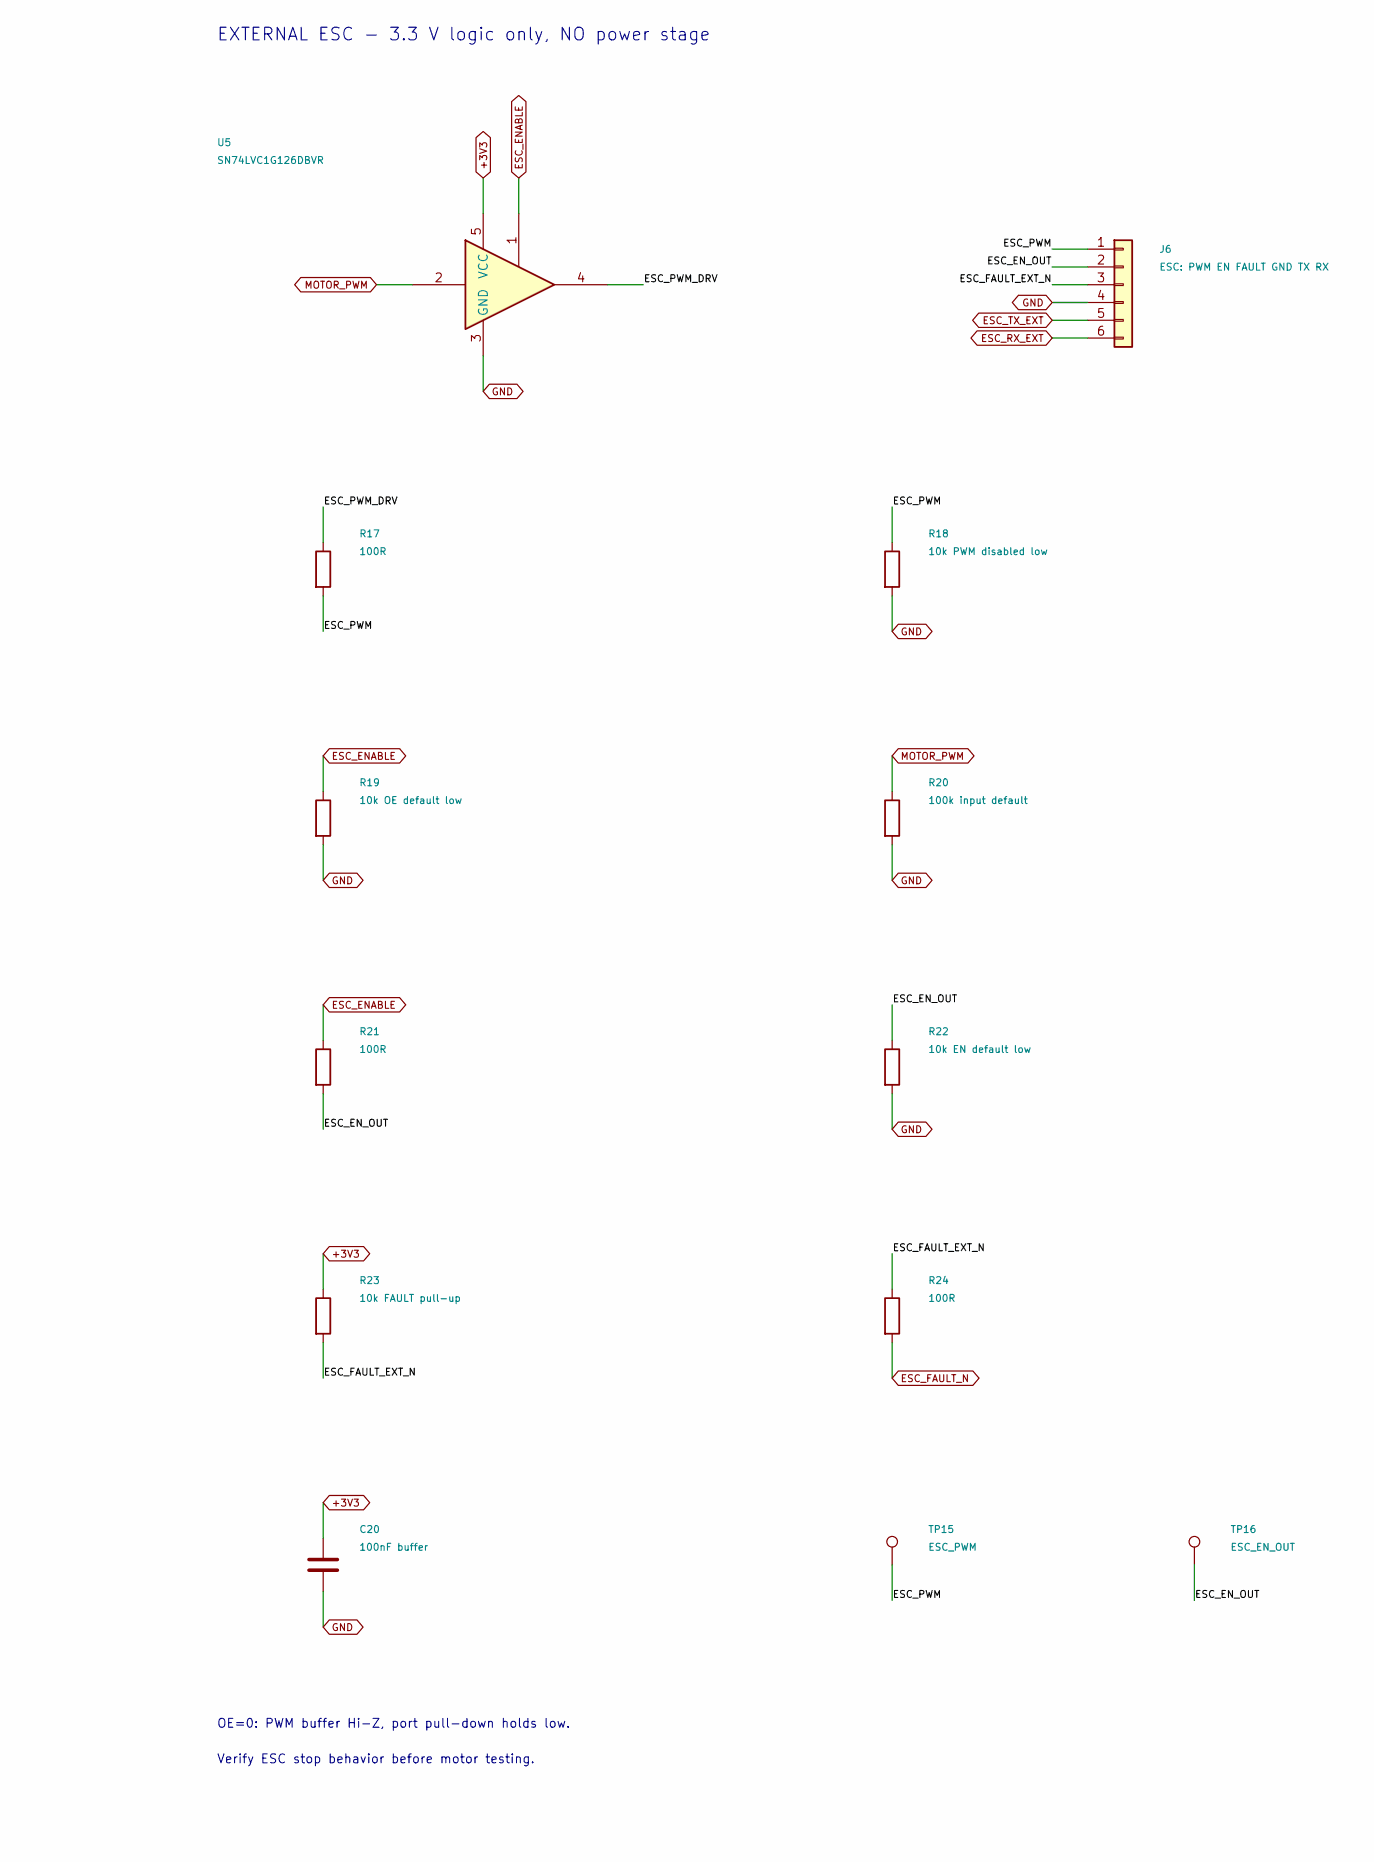
[picture p69: schematic encoder_esc.kicad_sch, Encoder + external ESC + debug - Task 3, part in row 1, column 2]

Parts:
C18: 100nF port; C_0805_2012Metric
C19: 1uF port; C_0805_2012Metric
C20: 100nF buffer; C_0805_2012Metric
J5: ENC: 3V3 GND A B Z; PinHeader_1x05_P2.54mm_Vertical
J6: ESC: PWM EN FAULT GND TX RX; PinHeader_1x06_P2.54mm_Vertical
J7: DEBUG: TX RX GND; PinHeader_1x03_P2.54mm_Vertical
R11, R12, R13, R17, R21, R24: 100R; R_0805_2012Metric
R14, R15, R16: 100k; R_0805_2012Metric
R18: 10k PWM disabled low; R_0805_2012Metric
R19: 10k OE default low; R_0805_2012Metric
R20: 100k input default; R_0805_2012Metric
R22: 10k EN default low; R_0805_2012Metric
R23: 10k FAULT pull-up; R_0805_2012Metric
TP13: ENC_A; TestPoint_Pad_D1.5mm
TP14: ENC_B; TestPoint_Pad_D1.5mm
TP15: ESC_PWM; TestPoint_Pad_D1.5mm
TP16: ESC_EN_OUT; TestPoint_Pad_D1.5mm
U5: SN74LVC1G126DBVR; SOT-23-5

Connections:
+3V3: C18.1, C19.1, C20.1, J5.1, R23.1, U5.5 (VCC); also elsewhere on the board
/ENCODER ESC/ENC_A_EXT: J5.3, R11.1
/ENCODER ESC/ENC_B_EXT: J5.4, R12.1
/ENCODER ESC/ENC_Z_EXT: J5.5, R13.1
/ENCODER ESC/ESC_EN_OUT: J6.2, R21.2, R22.1, TP16.1
/ENCODER ESC/ESC_FAULT_EXT_N: J6.3, R23.2, R24.1
/ENCODER ESC/ESC_PWM: J6.1, R17.2, R18.1, TP15.1
/ENCODER ESC/ESC_PWM_DRV: R17.1, U5.4
ENC_A: R11.2, R14.1, TP13.1; also elsewhere on the board
ENC_B: R12.2, R15.1, TP14.1; also elsewhere on the board
ENC_Z: R13.2, R16.1; also elsewhere on the board
ESC_ENABLE: R19.1, R21.1, U5.1; also elsewhere on the board
ESC_FAULT_N: R24.2; also elsewhere on the board
ESC_RX_EXT: J6.6; also elsewhere on the board
ESC_TX_EXT: J6.5; also elsewhere on the board
GND: C18.2, C19.2, C20.2, J5.2, J6.4, J7.3, R14.2, R15.2, R16.2, R18.2, R19.2, R20.2, R22.2, U5.3 (GND); also elsewhere on the board
MOTOR_PWM: R20.1, U5.2; also elsewhere on the board
UART_RX_EXT: J7.2; also elsewhere on the board
UART_TX_EXT: J7.1; also elsewhere on the board

Notes on the sheet:
WHEEL ENCODER - external 3.3 V push-pull ABI module
J5 budget <=20mA. No 5 V, open-drain or differential signals.
No encoder IC fixed: RPM, PPR, magnet and module still TBD.
TIM3 A/B, PC3 index. No analog RC filter on edge inputs.
EXTERNAL ESC - 3.3 V logic only, NO power stage
OE=0: PWM buffer Hi-Z, port pull-down holds low.
Verify ESC stop behavior before motor testing.
UART DEBUG / OPTIONAL ESC UART2
