MiiGoto/reaction-wheel-pendulum/hardware/kicad/reaction_wheel_controller.kicad_pcb

## KiCad design hardware/kicad/reaction_wheel_controller.kicad_pcb (continued)

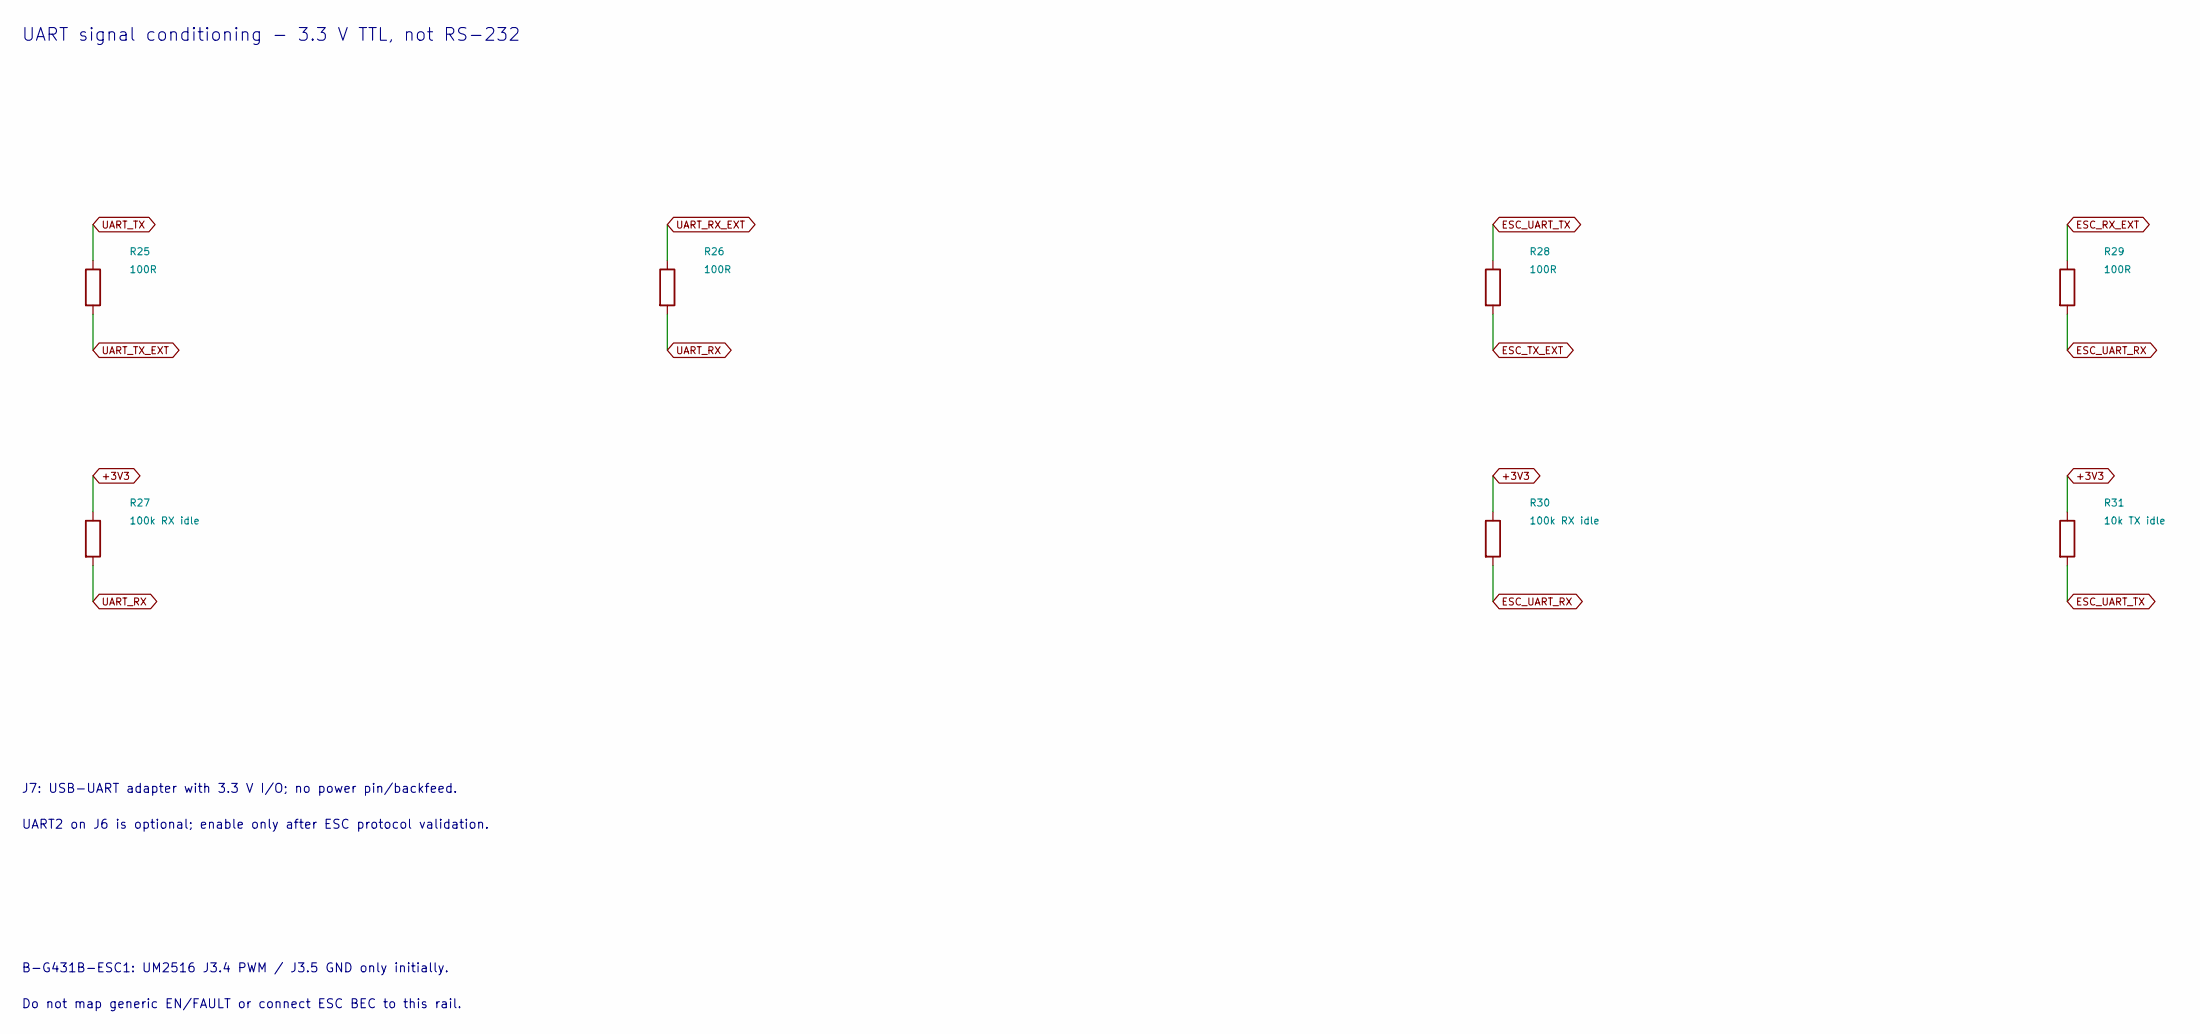
[picture p70: schematic uart_interfaces.kicad_sch, UART conditioning - Task 3]

Parts:
R25, R26, R28, R29: 100R; R_0805_2012Metric
R27, R30: 100k RX idle; R_0805_2012Metric
R31: 10k TX idle; R_0805_2012Metric

Connections:
+3V3: R27.1, R30.1, R31.1; also elsewhere on the board
ESC_RX_EXT: R29.1; also elsewhere on the board
ESC_TX_EXT: R28.2; also elsewhere on the board
ESC_UART_RX: R29.2, R30.2; also elsewhere on the board
ESC_UART_TX: R28.1, R31.2; also elsewhere on the board
UART_RX: R26.2, R27.2; also elsewhere on the board
UART_RX_EXT: R26.1; also elsewhere on the board
UART_TX: R25.1; also elsewhere on the board
UART_TX_EXT: R25.2; also elsewhere on the board

Notes on the sheet:
UART signal conditioning - 3.3 V TTL, not RS-232
J7: USB-UART adapter with 3.3 V I/O; no power pin/backfeed.
UART2 on J6 is optional; enable only after ESC protocol validation.
B-G431B-ESC1: UM2516 J3.4 PWM / J3.5 GND only initially.
Do not map generic EN/FAULT or connect ESC BEC to this rail.

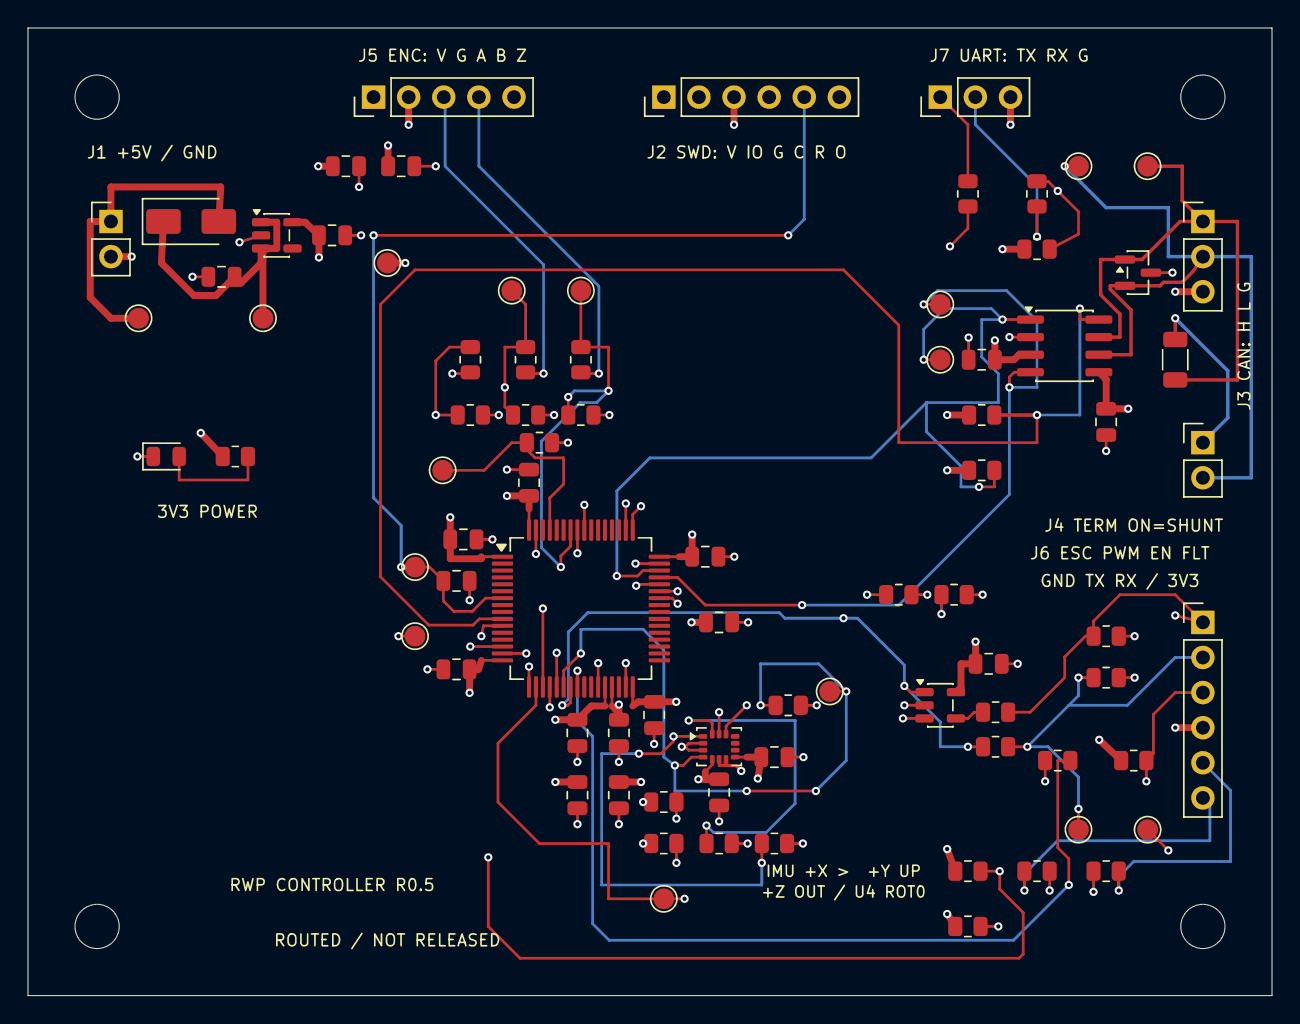
[picture p71: board reaction_wheel_controller.kicad_pcb from above]

Board: 4 copper layers, 90.0 x 70.0 mm, 86 parts (0 on the bottom side), 42 nets.
