MiiGoto/reaction-wheel-pendulum/(commit log)

2026-10-02 hardware: initialize validated KiCad concept project
    [reaction_wheel_controller.kicad_sch]
2026-10-02 hardware: add verified STM32G431 power and SWD circuit
    [mcu_power_swd.kicad_sch, reaction_wheel_controller.kicad_sch]
2026-10-02 hardware: add verified CAN sensor and ESC interfaces
    [can_imu.kicad_sch, encoder_esc.kicad_sch, mcu_power_swd.kicad_sch, reaction_wheel_controller.kicad_sch, uart_interfaces.kicad_sch]
2026-10-02 hardware: review schematic and align mechanical and probe attributes
    [can_imu.kicad_sch, encoder_esc.kicad_sch, mcu_power_swd.kicad_sch, reaction_wheel_controller.kicad_sch]
2026-10-02 hardware: add preliminary PCB outline rules and placement
    [footprint_review.csv, reaction_wheel_controller.kicad_pcb]
2026-10-03 hardware: route power and ground checkpoint
    [reaction_wheel_controller.kicad_pcb, routing_power_stage.csv]
2026-10-03 hardware: record CAN routing and incomplete IMU draft
    [reaction_wheel_controller.kicad_pcb, routing_interfaces_draft.csv]
2026-10-03 docs: verify IMU source and document routing stop
2026-10-04 hardware: complete controller routing and native DRC
    [reaction_wheel_controller.kicad_pcb]
2026-10-08 docs: assess staged Cubli direction and actuator blockers
2026-10-08 mechanical: add validated three-axis clearance concept and screening
    [Cubli_clearance_concept.step, concept_bom.csv]
2026-10-08 simulation: include locked rotor inertia in get-up impulse screen
2026-10-08 analysis: evaluate Cubli sizing and finite-time brake loads
2026-10-08 docs: record Cubli detailed CAD blockers and native assembly status
2026-10-08 mechanical: create native one-wheel module with constrained motion and review exports
    [01_Wheel_Rim.step, 02_Wheel_Hub.step, 03_Wheel_Spokes.step, 04_Wheel_Shaft.step, 05_Bearing_Housing.step, 06_Motor_Mount.step, 07_Brake_Drum.step, 08B_Brake_Pad.step]
2026-10-08 mechanical: create lightened Rev B module and three-axis integration study
    [01_Wheel_Rim.step, 02_Wheel_Hub.step, 03_Wheel_Spokes.step, 04_Wheel_Shaft.step, 05_Bearing_Housing.step, 06_Motor_Mount.step, 07_Brake_Drum.step, 08B_Brake_Pad.step]
